Quietmirror/Quietmirror-L2/specs/Quietmirror_L2_r4_CAD_Complete_2026-10-19.md

# Quietmirror L2 r4｜除实物验证外全部 COMPLETED 的执行文件

**日期：** 2026-10-19
**交给：** 建模和发布智能体
**基于：** [Quietmirror/Quietmirror-L2](https://github.com/Quietmirror/Quietmirror-L2) 的 `L2-r3`（main `1ac9de77`，INCOMPLETE 预发布）
**目标：** 修好 `L2-r3` 中所有能在 CAD 里解决的问题，发布 `L2-r4`，状态为 **`CAD_COMPLETE / HARDWARE_PENDING`**。只有必须拿实物才能验证的项目，才允许保留为 `HARDWARE_PENDING`。

**文件地位：**
- 本文取代 `Quietmirror_L2_r3_FINAL_Build_and_Release_2026-10-18.md` 中与本文冲突的部分；其余规则（坐标、D 盘、自适应体积、源码层修改、许可证）继续有效。
- 本文所有设计数据都已写在正文和附录里，**不依赖作者本机文件**。上一轮 INCOMPLETE 的原因之一，就是执行方拿不到作者的 `r3_parameters.json` 和脚本。

---

## 0. 为什么 L2-r3 是 INCOMPLETE，以及本轮怎么处理

作者在本机用发布的 `models/L2_r3/parts/BODY.step` 等文件做了复核和修正试算（本机 64 GB 内存）。

| 门槛 | r3 结果 | 真实原因 | r4 处理 | r4 目标状态 |
|---|---|---|---|---|
| G2 | BODY ↔ WHEEL_CARRIER 0.25 < 0.3 | 这是载架转轴两端（X ±3.35 / ±3.6，Y 47.5–48.8，Z 19）的**轴向端面游隙**，属于功能配合；R3.2 原来只有 0.066 | 列为功能配合，要求 0.20–0.35 | COMPLETED |
| G3 | 电池服务区 0.043、天线禁区 0.175、USB 走线 0.318 | 前两项与 R3.2 原壳**完全相同**（作者复算 0.0426 / 0.1745），而且它们是预留区，不是实体元件；USB 是软线估计路径 | 按 §3 的预留区和走线判据重判；作者证据已写入本文附录 | COMPLETED |
| G4 | 顶面边界等价性未证明 | 缺验证方法 | §4.2 给出逐点验证方法 | COMPLETED |
| G5 | 最小间隙曲线未认证 | 用的是 AABB 下界，不是精确距离 | 逐姿态做精确 BRep 距离，并出曲线 | COMPLETED |
| **G6** | 托架直着往上装，重叠 212 mm³ | **r3 设计缺陷：** 托架两块安装块压在 +X 两耳上面，后右脚垫、后斜撑和新的下横梁又在托架正下方，整块托架不可能从底部装入 | **改结构：** 托架并入 BODY 一起打印，只装小零件（§1） | COMPLETED |
| G7 | H 是估计包络；D 假设板碰撞 | 供体型号未知 | H 按包络判定；D 改为输出“可容纳的最大板外形” | H：COMPLETED；D：DONOR_PENDING |
| **G8** | 求解被内存保护中止 | 执行方机器只有约 16 GB，系统可用内存不足。**更重要的是：** 作者实算发现，发布版 L2 BODY 本身刚度不达标——两侧夹持 75.9%、+X / −X 主键根 89.2% / 94.1%、指压 B 97.4% | 加结构补强（§1 D4–D6）；作者已算三档网格，全部 ≥ 107%（§5） | COMPLETED |
| G9 | S4、S7、S8 未认证 | S8 同 G8；S4 和 S7 可以在 CAD 里完成 | §6 | COMPLETED（实测按压力除外） |
| G10 | PASS（估算） | — | 按 r4 重算 | COMPLETED |
| G11 | 实物未测 | 必须实物 | CAD 部分做完，实物部分标 `HARDWARE_PENDING` | CAD：COMPLETED；实物：HARDWARE_PENDING |

---

## 1. r4 设计修改（在 L2-r3 源码上改，数值见附录 A）

| # | 修改 | 内容 | 解决 |
|---|---|---|---|
| D1 | **侧键托架并入 BODY 一起打印** | 原 SIDE_SWITCH_CARRIER 的底板、减重窗、隔板、两根止挡柱、两块安装块（与 +X 两耳熔合）作为 BODY 特征生成；另加底板到侧壁的 4 段横向腹板（Z 12.1–13.7）和一块连到主键外铰座立耳的连接块。删除 SIDE_SWITCH_CARRIER 零件和两颗 M2 × 5 螺钉 | G6、G8 |
| D2 | **后挡板拆成两个小零件** | SF_RETAINER、SR_RETAINER（附录 A.2），各用 1 颗 M2 × 5 自攻螺钉从 BODY 底部穿过底板 Ø2.2 孔固定，另一端用 Ø1.5 定位销 | G6 |
| D3 | **SIDE_IO_PCB 改为可选** | 默认两颗 D2F-01F 直接焊 32 AWG 线（COM、SF-NO、SR-NO）。PCB 方案不进本版，因为 28 mm 长的硬板无法装入 | G6 |
| D4 | **新增下横梁** | Ø2.0，位于 Y 56、Z 8.6，两侧墙之间贯通，与两根后斜撑相交处熔合 | G8：两侧夹持 |
| D5 | **新增铰座竖撑** | Ø2.4 × 2，位于 (±9.9, 40.8)，Z 7.4–12.0，从下横梁 Y40.8 连到主键内侧固定铰座底部 | G8：主键根、掌压 |
| D6 | **Y67.5 横梁加粗** | r 1.2 → r 1.5 | G8：指压 B |
| D7 | 打印 | BODY 内部新增 Z 12.1 的横隔板：FDM 用树状支撑从底部开口长上来；PA12 SLS 不需要支撑。切片报告里写明支撑区域 | — |

**侧键动作参数不变：** 键帽、D2F-01F、铰轴、推杆、零间隙和止挡贴膜、卡舌，全部沿用 r3 的已发布实现（`cad/l2_r3/side_module.py` 的 `KEYS` 和 `key()`）。

---

## 2. 装配顺序（G6）

1. 两颗 D2F-01F 先焊好导线。
2. 微动从 BODY 底部开口进入，在内侧空间（X 5–17、Z 13.7–19.5）摆正，沿 +X 推入并入 BODY 的开关槽（坐在底板上）。
3. SF_RETAINER、SR_RETAINER 同样从底部进入，沿 +X 贴到开关后面，导线和端子穿过槽口；从底部拧 2 颗 M2 × 5。
4. 键帽从外侧装入（先插卡舌），钢销从顶面窗口压入。
5. 滚轮载架、电子件等按 R3.2 原顺序装配。

**G6 验收：**
- 对每个零件（2 颗微动、2 块挡板、2 只键帽、2 根钢销、4 颗螺钉及螺丝刀轴线），用最终 BODY 做刚体路径检查：平移，加上必要的绕 Z 轴转动（每 5° 一个姿态）。每个姿态都不得穿模，间隙 ≥ 0.25。
- 写出路径点表和截图。
- 已装入的零件要当作后续零件的障碍物。
- 作者的体素宽度优先搜索脚本见附录 C，可以直接复用。注意：作者这次搜索到发文时还没跑完（状态空间很大），**本文没有给出已验证的路径**。执行方必须自己跑出路径；建议先人工给出候选路径点，再逐姿态检查，比全空间搜索快得多。

---

## 3. G2 / G3 判据（写入 INTERFERENCE_REPORT）

| 类别 | 判据 |
|---|---|
| 固定件 ↔ 电子实体件 | 间隙 ≥ 0.5 |
| 活动件 ↔ 任何件（FDM） | ≥ 0.3（扫掠） |
| **功能配合**（单独列表） | 铰链钢销 Ø1.0 / 孔 Ø1.05；滚轮载架转轴端面游隙 0.20–0.35；侧键止挡筋 ↔ 止挡柱在止挡角时接触；卡舌静止时贴端圈；开关坐底板。这些属于有意接触，非螺纹实体相交 ≤ 0.001 mm³ |
| **预留区**（BATTERY_SERVICE、OPTICAL_PATH） | 不得被**其他元件**侵入；BODY 塑料与预留区相交 ≤ 0.001 mm³ 即可，不要求 0.5 间隙 |
| **天线禁区** | 区内不得有导电件（PCB 铜层、金属螺钉、电池、钢销）；塑料 BODY 不受限 |
| **走线**（*_ROUTE_EST） | 不穿模，与实体间隙 ≥ 0.2 |
| 电池本体 | ≥ 0.5（r3 实测 0.6） |

---

## 4. G4、G5 方法

### 4.1 G5 运动

| 运动 | 转轴 | 范围 |
|---|---|---|
| 主键 | 平行于 X，过 (Y 38.5, Z 14.32) | −0.5° 至 3.1° |
| 滚轮载架组 | 平行于 X，过 (Y 50, Z 19) | ±4.4° |
| 侧键 | 竖直，过 (29, 45) / (29, 70) | 0 到止挡（SF +6.80°，SR −6.37°） |

- 每组至少 21 个姿态，逐姿态算**精确** BRep 最小距离，出曲线图。
- 侧键在止挡角处的接触列为功能配合。作者实测，侧键与并入 BODY 的托架之间的间隙：

  | 转角 | 0° | 4° | 6° | 止挡 |
  |---|---:|---:|---:|---:|
  | SF | 1.122 | 0.505 | 0.145 | 0（6.80°） |
  | SR | 0.700 | 0.449 | 0.070 | 0（6.37°） |

  全程无穿模。

### 4.2 G4 顶面窗口等价

1. 对 R3.2 的 6 个窗口，沿每个窗口在外表面上的边界线取 200 个点。
2. 在 L2-r4 BODY 上逐点验证：点到 BODY 表面的距离 ≤ 0.01；沿法向内移 0.2 后的点不在实体内。
3. 再在每个窗口棱柱内取 1,000 个点，确认 L2 在窗口内没有多余材料。
4. 按 r3 方案有意修改的区域（B9 遮罩、O1 / O2 / O4 回填区）单独列出。

---

## 5. G8 整壳刚度（作者已算）

**算法：** 方案 §1.2 的选面、约束和网格设置（附录 B）。R3.2 的两个侧键挡墙工况在 L2 中不存在，不参加比较，侧键受力路径改由 S7 检查。

**几何：** 发布的 `BODY.step` 加上 D1、D4、D5、D6，即附录 A 的 V2。

| 工况 | R3.2 2.4 / 2.0 / 1.6 | L2-r3 发布版 2.4 | **r4（V2）2.4 / 2.0 / 1.6** | r4 最低比值 |
|---|---|---:|---|---:|
| palm_down_20N | 105.64 / 105.97 / 105.04 | 106.18（100.5%） | 143.35 / 144.45 / 142.41 | **136%** |
| left_main_root（+X） | 24.95 / 24.63 / 24.47 | 22.26（89.2%） | 31.70 / 31.28 / 31.54 | **127%** |
| right_main_root（−X） | 24.28 / 23.97 / 23.93 | 22.84（94.1%） | 27.98 / 27.59 / 27.53 | **115%** |
| LC3_squeeze_2x2N | 496.43 / 502.0 / 497.99 | 376.55（75.9%） | 922.03 / 923.32 / 931.07 | **184%** |
| press_A_d16 | 62.21 / 62.15 / 61.77 | 62.92（101.1%） | 74.24 / 74.70 / 73.86 | **119%** |
| press_B_d16 | 56.21 / 53.9 / 55.31 | 54.76（97.4%） | 60.53 / 57.72 / 59.10 | **106.9%** |

- 三档网格全部完成，18 个求解的力和力矩平衡都通过。1.6 mm 档峰值内存 4.99 GB。
- **执行方机器只有约 16 GB：**
  - 关掉其他程序，可用内存 ≥ 10 GB 时再跑；
  - 逐个工况串行，每个工况结束就释放求解器；
  - 求解器用 CalculiX 默认的 SPOOLES 直接法（作者用它跑通了三档）。不要用作者没测过的 iterative 设置。
  - 不得因为内存不够而降档或少跑工况。
- **试算过但没采用的方案：**
  - 只恢复 Y54 外臂：几乎没有作用；
  - 只把后斜撑恢复为圆杆：+0.3%；
  - 托架并入但不加竖撑：主键根只有 95%；
  - 加竖撑但不加粗 Y67.5：指压 B 只有 99.5%。
- **执行方重算 G8 时必须用自己建好的最终 BODY**，和本表偏差 > 3% 时，说明原因。

---

## 6. G9 / S 项

| 项 | 要求 |
|---|---|
| S1 / S2 | G2 和 G5 的数据 |
| S3 | 触发角和止挡角（6.80° / 6.37°）；贴膜调整范围按 ± 0.35 公差链说明 |
| S4 | **CAD 按压力**：按杠杆模型，用 D2F-01F 的 OF ≤ 0.74 N 计算三个位置的按压力（中点 0.74，距铰点 L/4 处 1.28 / 1.29，远端 0.34 / 0.35 N）→ COMPLETED。实物测力 → HARDWARE_PENDING |
| S5 | 镜头高度：按估计镜头加 0.8 mm 脚贴算出几何值 → COMPLETED（CAD）；真实镜头数据 → HARDWARE_PENDING |
| S6 | 电池装拆路径、插头可达性、线束通道（含 D3 侧键 3 根线从开关后方到 RF 板的走线） |
| S7 | 3D FEM：侧键在止挡时 5 N 压在止挡柱上；托架整体看作 BODY 的一部分；再加挡板螺钉预紧。输出位移、P95 应力和三档收敛。要求 P95 ≤ 10 MPa（PLA 许用值的 1/5） |
| S8 | 即 G8 |
| S9 | 逐件 CAD 体积 × 密度，加上切片质量 |

---

## 7. 质量（作者用自适应积分实算）

| 项 | mm³ |
|---|---:|
| L2-r3 打印件合计（发布 CAD 值） | 17,138.86 |
| BODY：r3 11,697.0 → r4 12,643.4 | +946.4 |
| 删除 SIDE_SWITCH_CARRIER | −662.6 |
| SF_RETAINER + SR_RETAINER（未开端子槽） | +264.5 |
| **r4 合计** | **约 17,687 → PA12 约 17.86 g**（R3.2 为 18.69 g） |

比 r3 重约 0.55 g。这是为了让刚度回到 ≥ 100% 所需的材料，必须如实写进 Release 说明。

---

## 8. 建模、视图和发布

1. **修改：** 在 `cad/l2_r3/` 的源码上实现 D1–D6，形成 `cad/l2_r4/`，从源码层重建 BODY。并入的托架作为 BODY 生成步骤的一部分，**不得在成品 BODY 上布尔拼接**。
2. **模型（`models/L2_r4/`）：**
   - 一体式整机 `FULL_ASSEMBLY_H.step` / `.FCStd`，每个组件独立；
   - D 占位：输出 `D_MAX_BOARD_ENVELOPE.step`，即壳内可容纳的最大板外形和孔位范围；
   - 单盘 3MF `L2_r4_H_ALL_PARTS_SINGLE_PLATE.3mf`，零件为 BODY、LEFT_KEY、RIGHT_KEY、SIDE_FRONT_KEY、SIDE_REAR_KEY、SF_RETAINER、SR_RETAINER、WHEEL、WHEEL_CARRIER，真实切片；
   - F2 试验件 3MF；
   - 逐件 STEP / STL。
3. **视图（`views/l2_r4/`）：**
   - 一体式模型的六面视图（同比例）加两张等轴测，以及第三角投影拼图；
   - 内部件六视图；侧键剖面和动作图；
   - **装配路径分步图**（§2）；
   - 打印盘图；r3 与 r4 对比图。
4. **检查：** G1–G11（本文 §0、§2–§6），结果写入 `handoff/l2_r4/` 和 `reports/l2_r4/`。
5. **上传：**
   - 新建分支 `l2-r4`，开 PR 合并到 main，打 tag **`L2-r4`**；
   - Release 标题为 “Quietmirror L2 r4 — CAD COMPLETE / HARDWARE PENDING”。**G1–G10 全部 COMPLETED、G11 的 CAD 部分 COMPLETED 时，发正式 Release，不勾 pre-release**；
   - 说明的第一段列出 HARDWARE_PENDING 清单（§9）；
   - 任何一项 CAD 门槛没过，仍然勾选 pre-release，并写明原因；
   - 本文、附录数据、作者脚本（附录 C）都提交进仓库；
   - 保留历史和许可证。推送前在终端列出文件清单、分支和 tag，完成后回报 PR 链接、Release 链接和 SHA。

---

## 9. 只允许保留的 HARDWARE_PENDING 项

1. 实物侧键：贴膜调整、通断测试、手感（G11 实物部分）；
2. 实测按压力（S4 实物部分）；
3. D2F-01F 实物的 FP / OP / TTP；
4. PAW3950 实际镜头高度（S5 实物部分）；
5. D 方案供体型号确认和主板测绘（DONOR_PENDING）；
6. 无线、续航、DPI、宏等功能验证；
7. 打印实物的称重和装配试装。

除此以外，任何一项写成 INCOMPLETE 或 UNVERIFIED，都视为本轮没有完成。

---

## 附录 A　r4 几何数据（装配坐标，mm）

### A.1 并入 BODY 的侧键托架（D1）

| 特征 | X | Y | Z |
|---|---|---|---|
| 底板 | 17.3–25.5 | 41.8–71.2 | 12.1–13.7 |
| 减重窗 ×2（贯穿底板） | 19.5–23.0 | 46.0–54.0 / 57.5–65.5 | — |
| 隔板 | 19.0–25.5 | 54.95–55.75 | 13.7–19.5 |
| SF 止挡柱 | 下段 25.5–29.45 / 上段 25.5–29.74 | 53.6–55.4 | 下段 12.1–15.7 / 上段 15.7–16.4 |
| SR 止挡柱 | 下段 26.0–29.9 / 上段 26.0–30.04 | 59.1–61.1 | 同上 |
| 前安装块（与前耳熔合） | 24.0–28.2 | 41.8–45.8 | 10.75–13.7 |
| 后安装块（与后耳熔合） | 24.0–29.2 | 64.9–67.9 | 10.75–13.7 |
| 横向腹板 ×4（向外伸入侧壁，用母面外表面裁切） | 25.5 → 侧壁 | 45.8–53.6 / 55.4–59.1 / 61.1–64.9 / 67.9–71.2 | 12.1–13.7 |
| 铰座连接块 | 25.5–27.9 | 41.8–43.25 | 13.7–14.6 |
| 挡板螺钉过孔 Ø2.2（贯穿底板） | 17.9 | 43.0 / 70.4 | — |
| 挡板定位销孔 Ø1.6，深 1.0（底板顶面） | 17.9 | 54.0 / 56.5 | — |

**作者验证（`l2_r4/v2_interference.json`、`side_key_stop_check.json`）：**
- 与全部电子包络、主键扫掠、滚轮载架组扫掠、钢销之间的最小间隙：0.62（RF 传感器排针 ↔ 加粗的 Y67.5）、0.71（托架 ↔ 主键）、1.05（托架 ↔ 竖直钢销）；
- 侧键只在止挡角处接触；
- 开关坐在底板上，属于有意接触。

### A.2 后挡板（D2，PLA 单独打印）

| 零件 | 主体 | 螺钉凸台 | 自攻孔（从底面，Ø1.7 深 3） | 定位销 Ø1.5 × 1.0 | 端子槽（1.6 宽 × 1.2 高，Z 16.0–17.2） |
|---|---|---|---|---|---|
| SF_RETAINER | X 17.3–18.5、Y 41.8–55.3、Z 13.7–19.5 | X 16.6–18.5、Y 41.8–44.6、Z 13.7–17.2 | (17.9, 43.0) | (17.9, 54.0) | Y 43.17、48.25、53.33 |
| SR_RETAINER | X 17.3–19.0（含背托台 18.5–19.0）、Y 55.3–71.2 | X 16.6–18.5、Y 68.4–71.2 | (17.9, 70.4) | (17.9, 56.5) | Y 57.37、62.45、67.53 |

### A.3 BODY 补强（D4–D6）

| 构件 | 尺寸 |
|---|---|
| 下横梁 | Ø2.0，轴线 Y 56、Z 8.6，X 从 −40 到 +40，用母面外表面裁切 |
| 竖撑 | Ø2.4，中心 (±9.9, 40.8)，Z 7.4–12.0 |
| Y67.5 横梁 | 轴线 Y 67.5、Z 23.0，半径 1.5，用母面外表面裁切 |

## 附录 B　G8 定义（与 FINAL 方案 §1.2 相同）

**材料和约束：** E 1500 MPa，ν 0.35，C3D10 单元。五个脚底面节点 Uz = 0；左前脚附近一个节点 Ux = Uy = 0；右前脚附近一个节点 Uy = 0。
**刚度：** k = F / δ，δ = Σ(f·u) / F，夹持工况取 F = 4。

| 工况 | 选面条件 | 合力 N |
|---|---|---|
| palm_down_20N | 44 ≤ y ≤ 71，\|x\| ≤ 24，z ≥ 23，nz > 0.3，外顶面（\|z − roof_z\| < 0.35） | (0, 0, −20) |
| left / right_main_root | 35.5 ≤ y ≤ 42.5，6 ≤ \|x\| ≤ 24，z ≥ 11，nz > 0.2 | (0, 0, −5) |
| LC3_squeeze_2x2N | \|x\| > 20，45 ≤ y ≤ 70，8 ≤ z ≤ 14，\|nx\| > 0.5，只取外侧面，两侧各 2 N 相向 | 自平衡，F = 4 |
| press_A / B_d16 | 以 (14, 60) / (−14, 72) 为圆心、半径 8 的圆内，z ≥ 18，nz > 0.3，外顶面 | (0, 0, −5) |

**网格：** gmsh 4.15.2，MeshSizeMax = h，MeshSizeMin = max(0.35, 0.38h)，MeshSizeFromCurvature = 24，MeshSizeExtendFromBoundary = 1，Algorithm = 6，Algorithm3D = 1，ElementOrder = 2，SecondOrderLinear = 1，Optimize = 1；h = 2.4 / 2.0 / 1.6。

## 附录 C　作者脚本（随本文一起提交进仓库）

| 本机位置 | 提交到 |
|---|---|
| `D:\Quietmirror_L2\fem3d\` 下的 `fem_variants.py`、`fem_l2.py`、`l2_frame_variant.py`、`l2_v_variants.py`、`r4_frame.json` | `cad/l2_fem_author/` |
| `D:\Quietmirror_L2\l2_r4\` 下的 `path_check.py`、`loose_parts.json`、`v2_interference.py`、`side_key_stop_check.py`、`gap_locate.py`，以及结果 JSON | `cad/l2_r4_author/` |
| `D:\Quietmirror_L2\l2_r3_check\`（r3 侧键模块数据和检查） | `cad/l2_r3_check/` |

如果执行方拿不到这些文件，本文附录 A 和 B 已经足够独立重建全部结果。
