Quietmirror/Quietmirror-L2/specs/Quietmirror_L2_r4_EXECUTE_ALL_2026-10-19.md

# Quietmirror L2 r4｜一次执行到底（建模 + 检查 + 视图 + 发布）

**交给：** 建模和发布智能体
**日期：** 2026-10-19
**仓库：** [Quietmirror/Quietmirror-L2](https://github.com/Quietmirror/Quietmirror-L2)

| 分支 | 内容 |
|---|---|
| `main`（`1ac9de77`） | 已发布的 `L2-r3`（INCOMPLETE 预发布） |
| `l2-r4`（`54dac615`） | 作者证据包：脚本、结果 JSON、并入托架的几何 |

**目标：** 发布 **`L2-r4`**，状态写成 **`CAD_COMPLETE / HARDWARE_PENDING`**。只有 §9 列出的实物项目可以留到以后。

**本文自成一体：** 所有设计数据、判据、路径和参考结果都写在正文和附录里。执行时不需要作者本机的任何文件。作者的脚本和结果也放在 `l2-r4` 分支里，可以直接拿来对照。

---

## 0. 执行规则（必须遵守）

1. **一次做完：** 按 §2 的步骤顺序执行，**不要停下来等确认**。只有满足下面任一条件时才停下来问用户：
   - 本文和仓库事实冲突，而且无法自行判断哪个对；
   - 需要删除仓库历史，或者覆盖 `L2-r3` 的 tag 或 Release。
2. **失败就修，修完重验：** 任何门槛不过，先定位原因，修改模型（只能在源码层改），然后重跑**该门槛和所有受影响的门槛**。每一轮都写进 `handoff/l2_r4/TUNING_LOG.md`。
3. **不得降低标准：**
   - 不得放宽判据；
   - 不得把 CAD 能验证的项目改标 `HARDWARE_PENDING`；
   - 不得用 AABB 下界冒充精确距离；
   - 不得因为内存不足而少跑网格或工况；
   - 不得编造数值。
4. **资源：**
   - 有限元串行跑，开始前关掉其他程序，确认可用内存 ≥ 10 GB；
   - 求解器用 CalculiX 默认的 SPOOLES 直接法；
   - 如果被系统中止，查明原因后重跑同一档，不得跳过。
5. **体积：** 一律用 `BRepGProp.VolumeProperties_s(shape, props, 1e-8, True, False)`。
6. **基准：**
   - 以 `L2-r3` 源码（`cad/l2_r3/`）为起点，产出 `cad/l2_r4/`；
   - R3.2 原始基准是 Quietmirror/github @ `f1b1090931d717117287ea2b79c2e14ddc234937`；
   - 坐标沿用 R3.2：+X 为拇指侧（侧键侧），Y 值小的一端为前，Z 向上；脚贴粘贴面 Z 5.2。

---

## 1. 为什么要做 r4（结论已经由作者实算）

| L2-r3 的问题 | 原因 | r4 的解决方法 |
|---|---|---|
| G6：托架装不进去（直上重叠 212 mm³） | 托架两块安装块压在 +X 两耳上面，后右脚垫和后斜撑又在托架正下方，整块托架不可能装入 | **托架并入 BODY 一起打印**，需要装入的只剩小零件；装入路线已经验证（§4） |
| G8：整壳刚度不达标（执行方因内存不足没有算出来） | 作者用发布的 BODY 实算（2.4 mm 网格）：两侧夹持 75.9%、+X / −X 主键根 89.2% / 94.1%、指压 B 97.4%。原因是拆掉旧侧键座后 +X 侧壁变软，同时内侧固定铰座被削掉了 0.25 mm | 托架并入 BODY，再加下横梁、铰座竖撑，并把 Y67.5 横梁加粗；三档网格全部 ≥ 106.9%（§5） |
| G2：BODY ↔ 滚轮载架 0.25 | 这是转轴的轴向端面游隙，属于功能配合 | 按功能配合判，要求 0.20–0.35 |
| G3：电池服务区、天线禁区、USB 走线间隙不足 | 前两项和 R3.2 原壳完全相同，而且是预留区，不是实体；USB 是软线 | 按 §6 的预留区和走线判据 |
| G4、G5：证明方法不够 | — | 按 §6 的方法做 |

---

## 2. 执行步骤

| 步 | 做什么 | 产出 | 通过标准 |
|---|---|---|---|
| S0 | 拉取 `main` 和 `l2-r4`；建工作分支 `l2-r4-build`（基于 `main`）；把 `l2-r4` 分支里的 `specs/`、`cad/l2_r4_author/`、`cad/l2_fem_author/`、`cad/l2_r3_check/` 合入工作分支 | 工作分支 | 文件齐全 |
| S1 | 在 `cad/l2_r3/` 源码上实现附录 A 的 D1–D6，形成 `cad/l2_r4/`，从源码层重建 BODY。托架作为 BODY 生成步骤的一部分生成，不得在成品 BODY 上布尔拼接 | `BODY.step` | 单一有效实体；能用 gmsh 生成网格 |
| S2 | 建 SF_RETAINER、SR_RETAINER（附录 A.2）；删除 SIDE_SWITCH_CARRIER、两颗 CARRIER_M2x5 螺钉和 SIDE_IO_PCB；其余零件沿用 L2-r3 | 逐件 STEP / STL | 每件都是单一有效实体 |
| S3 | 组装一体式模型（§7）；H 方案的电子包络沿用 L2-r3；加入 2 根侧键焊线的走线（附录 A.4） | `FULL_ASSEMBLY_H.step` / `.FCStd` | 89 个以上独立组件，全部有效 |
| S4 | 跑 G1–G5（§6） | `reports/l2_r4/*.json`、`INTERFERENCE_REPORT.md` | §6 判据 |
| S5 | 跑 G6（§4）：按给定装配顺序和路线逐姿态检查 | `ASSEMBLY_SEQUENCE.md` + 分步截图 | §4 判据 |
| S6 | 跑 G8 / S7（§5、§6） | `INTERNAL_COMPONENTS_SIMULATION.md` + 数据 | 每个工况三档网格都 ≥ R3.2 的 100%；S7 的 P95 ≤ 10 MPa |
| S7 | G7、G9、G10、G11-CAD（§6） | 对应报告 | §6 |
| S8 | 切片（§7） | 单盘 3MF + `SLICE_REPORT.md` | 真实切片，一个盘放下全部零件 |
| S9 | 视图（§8） | `views/l2_r4/` | 六面视图 + 等轴测 + 拼图齐全 |
| S10 | 门槛总表（G1–G11）。有任何 CAD 门槛不过，回到对应步骤修改，**不得进入 S11** | `handoff/l2_r4/GATES.md` | 所有 CAD 门槛 COMPLETED |
| S11 | 发布（§10） | PR、tag `L2-r4`、Release | §10 |
| S12 | 回报（§11） | 消息 | — |

---

## 3. r4 设计（摘要；数值见附录 A）

| # | 修改 |
|---|---|
| D1 | **侧键托架并入 BODY**：底板、减重窗、隔板、两根止挡柱、两块安装块（与 +X 两耳熔合）、4 段横向腹板（底板到侧壁）、主键外铰座连接块 |
| D2 | **后挡板拆成两件**（SF_RETAINER、SR_RETAINER），各用 1 颗 M2 × 5 自攻螺钉从底部穿过底板固定，另一端用定位销 |
| D3 | **默认不用 SIDE_IO_PCB**：两颗 D2F-01F 直接焊 32 AWG 线（COM、SF-NO、SR-NO） |
| D4 | **下横梁** Ø2.0，Y 56 / Z 8.6，贯穿两侧墙 |
| D5 | **铰座竖撑** Ø2.4 × 2，位于 (±9.9, 40.8)，Z 7.4–12.0 |
| D6 | **Y67.5 横梁** r 1.2 → r 1.5 |
| D7 | **侧键键帽改为直线装入**：取消远端卡舌，铰轴内移 0.3（SF Y 45.3、SR Y 69.7），铰节 Ø2.5，新增铰链止动耳和铰耳扇形槽，推杆压盘 Ø2.6（§4.4） |

D2F-01F、推杆位置、零间隙和止挡贴膜，沿用 L2-r3 已发布的实现（`cad/l2_r3/side_module.py`），按 D7 修改。

---

## 4. G6 装配顺序和装入路线（作者已验证）

**验证方法：**
- V2 BODY（= 发布的 BODY 加 D1、D4、D5、D6）三角化后，用竖直射线奇偶法体素化，体素 0.25 mm；
- 再整体膨胀 0.25 mm，相当于要求间隙 ≥ 0.25；
- 零件用 0.25 mm 间距的内部点云表示；
- 平移每 0.25 mm 检查一个姿态，绕 Z 轴转动每 5° 检查一个姿态；
- 已装好的零件计为后续零件的障碍物。微动端子穿过挡板槽口属于设计配合，不计碰撞。

**结果：** 共 759 个姿态，**全部无碰撞**。

### 4.1 顺序

1. 两颗 D2F-01F 先焊好导线；
2. **SR 微动** → 3. **SF 微动** → 4. **SR 挡板** → 5. **SF 挡板**，四件都从 BODY 底部开口进入；
6. 从底部拧 2 颗 M2 × 5，固定两块挡板；
7. 键帽从外侧沿 −X 直线推入（D7，§4.4）。推杆压盘上的 PET 调整膜在推入前贴好；
8. 钢销从顶面窗口压入；
9. 其余按 R3.2 原顺序装配（滚轮载架、主键微动、主键、电子件）。

> 顺序不能换：SF 微动的路线会经过 SR 挡板的位置，所以 SF 微动必须先于 SR 挡板装入。

### 4.2 路线

表中坐标是零件**相对最终位置的偏移**（mm）。yaw 是绕零件中心竖直轴的转角（°）。路线按“从壳外到装好”的顺序列出。

**SR 微动**（最终本体 X 19.0–25.5、Y 56.05–68.85、Z 13.7–19.5）：

(−16.25, 1.55, −14.75, 90) → (−16.25, 1.55, −10.5, 90) → (−16.25, 1.8, −10.5, 90) → 原地转到 yaw 0 → (−16.25, 1.8, +0.5, 0) → (−16.25, 0, +0.5, 0) → (−0.5, 0, +0.5, 0) → 落座

**SF 微动**（最终本体 X 18.5–25.0、Y 41.85–54.65、Z 13.7–19.5）：

(−15.75, 15.75, −14.75, 90) → (−15.75, 15.75, −10.5, 90) → (−15.75, 16.0, −10.5, 90) → 转到 yaw 0 → (−15.75, 16.0, +0.25, 0) → (−15.75, 13.0) → (−12.5, 13.0) → (−12.5, 12.75) → (−12.25, 12.75) → (−12.25, 9.5) → (−8.75, 9.5) → (−8.75, 9.25) → (−8.5, 9.25) → (−8.5, 3.0) → (−6.75, 3.0) → 转到 yaw 90 → (−6.75, 2.0) → (−5.25, 2.0) → (−5.25, 1.75) → (−5.0, 1.75) → (−5.0, −0.5) → (−3.25, −0.5) → 转回 yaw 0 → (−3.25, −0.5, +0.5) → (−3.25, 0, +0.5) → (−0.5, 0, +0.5) → 落座

中间各点 Z 均为 +0.25。

**SR 挡板：**

(−12.15, 2.2, −14.75, 0) → (−12.15, 2.2, +0.3, 0) → (−12.15, 0, +0.3, 0) → (−4.5, 0, +0.3, 0) → (−0.3, 0, +0.3, 0) → 落座

**SF 挡板：**

(−11.85, 15.8, −14.75, 90) → (−11.85, 15.8, −10.5, 90) → (−11.85, 16.05, −10.5, 90) → 转到 yaw 0 → (−11.85, 16.05, +0.3, 0) → (−11.85, 13.0) → (−10.3, 13.0) → (−10.3, 9.5) → (−6.5, 9.5) → (−6.5, 2.0) → (−4.5, 2.0) → (−4.5, 0) → (−0.3, 0, +0.3) → 落座

**执行方要做的：**
- 用最终 BODY 和最终零件，以同样的方法重跑这些路线：脚本是 `cad/l2_r4_author/guided_paths.py`，路线数据 `guided_routes.json`，零件数据 `loose_parts.json`；
- 再对每条路线的转折点做**精确** BRep 距离复核；
- 如果最终 BODY 有偏差导致碰撞，在碰撞点附近局部调整路线点，并记录调整内容。

### 4.3 键帽、钢销、螺钉

- **键帽：改为沿 −X 直线推入（r4 设计修改 D7，见 §4.4 和附录 A.6）。** 原来那条“先插卡舌”的路线已被作者证明不可行（§4.4），所以取消远端卡舌，把外向限位改到铰链处。
- **钢销：** 从顶面窗口竖直压入。执行方在 L2-r3 已用 Ø2 探针验证可达，r4 要用最终 BODY 复验。
- **挡板螺钉：** 竖直从底部拧入，位置 (17.9, 43.0) 和 (17.9, 70.4)。螺丝刀轴线（Ø4 圆柱，从 Z 0 到 12.1）不得碰到 BODY。

### 4.4 键帽路线的精确复核（作者）

**作者的精确 BRep 复核（`cad/l2_r4_author/key_paths_exact.py`）：** 用 L2-r3 发布的键帽和 V2 BODY，检查“先插卡舌”路线：绕卡舌附近的竖直轴把铰链端向外摆出 15°，沿 Y 滑出 1.5，再沿 +X 移出。

**结论：不可行。**

| | 转 2° | 转 3° | 转 15° | 滑出和移出阶段 |
|---|---:|---:|---:|---:|
| SF 相交体积 mm³ | 0.0007 | 0.037 | 2.04 | 仍有 0.01–0.16 |
| SR 相交体积 mm³ | 0.0019 | 0.049 | 2.02 | 0.08–0.44 |

**原因：**
- 卡舌在 Y 向伸到端圈后面 0.5 mm（SF 卡舌末端 Y 57.1，端圈从 Y 56.6 开始），可开口在 Y 向只有 ±0.3 mm 余量，平移解不开；
- 铰链端紧贴开口边，铰节（Ø2.65，中心 Y 45）的前缘 Y 43.675 已经在开口起点 Y 43.9 之外；
- 绕卡舌转出时，连接筋会扫进隔墙端圈。

**r4 修改 D7（执行方实现并验证）：**
1. **取消**远端外向限位卡舌和连接筋（SF、SR 都取消）。
2. **铰轴向开口内移 0.3 mm：** SF 铰轴 (29.0, **45.3**)，SR 铰轴 (29.0, **69.7**)。BODY 上的上下铰耳和钢销孔随之移动。
3. **铰节改为 Ø2.5**（钢销孔 Ø1.05 不变，孔壁 0.725）。这样铰节前缘为 SF Y 44.05、SR 后缘 Y 70.95，都在开口之内（余量 0.15），键帽可以沿 −X 直线穿过开口。
4. **铰链止动耳（新的外向限位）：**
   - 键帽铰节顶端加一个径向止动耳：Z 19.85–20.75，宽 0.8，从铰轴伸到半径 2.3，静止时朝 +X；
   - BODY 上铰耳开一条朝 +X 敞开的装入槽：宽 1.0（Y = 铰轴 Y ± 0.5），从铰轴到上铰耳外端，止动耳沿 −X 滑进去；
   - 再在槽里铣出一个扇形让位：从静止的 0° 到按压方向 +8°（SF 为绕 +Z 的正角，SR 为负角）；
   - 向外转动时，止动耳碰到槽的另一侧壁停住，止挡角 ≤ 0.5°；
   - 静止时由微动按钮的零间隙轻微预压，把止动耳压在止挡面上，不会晃动。
5. **推杆压盘从 Ø3.0 改为 Ø2.6**（球冠半径和高度按比例缩小）。原来的 Ø3.0 下缘在 Z 15.1，低于开口下沿 Z 15.2，直推时会擦到。改小后，止挡时 0.40 mm 的滑移内压盘仍然压在按钮上（按钮 Ø2.0）。
6. **动作参数重算：** 力臂变为 SF 4.95、SR 5.25。推杆处行程 0.60 不变，所以止挡角约为 SF 6.96°、SR 6.56°。执行方按实际铰轴做刚体旋转重算，再更新 §6 的 G5 和 S3 / S4，以及止挡柱、止挡筋的位置。

**装入路线（D7 之后）：**
- 键帽从壳外沿 −X 直线推入，直到铰节到达铰轴、止动耳进入槽内；
- 钢销从顶面窗口压入；
- 然后装入微动并做零间隙调整，预压使止动耳靠上止挡。

**执行方验证：**
- 对 −X 直推的每个姿态（每 0.25 mm），用**精确 BRep** 算键帽与 BODY 的相交体积，必须 ≤ 0.001 mm³；
- 0 到止挡的按压扫掠也要重做（G5）；
- 体素法在 0.3 mm 配合处会出现假碰撞（作者遇到过），不能作为结论。
- 改完后，检查开口、铰耳、扇形槽在 BODY 外表面都不可见（不破皮）。

---

## 5. G8 整壳刚度（作者已算；执行方必须用最终 BODY 重算）

**算法：** 方案 §1.2 的工况（附录 B）。R3.2 的两个侧键挡墙工况在 L2 中已不存在，侧键受力路径改由 S7 检查。

| 工况 | R3.2 2.4 / 2.0 / 1.6 | L2-r3 发布版 2.4 | **r4（V2）2.4 / 2.0 / 1.6** | 最低比值 |
|---|---|---:|---|---:|
| palm_down_20N | 105.64 / 105.97 / 105.04 | 106.18 | 143.35 / 144.45 / 142.41 | 136% |
| left_main_root（+X） | 24.95 / 24.63 / 24.47 | 22.26 | 31.70 / 31.28 / 31.54 | 127% |
| right_main_root（−X） | 24.28 / 23.97 / 23.93 | 22.84 | 27.98 / 27.59 / 27.53 | 115% |
| LC3_squeeze_2x2N | 496.43 / 502.0 / 497.99 | 376.55 | 922.03 / 923.32 / 931.07 | 184% |
| press_A_d16 | 62.21 / 62.15 / 61.77 | 62.92 | 74.24 / 74.70 / 73.86 | 119% |
| press_B_d16 | 56.21 / 53.9 / 55.31 | 54.76 | 60.53 / 57.72 / 59.10 | 106.9% |

- 18 个求解的力和力矩平衡全部通过；1.6 mm 档峰值内存 4.99 GB。
- 全部试验件和工况的数据在 `cad/l2_fem_author/fem_r4_results.json`。
- **执行方重算：** 和本表偏差 > 3% 时要查明原因。任何工况 < 100%，就加强最近的传力件后重算，并记入 TUNING_LOG。

---

## 6. 门槛判据

| 门槛 | 判据 |
|---|---|
| G1 | 每个打印件都是单一有效实体、闭合网格 |
| G2 静态干涉 | 两两求交 ≤ 0.001 mm³；固定件 ↔ 电子实体 ≥ 0.5；活动件 ≥ 0.3（扫掠）。**功能配合单独列出**：钢销 Ø1.0 / 孔 Ø1.05；滚轮载架转轴端面游隙 0.20–0.35；侧键止挡筋 ↔ 止挡柱在止挡角时接触；铰链止动耳静止时贴槽壁；开关坐在底板上；挡板贴在开关背面 |
| G3 电子 | 电池本体 ≥ 0.5；BATTERY_SERVICE 和 OPTICAL_PATH 预留区不被其他元件侵入（塑料 BODY 与之相交 ≤ 0.001 mm³ 即可）；天线禁区内不得有导电件（塑料 BODY 不受限）；走线（*_ROUTE_EST）不穿模，间隙 ≥ 0.2 |
| G4 顶面窗口 | 对 R3.2 的 6 个窗口，沿边界线各取 200 个点：点到 L2 BODY 表面的距离 ≤ 0.01；沿法向内移 0.2 后不在实体内；每个窗口棱柱内取 1,000 个点，都不在实体内。按方案有意修改的区域单独列出 |
| G5 运动 | 主键：转轴平行于 X、过 (Y 38.5, Z 14.32)，−0.5°…3.1°；滚轮载架组：转轴平行于 X、过 (Y 50, Z 19)，±4.4°；侧键：D7 之后的竖直轴过 (29, 45.3) / (29, 69.7)，从外向止挡（≤ 0.5°）扫到按压止挡（约 SF +6.96°、SR −6.56°，按实际几何重算），再加 0.3° 余量。每组 ≥ 21 个姿态，逐姿态算**精确** BRep 最小距离并出曲线。作者在 D7 之前（铰轴 Y 45 / 70）的结果是：间隙从 1.12 / 0.70 均匀缩小，在止挡角处变为 0，全程无穿模；D7 之后必须重做 |
| G6 | §4 |
| G7 | H：估计包络全部满足 G2 / G3；D：输出 `D_MAX_BOARD_ENVELOPE.step`（壳内可容纳的最大板外形和孔位范围），状态 DONOR_PENDING |
| G8 | §5：每个工况三档网格都 ≥ R3.2 的 100% |
| G9 | S1–S9。S4 CAD：用 D2F-01F（OF ≤ 0.74 N）按杠杆模型算三处按压力（中点 0.74 N；距铰点 L/4 处 1.28 / 1.29 N；远端 0.34 / 0.35 N）。S5 CAD：按估计镜头加 0.8 mm 脚贴算几何高度。S7：3D 有限元，侧键在止挡时 5 N 压在止挡柱上，加挡板螺钉预紧，三档网格，P95 ≤ 10 MPa |
| G10 | 逐件 CAD 体积 × 密度，加上切片质量；参考值约 17.86 g（PA12），见附录 A.7 |
| G11-CAD | G5 侧键部分通过；按 D7 的铰轴重算推杆端滑移，Ø2.6 压盘在整个滑移范围内始终盖住按钮；PET 贴膜调整范围覆盖 ± 0.35 mm 公差链；铰链止动耳的外向止挡 ≤ 0.5° |

---

## 7. 模型文件（`models/L2_r4/`）

| 文件 | 内容 |
|---|---|
| `FULL_ASSEMBLY_H.step` / `.FCStd`（+ 可选 `.glb`） | 一体式整机：全部打印件、D2F-01F × 2、侧键焊线（简化为 Ø0.6 管）、钢销、螺钉、H 电子包络、脚贴 0.8 mm。**每个组件独立** |
| `D_MAX_BOARD_ENVELOPE.step` | D 方案：可容纳的最大板外形 |
| `L2_r4_H_ALL_PARTS_SINGLE_PLATE.3mf` | 单盘：BODY、LEFT_KEY、RIGHT_KEY、SIDE_FRONT_KEY、SIDE_REAR_KEY、SF_RETAINER、SR_RETAINER、WHEEL、WHEEL_CARRIER。Dremel 3D45 床尺寸 255 × 155（配置假设），PLA 0.4 / 0.2，PrusaSlicer 2.9.6，真实切片，不缩放，零件间距 ≥ 5。BODY 内部 Z 12.1 的横隔板需要树状支撑，从底部开口长上来 |
| `SIDE_MODULE_F2_TRIAL.3mf` | F2 试验键帽 |
| `parts/*.step`、`parts/*.stl` | 逐件文件 |
| `SLICE_REPORT.md` | 每个零件的打印方向、支撑区域、质量和时长；排盘截图 |

---

## 8. 视图（`views/l2_r4/`，全部从一体式模型渲染）

1. **六面正交视图：** 前（从 −Y）、后（从 +Y）、左（从 −X）、右（从 +X）、上（从 +Z）、下（从 −Z）。比例相同（9 px/mm），标注外形尺寸、坐标轴和 10 mm 比例尺；
2. **等轴测：** 前 / +X / 上，以及后 / −X / 上，各一张；
3. **拼图：** 按第三角投影排布成 `L2_r4_H_SIX_VIEWS_SHEET.png`，附图例；
4. 去掉 BODY 的内部件六视图；
5. 侧键剖面（Z 16.6 水平；Y 50.25 / 64.45 竖直），以及侧键动作图（静止 / 触发 / 止挡叠画）；
6. **装配路线分步图**：§4.2 每个零件取 4–6 个关键姿态；
7. 打印盘图；r3 与 r4 对比图（顶、右、底）。

---

## 9. 只允许保留的 HARDWARE_PENDING 项

1. 实物侧键：贴膜调整、通断测试、手感；
2. 实测按压力；
3. D2F-01F 实物的 FP / OP / TTP；
4. PAW3950 实际镜头高度；
5. D 方案供体型号确认和主板测绘（DONOR_PENDING）；
6. 无线、续航、DPI、宏等功能验证；
7. 打印实物的称重和试装。

---

## 10. 发布

1. 推送前在终端列出：文件清单、分支名、tag 名。
2. 把工作分支 `l2-r4-build` 推送到仓库，开 PR 合并到 `main`。PR 描述包括：G1–G11 门槛表（数值和结论）、六视图拼图、HARDWARE_PENDING 清单。
3. 合并后打 tag **`L2-r4`**，创建 Release “**Quietmirror L2 r4 — CAD COMPLETE / HARDWARE PENDING**”：
   - **所有 CAD 门槛都 COMPLETED：正式 Release，不勾 pre-release**；
   - 否则不得发布（回到 S10）。
4. Release 附件：
   - 单盘 3MF、`FULL_ASSEMBLY_H.step`、`FULL_ASSEMBLY_H.FCStd`；
   - 六视图拼图；
   - 逐件 STEP / STL 压缩包；
   - `FINAL_ACCOUNTING.json`；
   - `GATES.md`。
5. **不得删除或改写：** `L2-r3` 的 tag 和 Release、`l2-r4` 证据分支、任何历史提交。
6. 保留 CERN-OHL-P-2.0 许可证和原 NOTICE 署名。

---

## 11. 回报给用户

1. G1–G11 门槛表（数值和结论）；
2. 与本文参考值的偏差，以及原因；
3. 六视图拼图（直接贴图）；
4. 质量（CAD 和切片），切片时长；
5. 分支、PR、tag、Release 链接和 commit SHA；
6. HARDWARE_PENDING 清单（只能是 §9 中的项目）。

---

## 附录 A　r4 几何（装配坐标，mm）

### A.1 并入 BODY 的托架（D1）

| 特征 | X | Y | Z |
|---|---|---|---|
| 底板 | 17.3–25.5 | 41.8–71.2 | 12.1–13.7 |
| 减重窗 ×2（贯穿底板） | 19.5–23.0 | 46.0–54.0 / 57.5–65.5 | — |
| 隔板 | 19.0–25.5 | 54.95–55.75 | 13.7–19.5 |
| SF 止挡柱 | 下段 25.5–29.45 / 上段 25.5–29.74 | 53.6–55.4 | 下段 12.1–15.7 / 上段 15.7–16.4 |
| SR 止挡柱 | 下段 26.0–29.9 / 上段 26.0–30.04 | 59.1–61.1 | 同上 |
| 前安装块（与前耳熔合） | 24.0–28.2 | 41.8–45.8 | 10.75–13.7 |
| 后安装块（与后耳熔合） | 24.0–29.2 | 64.9–67.9 | 10.75–13.7 |
| 横向腹板 ×4（伸入侧壁，用母面外表面裁切） | 25.5 → 侧壁 | 45.8–53.6 / 55.4–59.1 / 61.1–64.9 / 67.9–71.2 | 12.1–13.7 |
| 铰座连接块 | 25.5–27.9 | 41.8–43.25 | 13.7–14.6 |
| 挡板螺钉过孔 Ø2.2（贯穿底板） | 17.9 | 43.0 / 70.4 | — |
| 挡板定位销孔 Ø1.6，深 1.0 | 17.9 | 54.0 / 56.5 | — |

作者的干涉复核（`cad/l2_r4_author/v2_interference.json`）：与全部电子包络、主键扫掠、滚轮载架组扫掠和钢销的最小间隙是 0.62 / 0.71 / 1.05；侧键只在止挡角处接触。

### A.2 后挡板（D2，单独打印）

| 零件 | 主体 | 螺钉凸台 | 自攻孔（从底面，Ø1.7 深 3） | 定位销 Ø1.5 × 1.0 | 端子槽（1.6 × 1.2，Z 16.0–17.2） |
|---|---|---|---|---|---|
| SF_RETAINER | X 17.3–18.5、**Y 41.8–55.0**、Z 13.7–19.5 | X 16.6–18.5、Y 41.8–44.6、Z 13.7–17.2 | (17.9, 43.0) | (17.9, 54.0) | Y 43.17、48.25、53.33 |
| SR_RETAINER | X 17.3–19.0（含背托台 18.5–19.0）、Y 55.3–71.2、Z 13.7–19.5 | X 16.6–18.5、Y 68.4–71.2、Z 13.7–17.2 | (17.9, 70.4) | (17.9, 56.5) | Y 57.37、62.45、67.53 |

两半挡板之间留 0.3 mm 间隙（Y 55.0 / 55.3）。不留间隙的话，并排推入时会擦到已装好的 SR 挡板。

### A.3 BODY 补强（D4–D6）

| 构件 | 尺寸 |
|---|---|
| 下横梁 | Ø2.0，轴线 Y 56、Z 8.6，X −40…+40，用母面外表面裁切 |
| 竖撑 | Ø2.4，中心 (±9.9, 40.8)，Z 7.4–12.0 |
| Y67.5 横梁 | 半径 1.5，轴线 Y 67.5、Z 23.0，用母面外表面裁切 |

### A.4 侧键焊线（D3）

- 每颗开关的 COM 和 NO 端子焊 32 AWG 硅胶线；两颗开关的 COM 并联。
- 3 根线从挡板后方（X < 16）沿 Z 16–19 走向 RF / MCU 板的 GPIO 焊盘（RF 板约在 (4, 64, 18.5)）。
- 走线在模型里简化为 Ø0.6 管，按 G3 的走线判据检查。

### A.6 侧键键帽和铰链（D7）

| 项 | SF | SR |
|---|---|---|
| 铰轴（竖直钢销 Ø1.0 × 5.5） | (29.0, 45.3) | (29.0, 69.7) |
| 铰节 | Ø2.5，Z 15.5–19.5，孔 Ø1.05 | 同左 |
| 上 / 下铰耳（BODY） | 与 L2-r3 相同（Z 14.2–15.2 / 19.8–20.8），只是随铰轴移动 | 同左 |
| 止动耳（键帽） | Z 19.85–20.75，宽 0.8，径向伸到 r 2.3，静止时朝 +X | 同左 |
| 装入槽 + 扇形让位（上铰耳） | 宽 1.0，朝 +X 敞开；扇形从 0° 到 +8°（绕 +Z） | 扇形从 0° 到 −8° |
| 外向止挡角 | ≤ 0.5° | 同左 |
| 远端卡舌、连接筋 | **取消** | **取消** |
| 推杆压盘 | Ø2.6 球冠 | 同左 |
| 力臂 / 止挡角（推杆处 0.60） | 4.95 / 约 6.96° | 5.25 / 约 6.56° |

### A.7 质量（作者用自适应积分实算）

| 项 | mm³ |
|---|---:|
| L2-r3 打印件合计 | 17,138.86 |
| BODY：11,697.0 → 12,643.4 | +946.4 |
| 删除 SIDE_SWITCH_CARRIER | −662.6 |
| 两块挡板（未开端子槽） | 约 +261 |
| **r4 合计** | **约 17,684 → PA12 约 17.86 g**（R3.2 为 18.69 g） |

## 附录 B　G8 定义

**材料和约束：** E 1500 MPa，ν 0.35，C3D10 单元。五个脚底面节点 Uz = 0；左前脚附近一个节点 Ux = Uy = 0；右前脚附近一个节点 Uy = 0。
**刚度：** k = F / δ，δ = Σ(f·u) / F，夹持工况取 F = 4。

| 工况 | 选面条件 | 合力 N |
|---|---|---|
| palm_down_20N | 44 ≤ y ≤ 71，\|x\| ≤ 24，z ≥ 23，nz > 0.3，外顶面（\|z − roof_z\| < 0.35） | (0, 0, −20) |
| left / right_main_root | 35.5 ≤ y ≤ 42.5，6 ≤ \|x\| ≤ 24，z ≥ 11，nz > 0.2 | (0, 0, −5) |
| LC3_squeeze_2x2N | \|x\| > 20，45 ≤ y ≤ 70，8 ≤ z ≤ 14，\|nx\| > 0.5，只取外侧面，两侧各 2 N 相向 | 自平衡，F = 4 |
| press_A / B_d16 | 以 (14, 60) / (−14, 72) 为圆心、半径 8 的圆内，z ≥ 18，nz > 0.3，外顶面 | (0, 0, −5) |

**网格：** gmsh 4.15.2，MeshSizeMax = h，MeshSizeMin = max(0.35, 0.38h)，MeshSizeFromCurvature = 24，MeshSizeExtendFromBoundary = 1，Algorithm = 6，Algorithm3D = 1，ElementOrder = 2，SecondOrderLinear = 1，Optimize = 1；h = 2.4 / 2.0 / 1.6。

**参考实现：** `cad/l2_fem_author/fem_variants.py` 和 `fem_l2.py`（`l2-r4` 分支）。
