Quietmirror/Quietmirror-L2/specs/Quietmirror_L2_FINAL_Plan_2026-10-17.md

# Quietmirror R3.2 → L2｜最终方案（确定版，交给建模智能体）

**日期：** 2026-10-17（**r2 修订：2026-10-18**，并入 Quietmirror-L2 仓库 `67dc936d` 独立复核和扫描复核的 11 项修正，修订内容见 §9）
**地位：** 本文件是**唯一需要执行的文件**，内容自成一体。以下文件只作背景和追溯：
- 扫描复核 `Quietmirror_L2_Repo_Scan_Recheck_2026-10-18.md`（r2 修正的依据）
- 独立复核仓库 [Quietmirror/Quietmirror-L2 @ 67dc936d](https://github.com/Quietmirror/Quietmirror-L2/tree/67dc936d)（`handoff/SECOND_CHECK.md`、`PARAMETERS_CORRECTED.md`、`OPENINGS_RESOLUTION.md`）
- 参数文件 `Quietmirror_L2_Modeling_Parameters_FINAL_2026-10-17.md`
- 总任务书 `Quietmirror_L2_Agent_Handoff_2026-10-17.md`
- v2 任务书 `Quietmirror_R3_2_to_L2_Codex_Master_Spec_v2_FINAL_2026-10-17.md`
- 3D 报告 `Quietmirror_L2_3D_FEM_Report_2026-10-17.md`
- 复核报告 `Quietmirror_L2_Plan_Independent_Review_2026-10-17.md`

本文件与它们冲突时，以本文件为准。

**工作位置：全部在 D 盘。** 工程目录 `D:\Quietmirror_L2`；工具链和计算目录 `D:\Quietmirror_L2\_support`。任何操作前先执行 `. D:\Quietmirror_L2\_support\enter-env.ps1`；重型进程用 `_support\run_guarded.ps1` 运行。内存上限按本机物理内存设定：本机约 16 GB，上限取 ≤ 8 GB（原文写的 24 GB 超过了物理内存，作废）。

**体积与质量一律用自适应积分：** `BRepGProp.VolumeProperties_s(shape, props, 1e-8, True, False)`。cadquery 默认的 `Shape.Volume()` 会把 R3.2 BODY 算成 13,362.27 mm³，比正确值 12,801.73 多 560.5 mm³（+4.4%），**禁止使用**。

**唯一几何基准：** Quietmirror/github @ `f1b1090931d717117287ea2b79c2e14ddc234937`（R3.2）。在 R3.2 上修改，不得从零重建，不得覆盖 R3.2 文件。坐标沿用 R3.2 装配坐标：**+X 为右手拇指侧，低 Y 为前，Z 向上**，脚贴粘贴面 Z 5.2。注意：BODY 外缘有一圈朝下的平面在 **Z 5.0**，比脚贴粘贴面低 0.2 mm（处理方法见 §4.3 第 7 条）。

---

## 0. 最终决定一览

| 项目 | 最终决定 | 依据 |
|---|---|---|
| 顶面镂空 | **保持 R3.2 原六孔，不改** | 3D 三档网格已完成（§1.3）：P1 圆角在最细的 1.6 mm 网格下，8 个工况都只有同方法 P0 的 97.8–99.5%；P7 三角网格掌压刚度只有 83–84%，并且重约 0.12–0.17 g；小六边形开孔更少或刚度大降 |
| 壳体厚度 | **全部保持 1.8**（夹持带、侧壁、顶面） | 加筋蒙皮在指尖点载荷下只有 65–85%；窄筋带减薄加翻边反而更费料 |
| 骨架 | 删除 Y54 横梁（已悬空）；**保留** Y67.5 横梁、下横梁 Y40.8、两根前斜撑；两根后斜撑改为 1.6×2.8 竖放矩形 | 3D 与框架代理：Y67.5 是双侧夹持的传力件；矩形下横梁和前斜撑屈曲载荷下降过多 |
| 主键 | 减薄区蒙皮 1.6 + 2 根纵筋 0.9×1.6 + 1 对 X 形斜筋 0.9×1.6 | 弯曲刚度约 100%，扭转刚度 52.7% 由 X 筋补强 |
| 滚轮 | 轮辋 1.4、5 根辐条 1.2、轮毂 Ø5.0 | 15 N 下应力 6.2 MPa |
| 侧键 | Fenrir 式上侧壁细长杠杆键；**推杆在键面 Y 向中心：Y 偏心 0、Z 偏心 −0.9**（推杆 Z 16.6，键面中心 Z 17.5；满足 v2 ≤ 1.0） | 用户决定；r2 补标 Z 向 |
| 侧键微动 | 新的独立开关托架，取代 R3.2 的滑块、捕获销、夹条和 4 组 M2；托架必须是**单一连续实体**（r2：加连接桥） | 杠杆结构不会像滑块那样卡滞；复核发现原尺寸会断成 3 块 |
| R3.2 旧侧键座 | 删除；**回填**旧侧键 M2 工具通道（O1 / O2 / O4）和捕获销孔（PH1 / PH2）；**保留**滚轮钢销通道 O3 | 来源已查明（§2.1） |
| 侧键模块化 | 键帽 + 开关托架 + SIDE_IO_PCB 做成**可整体更换的侧键模块**（参考 Puppy V4 的模块化思路），提供 F1（齐平）和 F2（人体工学）两种键帽 | §3.4.1 |
| 传感器（H 方案） | **PAW3950**（用户确认） | §4.3 |
| 供体（D 方案） | **型号待用户确认（`DONOR_ID_PENDING_USER_CONFIRMATION`）。** 用户原写“ATK A1 Pro”，复核仓库记为“ATK A1 Plus”，公开渠道两者都查不到。ATK 烈空 F1 PRO 的公开数据只作风格和尺寸**参考**，不作为已采用的供体 | §4.3 |
| R3.2 顶面开口 | **来源已查明**（§2.1）：O1 / O2 / O4 是旧侧键 M2 工具通道，回填；O3 是滚轮钢销通道，保留；PH1 / PH2 是旧捕获销孔，回填 | §2.1 |
| 材料 | PA12（ρ 1.01）计重；FDM PLA 打印试装 | — |
| **PA12 塑料件质量** | **约 17.42 g（预算）**（R3.2 为 18.69 g，约减 1.27 g）；r2 计入了托架连接桥和 PCB 安装座（+65 mm³） | §3.3 质量账 |

L1（16.49 g）和 L2（14.89 g）：在 v2 的“刚度 ≥ R3.2 的 100%”门槛下，**已评估的候选都没有证明能达到**。这不等于证明了所有更轻的设计都不可能。若用户以后同意换材料（PA12S 同几何约 16.90 g）或放宽刚度门槛，再另行评估研究项（参数文件 §6）。

---

## 1. 测试思路和结果

### 1.1 思路
1. **算术复核：** R3.2 九件 18,506.6761 mm³ / 18.6917 g、预算、孔面积、梁体积等全部复现。
2. **2D 代理筛选：** 62×41 平板，CST 平面应力，4 种边界条件，比较 57 种镂空图案。
3. **3D 实体复核：** 在 R3.2 原始 BODY.step 上只改顶面，gmsh 4.15.2 + CalculiX 2.22，C3D10，2.4 / 2.0 / 1.6 mm 三档，8 个工况。先验证重建方法本身：P0d 应与 R32 一致。
4. **求解器验证：** 悬臂梁解析基准，误差 0.46–1.32%（验收线 < 5%）。

### 1.2 3D 工况（E 1500 MPa，ν 0.35；五个脚贴底面 Uz = 0，加 3 个面内刚体约束）

**选面定义（r2 补全；按网格表面三角形的中心坐标 x, y, z 和外法向 n 判断）：**

| 工况 | 选面条件 | 合力 N |
|---|---|---|
| palm_down_20N | 44 ≤ y ≤ 71，\|x\| ≤ 24，z ≥ 23，nz > 0.3，且 \|z − roof_z(x, y)\| < 0.35（只取外顶面） | (0, 0, −20) |
| left_main_root_down_5N | root_y − 3 ≤ y ≤ root_y + 4，6 ≤ x ≤ 24，z ≥ 11，nz > 0.2 | (0, 0, −5) |
| right_main_root_down_5N | 同上，−24 ≤ x ≤ −6 | (0, 0, −5) |
| side_i_switch_fence_inward_5N | \|x − (tip_x − 7.5)\| < 0.04，\|y − tip_y\| ≤ 7.25，tip_z − 2.9 ≤ z ≤ tip_z + 2.9，nx > 0.95 | (−5, 0, 0) |
| LC3_squeeze_2x2N | +X 侧：x > 20，45 ≤ y ≤ 70，8 ≤ z ≤ 14，nx > 0.5，且只取外侧面 → (−2, 0, 0)；−X 侧镜像 → (+2, 0, 0) | 自平衡，F = 4 |
| press_A / B_d16 | 以 (14, 60) / (−14, 72) 为圆心、半径 8 的圆内，z ≥ 18，nz > 0.3，外顶面 | (0, 0, −5) |

- **参数来源：** root_y 取 R3.2 `rebuild_r2/parameters.json` 的 `main.root_y`；tip 取 R3.2 `design_metadata.json` 的 `mechanisms.side_motions[i].plunger_tip`；roof_z 和“外侧面”用 R2 曲面公式（超椭圆 p 3.4，比例 1.08）。
- **外表面判据：** 到母面的距离 < 0.35 mm。
- **载荷分布：** 沿用 R3.2 `rebuild_r2/fem_check.py` 的 `selected_load()`。
- **约束：** 五个脚底面节点 Uz = 0；左前脚中心附近一个节点 Ux = Uy = 0；右前脚中心附近一个节点 Uy = 0。
- **刚度：** k = F / δ，δ = Σ(f·u) / F，夹持工况取 F = 4。
- **参考实现：** `D:\Quietmirror_L2\fem3d\fem_variants.py` 的 `cases()` 和 `outer_masks()`。用它重跑 R32 2.4 mm 网格，得到 105.64 / 24.95 / 24.28 / 34.47 / 29.37 / 496.43 / 62.21 / 56.21 N/mm。复核仓库用自己定的选面算出了不同的值，例如主键根部只取了 24 mm² 的小块，因此不可直接比较。

只加载外壳外表面。仓库原掌压工况会选到窗口里露出的悬空 Y54 横梁，导致位移 280 mm。

### 1.3 3D 结果（三档网格已完成；最细 1.6 mm 网格：R32 307,796 节点，P0d 296,405，P1d 295,246）

**1.6 mm 网格（P1 结论以此为准）：**

| 工况 | R32 k N/mm | P0d / R32 | P1d / R32 | **P1d / P0d** |
|---|---:|---:|---:|---:|
| palm_down_20N | 105.04 | 100.0% | 99.2% | **99.2%** |
| left_main_root_down_5N | 24.47 | 100.4% | 99.9% | **99.5%** |
| right_main_root_down_5N | 23.93 | 100.7% | 98.7% | **98.0%** |
| side_1 fence 5N | 32.81 | 104.2% | 103.3% | **99.1%** |
| side_2 fence 5N | 27.38 | 105.5% | 104.2% | **98.8%** |
| LC3_squeeze_2x2N | 497.99 | 100.6% | 98.3% | **97.8%** |
| press_A_d16 | 61.77 | 100.2% | 98.4% | **98.1%** |
| press_B_d16 | 55.31 | 99.7% | 98.0% | **98.3%** |

**P7 三角网格（2.0 mm 网格；1.6 mm 档未完成，前两档已明确不达标，不影响结论）：**

| 工况 | P7d / R32（2.4 / 2.0 mm） | P7d / P0d（2.0 mm） |
|---|---:|---:|
| **palm_down_20N** | **84.3% / 83.0%** | **82.9%** |
| left / right_main_root | 103.9% / 101.7%；105.7% / 102.9% | 100.6% / 102.0% |
| side_1 / side_2 fence | 99.8% / 100.4%；99.5% / 100.3% | 97.9% / 97.3% |
| LC3_squeeze | 105.3% / 104.3% | 105.5% |
| press_A_d16 | 118.0% / 112.5% | 112.4% |
| press_B_d16 | 364% / 380%（垫块正好落在 Ø16 压头下，不能直接比较） | — |

**P95 von Mises（MPa，2.0 mm 网格，R32 / P0d / P1d / P7d）：** palm 1.418 / 1.427 / 1.427 / **1.533**；其他工况 P1d 与 R32 相差都在 ±0.01 以内。

**网格体积（≈ BODY 质量；这是网格积分值，不受 cadquery 默认体积误差影响）：** R32 12,755.0、P0d 12,755.3、P1d 12,754.8（1.6 mm 网格）；P7d 12,857.2 对 R32 12,737.5（2.0 mm 网格），P7 **多约 120 mm³（约 0.12 g）**。

### 1.4 结论
- **重建方法有效：** P0d 与 R32 在掌压、主键、夹持、指压工况下相差 ≤ 2%（三档网格）。侧键后挡墙工况在不同网格下相差 2.5–5.5%，属于该局部工况对网格敏感，不影响顶面结论。
- **P1 圆角：不采用。** 1.6 mm 网格下 8 个工况都只有 P0d 的 97.8–99.5%，没有达到 100% 门槛，也没有体现出 2D 预测的 0–18% 提升。
- **P7 三角网格：不采用。** 掌压刚度只有 83–84%，P95 应力更高，而且重约 0.12 g。
- **小六边形：不采用**（2D 结论：要么开孔比六孔少约 30%，要么刚度只剩 19–66%；没有做 3D，按 P7 的经验只会更差）。
- **最终：顶面保持 R3.2 原六孔。** 所有求解的力和力矩平衡都满足；求解器经悬臂梁基准验证。

---

## 2. 建模智能体必须先做二次核对

用**自己写的独立脚本**核对，不得复用本文作者的脚本函数。结果写入 `D:\Quietmirror_L2\handoff\SECOND_CHECK.md`，逐项写“本文值 / 复核值 / 偏差 / 结论”。

**已有的第一轮复核（Quietmirror-L2 仓库 `67dc936d`）：**
- K1、K2、K4、K6、K7 已通过；
- K3 不能比较，原因是 r1 没有公开选面，r2 已在 §1.2 补全；
- K8 的问题是定义不清，K9 不通过，r2 已在 §3.4 修正；
- K5 要求排查得更完整。

执行智能体本轮**重点复核 r2 改过的项**（K3、K5、K6、K8、K9、K10），其余项可引用第一轮结果，但须注明出处。

| # | 核对项 | 本文值 | 容差 |
|---|---|---|---|
| K1 | R3.2 九件体积合计（自适应积分） | 18,506.678 mm³（BODY 12,801.730） | ±0.5 |
| K2 | 同一工具链的悬臂梁解析基准 | 误差 < 1.5% | < 5% |
| K3 | R32 基线 8 个工况的刚度，**按 §1.2 选面** | 2.4 mm 网格：§1.2 的 8 个值；1.6 mm 网格：§1.3 | ±3% |
| K4 | Y54 横梁在 x ≈ ±11.3–13.7 被切断，只靠中心枢纽连接 | 第一轮已确认 | 射线或 BRep 确认 |
| K5 | 去掉顶面蒙皮后的全部内部连通组 | 第一轮找到 12 组：Y67.5 横梁（顶面接触 x = ±22.07）、中心枢纽（X ±6、Y 47–55）、4 个主键固定铰座、后部传感器安装区等 | 每组写明“保留 / 删除 / 加强”；删除 Y54 横梁时不得连带删除滚轮中心支撑 |
| K6 | 开口来源 | §2.1 表（O1 25.96 / O2 16.70 / O4 2.14 mm³；O3 滚轮钢销通道；PH1 (26.99173, 50)、PH2 (27.70980, 65)） | ±0.3 mm |
| K7 | 侧壁外表面 X（§3.4 表） | 例：Y50.8 / Z16.6 → 31.44；第一轮最大偏差 0.0199 | ±0.05 |
| K8 | 侧键杠杆参数 | §3.4（r2） | ±0.02 |
| K9 | 托架连续性和各间隙 | §4.3 第 5 条（r2 目标值） | 用 BRep 重算；托架必须为 1 个实体 |
| K10 | 质量账 | 17.42 g（预算） | 用 CAD 实测替换 |

**判定：** 全部通过 → 进入 §3；任何一项不通过 → 先在 `PARAMETERS_CORRECTED.md` 写明原因和修正值，再建模。

### 2.1 R3.2 顶面和侧壁开口：来源已查明（r2）

第一轮复核（L2 仓库 `handoff/OPENINGS_RESOLUTION.md`）找到了每个开口的生成语句，扫描复核也独立确认了 PH1、PH2 和 O3 的坐标：

| 编号 | 位置（装配坐标） | 六孔之外的附加切除 mm³ | 来源 | 处理 |
|---|---|---:|---|---|
| O1 | X 16.8–21.1、Y 46.7–50.9、Z 24.7–28.4 | 25.96 | 前侧键微动 M2 的**螺丝刀工具通道**：`mechanics.py` 侧键 M2 调用 → `fasteners.py:m2_set`（r 2.15，长 38） → R3.2 `rebuild_body` 切除 | 从源码中取消该切除，恢复母壳，**保持六孔边界不变** |
| O2 | X 17.5–21.8、Y 63.1–65.9、Z 25.6–29.2 | 16.70 | 后侧键微动 M2 工具通道（同上） | 同上 |
| O4 | X 18.8–21.4、Y 68.0–69.0、Z 23.8–27.3 | 2.14 | 后侧键第二颗 M2 工具通道 | 同上 |
| O3 | 外侧轮廓 X −31.03…−30.00、Y 48.83…51.18、Z 17.83…20.18 | — | **滚轮载架钢销的贯穿 / 装入通道**：轴线 Y 50 / Z 19，Ø2.35（`wheel_mechanism.py` 中的 `cylinder(1.175, 82, (−41, py, wz), (1,0,0))`，`mechanics.py` 的 `pin_paths` 防止新骨架堵住它）；钢销 Ø2.0 × 13.8，中心 (0, 50, 19) | **保留**，不得回填；L2 新增结构不得堵住钢销的装入路径 |
| PH1 | Ø1.72 竖孔，中心 **(26.99173, 50.0)** | — | 旧前侧键捕获销（`mechanics.py` 的 `cylinder(.86, 30, …)`）；销 Ø1.5 × 5.6，中心 Z 15.0 | 删除旧销孔，恢复母壳；新的杠杆铰链孔另行生成（§3.2 第 7 条） |
| PH2 | Ø1.72 竖孔，中心 **(27.70980, 65.0)** | — | 旧后侧键捕获销 | 同上 |

**注意：**
- O1、O2、O4 与六孔有部分重叠。回填时只补“六孔之外”的部分，不能把整根工具圆柱与母壳的交集都补上，否则会把六孔缩小。
- 应在**源码层面**取消这些切除（R3.2 `rebuild_body` 流程），不要在成品 BODY 上补片。

**执行智能体必须：**
1. 在重建后的 BODY 上复查：实体数为 1、体积变化合理、六孔边界与 R3.2 一致、O3 通道贯通、gmsh 体网格通过（不得出现重合面或零厚度面）。
2. 把开口处理前后的体积变化计入 §3.3 质量账（本文暂估 +45 mm³）。
3. 结果写入 `OPENINGS_RESOLUTION.md`，内容包括：编号、源码出处、处理方式、体积变化、网格是否通过。

---

## 3. 核对通过后：建模参数与建模

### 3.1 建模规则（来自 3D 复核的教训，必须遵守）
1. 从 R2 源面重新生成 BODY（沿用 R3.2 的 `rebuild_body()` 流程）。不要在已裁剪的 BSpline BODY 上做大布尔；每次布尔后都检查体积是否合理。
2. 新增或回填的边、面与 R3.2 原有的边、面至少相距 0.3 mm，或者完全重合；不得近乎重合，否则会出现零厚度面并导致网格失败。
3. 回填旧开口时，用母面蒙皮补片按开口轮廓外扩 0.3 mm 后再融合。
4. 新增内部实体（R5 圈、铰座、托架安装面）在开孔之后融合。
5. 每个零件导出后重新导入，检查为单一有效实体；每个变更都用 gmsh 试生成网格。
6. 所有体积和质量都用自适应积分计算（eps 1e-8，见文首），不得使用 cadquery 默认的 `Volume()`。

### 3.2 BODY 修改清单

| # | 修改 | 参数 |
|---|---|---|
| 1 | 顶面六孔 | **不变**（R3.2 原状） |
| 2 | 骨架 | 删除 Y54 横梁（−227 mm³）；两根后斜撑（脚 (±24.84, 62.64) → (0, 46, 6.5)）改为竖放矩形 1.6×2.8（−49.5 mm³）；其余横梁和斜撑不变 |
| 3 | 删除 R3.2 侧键导向座 | `mechanics.py` 第 221–287 行生成的 frame、bridge、flange、shoulders、rails、fence 及其 M2 孔和捕获销槽，以及 R3.2 `build.py` 中对应的 relief / supports 处理；约 −970 mm³（与壳体重叠的部分不删）。**删除后必须复查以下 BODY 材料是否已经消失**（扫描复核中，它们与新托架或 PCB 重叠）：① X 15.61–17.01、Y 45.8–58.2、Z 9.65–14.0 的竖墙（旧微动后挡墙）；② 后腿位置 (28.604, 66.8) 处 Z 11.3–12.975 的那层材料；③ X 26.5–30.04、Y 53.8–60.0、Z 13.7–16.4 的材料（与新止挡柱重叠）；④ X 17.5–17.73、Y 60.8–71.2、Z 12.1–14.0 的材料（与新后挡墙重叠）。哪一项不属于旧座、删不掉，就移动托架或 PCB，**不得在 BODY 上硬切** |
| 4 | 回填旧开口 | R3.2 旧侧键开口位于夹持带 Z 12.4–15.2 的部分（Y 44.3–54.3 / 57.3–67.3）回填为 1.8 mm 蒙皮；O1 / O2 / O4 和 PH1 / PH2 按 **§2.1** 回填；**O3 保留**（暂估 +45 mm³） |
| 5 | 新侧键开口 | SF：Y 43.9–56.6、Z 15.2–19.8；SR：Y 57.8–71.1、Z 15.2–19.8（间隙 0.30，FDM 版 0.35）；向内切 3.5 mm |
| 6 | R5 加强圈 | 上圈 1.2（Z 向高）× 1.6（向内凸）；两开口之间的隔墙兼作共用端圈（1.2 × 1.6）；SR 后端圈 1.0 × 1.6；SF 前端不设端圈；开口下沿不设内凸圈。**在开关正上方，上圈内表面不得越过 X 25.7（SF）/ 26.2（SR）** |
| 7 | 侧键铰座（H-B，PLA 默认） | Ø1.0 × 5.5 钢销竖向穿过键帽铰节（孔 Ø1.05，滑配），两端压入 R5 上圈和开口下沿凸耳的 Ø0.95 孔，孔周壁厚 ≥ 0.8；钢销从底部开口沿 +Z 装入 |
| 8 | +X 侧 keep 遮罩 | 修改的是**构造坐标 side < 0** 的 `box(14, 28, 10) @(−29s, 53.5s, 14.75s)`，改为在装配坐标中覆盖 X 24–38、Y 40–73、Z 10.9–21.0；另一个遮罩不动 |
| 9 | 夹持带 Z 5.2–14.5 | 保持 1.8，连续，不开孔 |

### 3.3 质量账（PA12，基准 18,506.678 mm³，自适应积分）

| 项 | mm³ |
|---|---:|
| 顶面 | 0 |
| 删除 Y54 横梁；后斜撑改截面 | −227 / −49.5 |
| 删除旧侧键导向座 | −970 |
| 删除两枚夹条 | −385.8 |
| 新开关托架 | +640 |
| R5 加强圈 | +77 |
| 旧开口回填和新开口切除（夹持带部分） | −48 |
| 回填 +X 顶面两个旧座开口和两个销孔（待 K6 确认） | +45 |
| 主键 ×2 | −136 |
| 滚轮 | −261 |
| 新键帽（比 R3.2 侧键小） | −109 |
| 推杆凸台 Ø2.5 × 2 | +45 |
| 补强和圆角 | +60 |
| **r2：** 托架连接桥（前、后腿各一，止挡柱底板外延 ×2）+ PCB 安装座 | +65（估算，待 CAD 实测） |
| **合计** | **−1,255 → 约 17.42 g**（PA12S 约 16.90 g）；r1 的 −1,320 / 17.36 g 作废 |

这是预算值。最终以 CAD 自适应积分逐件实测为准，偏差如实报告。

### 3.4 侧键（Fenrir 式布局，+X 侧）

**侧壁外表面 X（R2 曲面公式）：**

| Y | @Z15.5 | @Z16.6 | @Z17.5 | @Z19.5 |
|---:|---:|---:|---:|---:|
| 41.8 | 30.53 | 30.23 | 29.92 | 28.98 |
| 46.0 | 30.98 | 30.73 | 30.46 | 29.66 |
| 50.8 | 31.67 | 31.44 | 31.21 | 30.51 |
| 56.3 | 32.34 | 32.14 | 31.93 | 31.30 |
| 58.1 | 32.44 | 32.24 | 32.04 | 31.43 |
| 62.0 | 32.55 | 32.34 | 32.13 | 31.50 |
| 66.0 | 32.05 | 31.82 | 31.58 | 30.87 |
| 70.8 | 30.94 | 30.62 | 30.30 | 29.28 |

**键帽：**

| 参数 | 前侧键 SF | 后侧键 SR |
|---|---:|---:|
| 键面 Y / 长 | 44.2–56.3 / 12.1 | 58.1–70.8 / 12.7 |
| 键面 Z | 15.5–19.5 | 15.5–19.5 |
| 外表面 | 母壳法向外偏 +0.20；缝端定位脊 +0.15；总突出 ≤ 0.35 | 同左 |
| 壳厚 / 轮廓 | 1.2；圆角 R1.5；外缘 R0.3 | 同左 |
| 铰点 | Y 45.0 | Y 70.0 |
| 推杆 Ø2.5（键面 Y 中心） | (Y 50.25, Z 16.6)，长约 4.68（r2：开关向 −X 移 0.20 后 +0.20；按实际键帽内表面到按钮尖、留 0.05 间隙重算） | (Y 64.45, Z 16.6)，长约 4.98（同左） |
| 偏心 | **Y 0 / Z −0.9**（推杆 Z 16.6，键面中心 Z 17.5）；须检查 Z 偏心对铰链产生的弯矩和扭矩 | 同左 |
| 力臂 / 转角 / 缝端行程 | 5.25 / 6.562° / 1.291 | 5.55 / 6.206° / 1.286 |
| 凸台处行程 | 0.60（含名义间隙 0.05，即名义压下 0.55）；修配垫片档 0.05 / 0.10 / 0.15 | 同左 |
| 按压力比（推杆处为 1.00×）：**距铰点 L/4** / 键面中点 / 远端缝 | 1.736× / 1.00× / 0.465× | 1.748× / 1.00× / 0.466× |
| （对照：若从靠铰链一端的键帽边缘量 L/4） | 2.360× | 2.337× |

力比的定义：按压点到铰点的距离为 d，力比 = 力臂 / d，即同样的开关反力下，该点所需按压力是推杆处的多少倍。本文固定采用“**距铰点 L/4**”，L 为键面长度。

**铰轴位置必须参数化：** 铰轴 X / Z（钢销中心）、推杆 X 在 CAD 里必须作为参数。名义止挡角和微动触发角都按刚体旋转求压下量，分别报告（§6 S3），不能只用纯 Y 向力臂近似。
| 止挡 | 止挡筋高 0.6，Y 54.2–55.4；止挡面 X 29.74 | 止挡筋 Y 58.5–59.7；止挡面 X 30.04 |

**微动（D2F 级包络 12.8×5.8×6.5，按钮朝 +X，开关前端面为固定平面）：**

| 参数 | SF | SR |
|---|---:|---:|
| 按钮尖 | **(25.62, 50.25, 16.6)** | **(26.12, 64.45, 16.6)** |
| 本体 X / Y / Z | **18.5–25.0** / 41.85–54.65 / 13.7–19.5 | **19.0–25.5** / 56.05–68.85 / 13.7–19.5 |
| 端子 X | **14.8–18.5**（穿过 SIDE_IO_PCB 焊接，属于有意接触） | **15.3–19.0**（同左） |

r2：两颗开关都向 −X 移 0.20，使开关到止挡柱、开关到主键铰座立耳的间隙都达到 0.5；后挡墙随之移动，见下。

**开关托架（独立打印件，必须是 1 个连续实体）：**

r1 的尺寸按字面建模会断成 3 块：SR 止挡柱与底板相隔 0.5 mm，后腿相隔 1.104 mm，前腿只靠一条 0.169 mm 宽的边缘接触。r2 改为：

- **底板：** X **17.3**–25.5、Y 41.0–71.2、Z 12.1–13.7；每个开关下方开 4×8 减重窗（窗边距连接桥 ≥ 1.0）；Y < 41.6 且 X > 25.2 的部分开缺口，避让主键铰座圆柱。
- **后挡墙：** X **17.3–18.5**、Z 12.1–19.5（随开关移 −0.20）；每个开关开 3 个 1.6×1.2 端子槽。
- **隔板：** 0.8 mm，位于 Y 54.95–55.75。
- **止挡柱：** SF 柱 X 25.5–29.74、Y 53.8–55.6；SR 柱 X 26.0–30.04、Y 58.0–60.0；均为 Z 13.7–16.4。
  - **r2 新增底板外延：** 两根柱的下方各把底板局部外延到 X 26.8（Y 与柱同宽，Z 12.1–13.7）；柱底嵌入外延块 0.3（柱的 Z 从 13.4 起），保证正体积搭接。
  - 外延块离开关本体 ≥ 0.5。
- **腿：** 坐在 R3.2 +X 侧 PCB 耳上，与 H 转接件叠装共用（M2 加长 1.6）。r2：**两个耳的顶面高度不同**，腿的 Z 起点分别计算：

  | | 中心 | 耳顶面 Z（BRep 实测） | 腿 Z 范围 | 削平 |
  |---|---|---:|---|---|
  | 前腿 | Ø4.0 @(27.331, 43.0) | 10.80 | (10.80 + t_H) 到 12.1 | X ≤ 29.0 |
  | 后腿 | Ø4.0 @(28.604, 66.8) | 10.525 | (10.525 + t_H) 到 12.1 | X ≤ 30.1 |

  t_H 是该位置叠装的 H 转接件厚度，不叠装时为 0。r1 的“Z 10.75”作废：它使前腿嵌入耳 0.05、后腿悬空 0.225。
- **连接桥（r2 新增，每个腿一条）：**
  - 截面：宽（Y 向）≥ 4.0，厚 ≥ 1.6，与底板同层（Z 12.1–13.7）；
  - 范围：从底板内部 X ≤ 24.5 起（与底板搭接 ≥ 1.0），延伸到腿的外缘，并向下包住腿顶，搭接为正体积；
  - 前桥避让 Y < 41.6 的主键铰座，间隙 ≥ 0.5；
  - 桥和腿到侧壁内表面 ≥ 0.5；
  - 装入时从底部进入，须验证不撞后脚斜撑（后腿 ↔ 斜撑现有 0.59）。
  - 后腿位置 Z 11.3–12.975 处的 BODY 材料要在删除旧座后复查（§3.2 第 3 条）。如果它不属于旧座，就把后腿沿 Y 移到 ≥ 0.5 间隙处，并相应修改 PCB 耳安装孔。
- **体积：** 约 640 mm³，加上 r2 的连接桥、外延和安装座约 +65 mm³（计入 §3.3）。

**SIDE_IO_PCB：** X 15.2–16.2、Y 44–70、**Z 13.3–18.8**（r2：整体上移 0.3，板高不变）。
- 与传感器安装耳的间隙：耳顶面 Z 12.8，所以间隙 0.5。r1 的 Z 13.0 只有 0.200，作废。
- **安装座（r2 新增）：** 从后挡墙的 −X 面（X 17.3）伸到 PCB 背面（X 16.2），截面 ≥ 2.0（Y）× 1.6（Z），共 2–3 处。优先放在隔板延长线（Y 54.95–55.75）和 PCB 两端，离端子孔 ≥ 0.5。PCB 用热熔柱或 M1.4 自攻固定，不得悬空。
- PCB 与 R3.2 X 15.61–17.01 那面竖墙（旧微动后挡墙）原来重叠 7.3 mm³，删除旧座后必须复查。
- 上移后要复查与端子、电池和 H 转接件的间隙。

**托架和 PCB 最终仍是估计包络。** 拿到实际 PCB 和微动后，以实测尺寸替换。

**风格依据（2026-10-17 调研）：**
- **G-Wolves Fenrir Pro 8K：** 81.7×60.2×28.3 mm，18.9 g，对称外形，PAW3950，欧姆龙微动。公开资料没有侧键尺寸。评测指出，壳体矮使侧键位置偏低，**手指粗的用户容易误触**（MouseLog 用户评论）。因此 L2 只借用它“细长、低突出、双键窄缝”的外观语言，并**有意把键带抬到侧壁上部**（Z 15.5–19.5，下方保留 9.3 mm 连续夹持带），以减少误触。
- **Puppy V4（plastocene，B 站“模块化指握套件”）：** 公开信息只说明它是**模块化指握套件**，侧键结构不公开；同作者的 Puppy v3Air 是 18 g 开源套件，标签显示用雷柏鼠标作供体板。L2 借用的是“**可更换模块**”的处理思路（§3.4.1），没有复制它的几何。
- 尺寸都由 R3.2 壳体和内部空间推算，没有实测上述任何一款。

### 3.4.1 侧键模块化（参考 Puppy V4 的模块化思路）

把**键帽 + 开关托架 + SIDE_IO_PCB + 两颗微动**做成一个可以整体拆装的“侧键模块”：
- **接口（固定，不随模块变化）：** BODY 上的侧键开口、R5 圈、铰座孔（H-B 钢销）和 +X 侧两个 PCB 耳（托架腿安装面）。
- **模块 F1 齐平（默认）：** §3.4 的全部参数。
- **模块 F2 人体工学：** 外偏 +0.30、定位脊 +0.15（总突出 0.45，**超出 v2 的 0.35 上限，只作试握对比件，标注为试验件**）；键面下沿倒 R0.8，方便拇指上推。其余参数与 F1 相同。
- **要求：**
  - 更换模块只需拆托架的 2 颗 M2 和 2 根钢销，不动 BODY 和其他元件（SIDE_IO_PCB 随托架一起拆下）；
  - 两种模块都要做 §4.3 的穿模和运动检查；
  - 打印文件中 F1 为默认件，F2 另出一个附加 3MF。

### 3.5 主键和滚轮
- **主键（左右各一）：** 指尖区 Y ≤ 12、触发点周围 Ø8、铰链区 Y ≥ 36 保持 2.0。其余顶板改为 1.6 蒙皮 + 2 根纵筋 0.9×1.6（距中线 ±5.0）+ 1 对 X 形斜筋 0.9×1.6，筋根 R0.4。前端羽状薄边补到 ≥ 0.8。
- **滚轮：** 外径 12.5、宽 6.5、六角 1.67 AF 不变；轮辋径向 1.4，5 根辐条宽 1.2，轮毂 Ø5.0。

---

## 4. 两个模型文件（及建模时的检查）

### 4.1 文件 A：分件单板打印文件
- **打印机：** Dremel 3D45（255×155 mm，切片目标床尺寸，属于配置假设，未在实机上核对），PLA，0.4 mm 喷嘴，PrusaSlicer 2.9.6，**真实切片**，不得缩放。
- **H 方案：** `HALF_ASSEMBLED_PAW3950_ALL_PARTS_SINGLE_PLATE.3mf`，零件为 BODY、LEFT_KEY、RIGHT_KEY、SIDE_FRONT_KEY、SIDE_REAR_KEY、SIDE_SWITCH_CARRIER、WHEEL、WHEEL_CARRIER 和 H 转接件。
- **D 方案：** `ATK_DONOR_PENDING_ALL_PARTS_SINGLE_PLATE.3mf`（占位；供体型号待用户确认后再改名）。
- **侧键 F2 试验模块：** `SIDE_MODULE_F2_TRIAL.3mf`（附加件）。
- **其他要求：** 零件间距 ≥ 5 mm；写明每个零件的打印方向和支撑区域；附切片报告（零件 / 支撑 / 裙边质量和时长）；附逐件 STL / STEP。

### 4.2 文件 B：整体装配文件
- `FULL_ASSEMBLY_H.step` + `.FCStd`、`FULL_ASSEMBLY_D.step` + `.FCStd`，可选 `.glb`。
- 每个零件、微动、钢销、螺钉、PCB、传感器、镜头、电池都是独立组件，不得融合。

### 4.3 建模时的检查（结果写入 `INTERFERENCE_REPORT.md`，微调过程写入 `TUNING_LOG.md`）
1. **静态穿模：** 全部组件两两布尔求交；除列表说明的有意接触外，交叠体积 ≤ 0.001 mm³。最小间隙：活动件 ≥ 0.20（FDM 版 ≥ 0.30）；固定件与电子包络 ≥ 0.5。
   - **功能配合单独列出**，不套用上面的间隙：例如铰链钢销 Ø1.0 配孔 Ø1.05（径向 0.025）、压入孔 Ø0.95。要写明打印或铰孔工艺并验证。
   - 有意接触包括：微动端子穿过 SIDE_IO_PCB、托架腿和 PCB 耳的叠装面、钢销压入孔。
   - 先删除 R3.2 旧侧键座和旧侧键全部硬件（旧微动、夹条、M2、捕获销），再做检查。扫描复核里，这些旧件与新托架和新微动的重叠高达 190 mm³ 一项。
2. **障碍物：** 主键内外固定铰座（外侧圆柱 r 2.85 绕 (Y 38.5, Z 14.32)，X 25.5–27.9；立耳 Y 38.75–43.25）、主键铰销及其插入路径、Y67.5 横梁、中心枢纽、脚贴斜撑（半径 1.7，后斜撑起点 Z 7.4）、PCB 耳、中键座、滚轮载架（全行程）、USB 量规、传感器预留盒、光路。
3. **运动扫掠：** 主键 0–2.8°、滚轮载架 0–4.1°、侧键从 0 到名义止挡（SF 6.56°、SR 6.21°，对应凸台处 0.60 mm），各 ≥ 21 个位置。
   - 按实际铰轴 X / Z 和推杆 X 做刚体旋转；
   - 另外报告微动的触发角，用实际微动的 FP / OP / TTP；
   - 扫掠范围加 0.3° 余量，覆盖垫片和公差；
   - r1 写的“7.1° / 6.7°”与 0.60 mm 行程不一致，作废。
4. **不兼容：** 装配顺序可行（微动压入托架 → 托架从底部装入并用 M2 固定 → 键帽从外侧装入、钢销从底部装入 → 其余按 R3.2 原顺序）；不允许“先偏移再复位”；螺钉长度和叠装厚度正确。
5. **临界项**（必须用 BRep 复核）：

| 对象对 | r1 实测（L2 仓库 / 扫描复核） | r2 目标 |
|---|---:|---:|
| 托架实体数 | 3 | **1** |
| SR 止挡柱 ↔ 底板 | 分离 0.500 | 正体积搭接 |
| 后腿 ↔ 底板 | 分离 1.104 | 正体积搭接，承力厚度 ≥ 1.6 |
| 前腿 ↔ 底板 | 0.169 宽的边缘接触 | 正体积搭接，承力厚度 ≥ 1.6 |
| 前腿 ↔ 前 PCB 耳 | 嵌入 0.05 | 贴合（或经由 H 转接件） |
| 后腿 ↔ 后 PCB 耳 | 悬空 0.225 | 贴合（或经由 H 转接件） |
| SF 开关 ↔ 主键外侧铰座立耳 | 0.300 | ≥ 0.5 |
| 止挡柱 ↔ 开关（SF、SR） | 0.300 | ≥ 0.5 |
| 托架后腿 ↔ 后脚斜撑 | 0.591 | ≥ 0.5 |
| SIDE_IO_PCB ↔ 传感器安装耳 | 0.200 | ≥ 0.5 |
| SIDE_IO_PCB ↔ 后挡墙 | 1.300，没有支撑 | 用安装座连接 |
| 新托架 / PCB ↔ R3.2 BODY | 重叠 46.3 mm³（旧座区域） | 删除旧座后为 0 |

6. **两种元件组合都必须放得下：**

| 方案 | 元件（初始包络，来自 `electronics.json`；实测后替换） | 要求 |
|---|---|---|
| **H：半组装 PAW3950** | 传感器板 18×18×1.2 @(4, 66, 14.8)；PAW3950 封装 8×8×2.4 @(0, 66, 13)；镜头 12×14×4 @(0, 66, 9.8)；RF/MCU 板 18×18×1.2 @(4, 64, 18.5)；电池 18×22×6 @(−17, 57, 16.4)，服务包络 19×23×7；天线 8×4×0.8 @(0, 61.5, 25)，禁区 12×8×5；光路 7×10×12 @(0, 66, 1.8)；SIDE_IO_PCB（§3.4）；USB 转接板 20×10×1，孔 (±7.8, 13)；编码器板 ≤ 12.2×15.1×1.2 | 无穿模；间隙 ≥ 0.5；电池服务包络不被侵入；镜头到垫面距离按数据手册核对（现有 3.1 mm 只是估计） |
| **D：ATK 供体（型号待用户确认）** | **型号未确认，以下是参考机型 ATK 烈空 F1 PRO 的公开资料，只用来估计风格和量级，不作为装配尺寸**：PAW3950 + Nordic nRF52840；主键为欧姆龙**光微动**（焊接，不是 D2F 机械微动）；侧键和中键为环诺白点微动；滚轮编码器 F-Switch；250 mAh 电池（F1 PRO MAX 为 500 mAh）；主板与电池前后布置；底部有 DPI 键和指示灯；回报率最高 8K；LOD 可设 0.7 / 1 / 2 mm；原机 118.2×62.4×38.8 mm，约 45 g（PRO MAX 52.6 g 实测）。**未知：主板外形、孔位、微动坐标、传感器中心、元件高度**，只能用参数化占位板（初值可用 R3 历史的 36×50×1.2 诊断板） | ① 标注 `DONOR_ID_PENDING_USER_CONFIRMATION / PCB_GEOMETRY_UNVERIFIED / FIT_NOT_CERTIFIED`；② 给出占位板在壳内可放下的**最大外形和孔位范围**；③ 供体主板上的微动位置是固定的：若与 L2 主键触发点（±18.3, 24.30）或侧键推杆位置对不上，必须报告并列出改造代价（例如转接推杆、改键帽、外壳分叉），**不得切割供体 PCB、不得拆除电池保护**；④ 原机比 L2 长约 30 mm，主板与电池前后布置很可能放不进 88 mm 壳体，要单独评估 |

7. **底面基准与脚贴（r2 新增）：**
   - BODY 外缘有一圈朝下的平面，在 Z 5.0（428.5 mm²，沿整个外轮廓），比 5 个脚贴粘贴面（Z 5.2）低 0.2 mm。贴上脚贴后，外缘离桌面的距离 = 脚贴厚度 − 0.2。
   - 默认方案：**脚贴厚 0.8 mm，外缘离地 0.6 mm**（要求 ≥ 0.5）。
   - 备选：把外缘抬到 Z ≥ 5.2，此时须重做夹持带和 S8 刚度。
   - 执行智能体写明采用哪种方案；S5 的光学高度按实际脚贴厚度计算。

**H 方案传感器：PAW3950**（用户确认）。PixArt 数据手册不公开，公开资料只有 LOD 档位 0.7 / 1 / 2 mm。**镜头基准面到垫面的距离（现估 3.1 mm）必须用实际镜头图纸或实测确定。** 传感器托设计为可通过垫片调节 ±0.5 mm 高度，执行智能体在 S5 中给出最终值。

**D 方案供体说明（`DONOR_ID_PENDING_USER_CONFIRMATION`）：**
- 用户原写“ATK A1 Pro”，L2 复核仓库记为“ATK A1 Plus”，公开渠道两者都查不到。
- ATK 的 PAW3950 机型有烈空 F1 PRO / PRO MAX、烈空 X1 系列、蜻蜓 A9 PRO MAX；本文只把其中最轻的烈空 F1 PRO 作为**参考**。
- **供体未确认，执行智能体不得自行把型号定为 F1 PRO 或其他机型。** D 方案的全部结果都只能标注为占位检查（`PCB_GEOMETRY_UNVERIFIED / FIT_NOT_CERTIFIED`）。
- 交付时须**请用户确认实际供体型号**，拿到实物后再测绘主板。

---

## 5. 根据整体文件创建多视图（H、D 各一套，全部从 §4.2 的装配文件渲染）

- **六面正交视图：** 前、后、上、下、左、右。
- **四个斜轴测视图：** 左前、右前、左后、右后。
- **去顶壳内部图：** 标出每个元件的名称和中心坐标，按类别着色，附图例。
- **剖面：**
  - 侧键：Z 16.6 水平剖面；Y 50.25 / 64.45 竖直剖面；
  - 主键铰轴与触点；
  - 滚轮载架；
  - 传感器到垫面的光路；
  - 电池取出路径；
  - Y67.5 横梁与中心枢纽的连接。
- **爆炸图：** 按装配顺序编号，附 BOM。
- **对比图：** R3.2 与 L2 的顶 / 左 / 右 / 底视图；R3.2 滑块侧键与 L2 杠杆侧键。
- **间隙图：** §4.3 全部对象对的最小间隙。
- **打印平台布局图：** §4.1 的每个 3MF。

输出目录：`D:\Quietmirror_L2\views\l2_r1\`。

---

## 6. 要求智能体给出内部元件模拟结果（写入 `INTERNAL_COMPONENTS_SIMULATION.md`，附数据）

| # | 模拟项 | 需要输出 |
|---|---|---|
| S1 | 静态装配干涉（H、D） | 交叠体积表、最小间隙表 |
| S2 | 运动干涉（主键、滚轮载架、侧键全行程） | 每个位置的最小间隙曲线；最危险位置截图 |
| S3 | 微动触发 | 按实际铰轴做刚体旋转，分别报告**触发角**和**名义止挡角**（设计值 6.56° / 6.21°，凸台处 0.60，名义压下 0.55）。用实际微动的 FP / OP / TTP 和公差校核；D2F 规格（PT ≤ 0.5、OT ≥ 0.25）只作对照，不能当作每颗实物的保证值。给出垫片档建议 |
| S4 | 侧键按压分布 | 距铰点 L/4 / 键面中点 / 远端缝的力比和行程（设计值 SF 1.736× / 1.00× / 0.465×，SR 1.748× / 1.00× / 0.466×；缝端 1.29 mm）；Z 偏心 −0.9 产生的铰链弯矩和扭矩 |
| S5 | 传感器光学高度 | 镜头基准面到垫面距离（按实际脚贴厚度，默认 0.8 mm，见 §4.3 第 7 条），与数据手册对比，给出调整量；没有实际镜头图纸或实测数据时标注 `UNVERIFIED` |
| S6 | 电池与线束 | 装拆可行性、插头可达性、最小线束通道 |
| S7 | 安装件受力（3D FEM） | 托架在侧键 5 N 下、PCB 耳在叠装预紧下的位移和 P95 应力，附网格收敛 |
| S8 | 整壳刚度（3D FEM） | 最终 L2 BODY 与 R3.2 在 §1.2 全部工况下的刚度比，**严格按 §1.2 的选面定义**；**≥ 100% 才算通过**（流程沿用 `fem3d\fem_variants.py`，只加载外表面）；2.4 / 2.0 / 1.6 mm 三档网格收敛 |
| S9 | 质量 | 每个零件的 CAD 体积（自适应积分）× 密度、PLA 切片质量，与 §3.3 对比 |

3D FEM 不可用时标注 `3D_FEM_BLOCKED`，不得编造数值。D 方案的结果只能标注为“占位检查”。

---

## 7. 交付清单与最终核算

| 类别 | 文件 |
|---|---|
| 核对 | `handoff\SECOND_CHECK.md`、`PARAMETERS_CORRECTED.md`（如有） |
| 文件 A | 两个单板 3MF + 切片报告 + 逐件 STL / STEP |
| 文件 B | `FULL_ASSEMBLY_H/D.step`、`.FCStd`（可选 `.glb`） |
| 检查 | `INTERFERENCE_REPORT.md`、`TUNING_LOG.md` |
| 视图 | `views\l2_r1\` 下 §5 的全部视图 |
| 模拟 | `INTERNAL_COMPONENTS_SIMULATION.md` + 数据 |
| 核算 | `FINAL_ACCOUNTING.md / .json`（按 v2 §11 的 7 个闭合方程） |

任何一项缺失、核算不闭合或 S8 不通过，交付状态都标记为 **INCOMPLETE**。

## 8. 仍待确认的事项

| 事项 | 状态 |
|---|---|
| 3D 对比 | **已完成**（§1.3–1.4）：P1、P7 都不达标，顶面保持 R3.2 原六孔 |
| 传感器 | **已确认 PAW3950**；镜头高度待实测（§4.3） |
| D 方案供体 | **待用户确认**（`DONOR_ID_PENDING_USER_CONFIRMATION`）：用户原写“ATK A1 Pro”，复核仓库记为“ATK A1 Plus”，公开渠道都查不到；烈空 F1 PRO 只作参考。确认后再实物测绘 |
| 侧键风格 | 已定：Fenrir 式外观 + 键带上移防误触 + Puppy V4 式可换模块（§3.4、§3.4.1）；尺寸由 R3.2 推算，没有实测任何一款 |
| R3.2 开口 O1–O4、销孔 | **来源已查明**（§2.1）；执行智能体在重建后复查并写入 `OPENINGS_RESOLUTION.md` |
| 托架腿下方和 PCB 附近的 BODY 材料 | 删除旧座后复查（§3.2 第 3 条）；不属于旧座的，移动托架或 PCB |
| 脚贴厚度 | 默认 0.8 mm（§4.3 第 7 条），以实际脚贴为准 |
| 微动、PCB、镜头实物尺寸 | 目前都是估计包络，以实测替换 |

**调研来源：** [G-Wolves Fenrir Pro 8K – MouseLog](https://mouselog.jp/en/products/G-Wolves%20Fenrir%20Pro%208K)；[Puppy v4 模块化指握套件（B 站 BV1Nhj96zE24）](https://www.bilibili.com/video/BV1Nhj96zE24)；[Puppy v3Air 18 g 开源套件（B 站 BV1BJd1BaExM）](https://www.bilibili.com/video/BV1BJd1BaExM/)；[ATK 烈空 F1 PRO MAX 拆解（腾讯新闻）](https://news.qq.com/rain/a/20240517A0AP4S00)；[ATK 烈空 X1 系列发布（IT之家）](https://www.ithome.com/0/765/102.htm)；[ATK 蜻蜓 A9 系列发布（新浪科技）](https://finance.sina.com.cn/tech/digi/2025-03-23/doc-ineqrtui7404116.shtml)；[ATK X1 Pro Max 规格（inputarena）](https://inputarena.com/product/atk-x1-pro-max-specification/)；[PAW3950 LOD 说明（Rapoo）](https://shop.rapoo.com/blogs/product-comparisons/paw3395-vs-paw3950)；[Omron D2F 数据手册](https://omronfs.omron.com/en_US/ecb/products/pdf/en-d2f.pdf)。

---

## 9. r2 修订记录（2026-10-18）

依据：Quietmirror-L2 仓库 `67dc936d` 的独立复核，以及本地扫描复核 `Quietmirror_L2_Repo_Scan_Recheck_2026-10-18.md`（脚本和数据在 `D:\Quietmirror_L2\l2_repo_scan\`）。

| # | 修正 | 位置 |
|---|---|---|
| 1 | PH1 / PH2 坐标改为 (26.99173, 50) / (27.70980, 65) | §2 K6、§2.1 |
| 2 | O3 确认为滚轮载架钢销通道，保留；O1 / O2 / O4 确认为旧侧键 M2 工具通道，回填 | §0、§2.1、§3.2 |
| 3 | 托架改为单一实体：SR、SF 止挡柱下方底板外延并嵌入 0.3；前、后腿各加连接桥（≥ 4.0 × 1.6，搭接 ≥ 1.0） | §3.4、§4.3 |
| 4 | 腿的 Z 起点分别从耳顶面算起：前 10.80、后 10.525，再加 t_H；r1 的 10.75 作废 | §3.4 |
| 5 | SIDE_IO_PCB 改为 Z 13.3–18.8（离传感器耳 0.5）；新增安装座；复查 X 15.6–17.0 竖墙 | §3.4、§4.3 |
| 6 | 两开关向 −X 移 0.20（按钮尖 X 25.62 / 26.12），后挡墙和底板 −X 边同步移动；推杆长度约 4.68 / 4.98，须重算 | §3.4 |
| 7 | 偏心标注改为“Y 0 / Z −0.9”；力比固定为“距铰点 L/4”（1.736× / 1.748×），并附对照定义 | §0、§3.4、§6 S4 |
| 8 | 侧键扫掠角 7.1° / 6.7° 改为名义止挡 6.56° / 6.21°；触发角另外报告 | §4.3、§6 S3 |
| 9 | 有限元选面定义全部写明；体积一律用自适应积分（默认 `Volume()` 把 BODY 多算 560.5 mm³） | 文首、§1.2、§3.1、§6 |
| 10 | 底面基准：外缘 Z 5.0 比脚贴面低 0.2；默认脚贴 0.8 mm，外缘离地 0.6 | 文首、§4.3 第 7 条、§6 S5 |
| 11 | D 方案供体改为“待用户确认”，F1 PRO 只作参考；3MF 文件名改为 `ATK_DONOR_PENDING_…` | §0、§4.1、§4.3、§8 |
| 附 | 质量预算改为约 17.42 g（+65 mm³ 连接件）；内存上限改为 ≤ 8 GB；Dremel 床尺寸标注为配置假设；“L1 / L2 达不到”改为“已评估的候选没有证明能达到” | §0、§3.3、文首、§4.1 |

**未变：** 顶面六孔、壳厚 1.8、骨架、主键、滚轮、侧键外形和铰点、PAW3950、§1 的全部 3D 结论。
