Quietmirror/Quietmirror-L2/handoff/l2_r3/PARAMETERS_CORRECTED.md

# L2-r3 参数与实现修正

1. 以新 r3 文档作为当前执行方案；旧 r2 文本归档。未提供的作者 JSON 不伪造，独立转录结果见 reports/l2_r3/parameters_implemented.json。
2. 止挡筋 Z15.9–16.4 为 0.5 mm，保留坐标端面，修正文中“高0.6”的冲突。
3. 推杆名义运动约0.6003/0.6001 mm，保留0.35静止间隙时，微动压入仅约0.25 mm。平压盘加0.33垫片时在倾转末段碰微动外壳，实测几何记录已归档；改为Ø3、高0.6、R2.175圆顶接触面及随形垫片，端点不变。新接触面仍须真实微动测试。
4. 文档估计的键帽内表面 X 与实际母面不同。推杆根部和卡舌连接筋延至实际键帽，端点及卡舌坐标不变；随后以圆角键面轮廓裁剪连接筋，去除隐藏穿模。初次碰撞位置保存在 pre_correction_overlap.json。
5. 端子槽明确为 Y宽1.6、Z高1.2、中心Z16.6；端子参考截面0.9×0.4。PCB窄中座只承托，两个端座补M1.2固定孔，仍需真实电路板/焊接空间验证。
6. 钢销竖直范围14.75–20.25；固定凸耳14.2–15.2、19.8–20.8；隐藏铰节配合与薄壁需试打印校准。孔径0.95/1.05不能当作FDM实际成孔精度保证。
7. 外键面使用母面沿X偏移0.20形成，属于法向偏移的近似；不能冒称严格等距面。F2外偏0.30为单独试验件，没有另加文档所称的0.15外凸脊，因此实际名义偏移0.30，不冒称总突出0.45。
8. 主键局部薄壳和纵/斜筋保留原触发、铰链、前端区域；硬止挡附近额外保留原厚度，纵筋从Y14.5开始，避免侵入止挡运动空间。固定滚轮铰座的前缘局部退让至Y47.5，轴孔不变、剩余前壁至少1.325。筋根R0.4尚未完整落实，列为未通过细节。
9. 原五脚粘贴面保持Z5.2，示意脚贴0.8，垫面Z4.4，原外缘Z5.0，外缘离垫0.6。没有按手长再次等比放大。
10. 供体仍为用户所称ATK A1 Plus且待确认，不能替换为A1 Pro。H的PAW3950只是传感器型号，不代表统一PCB或已验证无线功能。
11. 重型程序使用现有 -MemoryGiB 4 参数；不使用不存在的 -LimitGB 8，不更改系统内存策略。
12. Ø2顶部视线试验最初分别被0.467/0.448mm³材料挡住。在(29,45)/(29,70)从Z20.8向上作Ø2.1局部通道，保留下方固定凸耳和压配孔；这改变两处局部窗口/上圈边缘，属于为满足B7作出的明确偏离，不能声称六孔边界严格完全不变。
13. 原主键内侧固定轴座局部轴向厚度从2.4降为2.2（内面|X|8.7→8.9），轴孔/轴线不变，给滚轮载架让位。仍存在的功能配合和目标间隙差异见最终干涉报告。
14. 主键纵/斜筋在按下末端与微动硬壳相交，已按21姿态反变换的硬壳外扩0.3包络局部削减加强筋，保留触发柱。编码器假设转接板在4.1°末端有0.0033mm³碰撞，新增局部避让缺口；不要求切割任何真实供体PCB。
