Quietmirror/Quietmirror-L2/handoff/l2_r3/README.md

# Quietmirror L2-r3 交付目录

当前状态INCOMPLETE。先读SECOND_CHECK、INTERFERENCE_REPORT和SIDE_KEY_FUNCTION，再选择打印试验件。FINAL_ACCOUNTING提供CAD质量和真实切片结果。历史r2复核仍保留于handoff/l2_r2。
