Quietmirror/Quietmirror-L2/handoff/l2_r2/README.md

# r2 独立复核交付

[详细复核](SECOND_CHECK.md) · [参数修正](PARAMETERS_CORRECTED.md) · [开口处置](OPENINGS_RESOLUTION.md) · [来源与范围](PROVENANCE.md)

[诊断 STEP](../../exports/l2_r2_diagnostic/) · [实测 JSON](../../reports/l2_r2/) · [实际几何视图](../../views/l2_r2/) · [独立复核源码](../../cad/l2_r2/)

状态：**REVIEW_COMPLETE_WITH_REQUIRED_CORRECTIONS；最终模型 INCOMPLETE。**

r2 方案已设为当前方案。旧版本保留；本轮没有修改生产 BODY、原底部、功能接口或 R3.3。压缩包用于携带复核数据和依赖，原始 FEM 求解输入/输出仍保存在本地 `_support/work/fem_r2/`，公开程序可重新生成。
