Quietmirror/Quietmirror-L2/handoff/l2_r3/SLICE_REPORT.md

# 单盘切片

真实切片器：PrusaSlicer 2.9.6。255×155mm床面是3D45配置假设，PLA、0.4mm喷嘴、0.20mm层高，模型不缩放。提供3MF，不发布可直接发送给未知打印机的G-code。

总耗材 **35.91 g**；预计 **4h 50m 28s**。

方向：BODY保持装配Z朝上，原外缘最低面落床；主键与侧键保持Z朝上；托架平底朝下；滚轮绕Y转90°使轴竖直；滚轮载架平放。支撑开启，包括主键悬垂触发柱/铰链、BODY横梁和顶壳、侧键推杆/卡舌、滚轮轴端及载架悬垂。细小配合面去支撑后必须检查和修整。

零件间距至少12mm，给支撑底部和2mm外缘brim留出空间；第一次8mm排布出现切片路径冲突，已重新排布。各零件尺寸、放置位置、嵌入配置及按挤出角色估重见 [slice_summary.json](../../reports/l2_r3/slice_summary.json)。同一盘高度不同可能影响小件冷却，实际打印机需重切片。
