Quietmirror/Quietmirror-L2/handoff/OPENINGS_RESOLUTION.md

# L2 r2 开口处置复核

r2对O1/O2/O4、O3、PH1/PH2的来源与上轮独立证据一致。本轮没有执行生产BODY回填，不能把下表“决定”当成已经完成的几何修改。

| 项 | 证据 / 决定 |
|---|---|
| O1 | 旧侧键M2工具通道；六孔外25.960494 mm³；源码取消该刀具 |
| O2 | 同类旧工具通道；六孔外16.695654 mm³；源码取消 |
| O4 | 第三处旧工具通道；六孔外2.143018 mm³；源码取消 |
| O3 | 轴线Y50/Z19、Ø2.35的滚轮钢销装入通道；保留贯通 |
| PH1 | 旧捕获销Ø1.72孔，中心(26.99173,50)；取消旧刀具 |
| PH2 | 旧捕获销Ø1.72孔，中心(27.70980,65)；取消旧刀具 |

O1/O2/O4三处仅六孔以外附加切除合计44.799166 mm³；不是“两个开口”，也不包含所有新侧键开口、夹持带回填和销孔的净变化。六孔边界不得缩小。

§2.1源码取消与§3.1外扩补片措辞不一致，本轮采用前者作为后续重建路径。最终验收：BODY单实体、无无效几何、六孔与基准相同、O3路径可达、体网格成功、全部回填与切除的净体积入账。当前这些最终项均PENDING。

证据：[K6 r2](../reports/l2_r2/K6_r2_crosscheck.json)、[r1源文件定位](../reports/l2_r1/K6_source_openings.json)。
