Quietmirror/Quietmirror-L2/handoff/PARAMETERS_CORRECTED.md

# L2 r2 参数修正记录

状态：**前置复核完成，必须处理以下问题才能进入正式模型验收。** 当前附件原文存档不改写；本表是r2的独立复核补充。

| 编号 | 已确认问题 | 修正 / 后续验收条件 |
|---|---|---|
| C1 | r2后腿Z10.525侵入原PCB耳；前腿10.80只触圆弧筋 | 原平面承台Z10.75、筋冠Z10.80。按完整支承底面设计带让位的转接座；禁止把局部射线高度叫做整面高度。后耳中心Y66.0与腿中心66.8分别参数化。不得删原PCB耳消除冲突 |
| C2 | H转接件未闭合；1.6厚叠装顶面高过底板 | 定义z_adapter_top，再由h_leg=12.1−z_adapter_top求腿高。若用10.80基准，t_H<1.30仅保证正高度；承力、螺钉头/垫片/啮合长度另算。若超出，应改变托架标高或叠装路径，随后重验微动与键帽 |
| C3 | 前桥、腿和下包环都未满足主键铰座间隙 | 用完整铰座而不是只有Y<41.6的圆柱前缘作禁入体。腿/桥/环完整包络离保留铰座≥0.5；重布桥的Y轮廓和安装支点，保证连续承力与M2孔周材料。当前诊断没有给出已通过的新轮廓 |
| C4 | 原削平X29.0/30.1不足以避开侧壁；两桥穿壁 | 用实际内壁的0.5净空约束定桥/腿轮廓，不能只用母壳外表面或恒定X截断。外侧孔周剩余材料很窄，继续削平可能开破M2孔；应同时重新安排支点/转接，不可只硬切薄 |
| C5 | 底板外延与微动0.2/0.0，与“均≥0.5”冲突 | 把有意坐底接触面明确列入允许表，非支承侧面仍≥0.5；若坚持外延全部≥0.5，需阶梯让位并保持正体积连接及规定厚度。不能把未列明的接触静默忽略 |
| C6 | SR微动距统一后挡墙0.5 | 为后微动单独定义与反力方向对应的承压台或台阶、端子槽和定位方式；不得假定未知PCB焊脚即可承受按压力。新增部件不得侵入SF、隔板或PCB |
| C7 | K3两档原表容差未全部通过；独立三档也存在网格敏感性 | 保留所有数值。补齐作者网格、选面函数和输入，或以统一且收敛的独立流程重建R32/P0及最终L2基线；不能通过调整E或挑选载荷区逼近原表 |
| C8 | K8算术已清楚，但实际转动和开关触发行程未定 | 保留Y0/Z−0.9；以实际铰轴X/Z和推杆X求刚体运动、止挡、触发及超程，FP/OP/TTP未测时标UNVERIFIED。钢销配合单列，不套用普通0.5净空 |
| C9 | §2.1要求源码撤销旧刀具，§3.1又写外扩补片 | 选择源码层取消O1/O2/O4和PH1/PH2刀具；六孔边界、O3滚轮销通路保持。生产重建后验单实体、六孔边界、通道、网格及体积，不在成品BODY盲补 |
| C10 | r2文字把供体原名写成A1 Pro，输出目录仍l2_r1 | 供体历史按用户原消息ATK A1 Plus保留，实际型号未确认。新复核资产统一l2_r2目录，保留l2_r1。17.424902 g只作预算，最终由逐件CAD/切片替换 |

已确认可以沿用：六孔及1.8蒙皮；K5逐组保留关系；O3通路保留；K8新的力比定义；微动移−X后的0.5关键间隙；PCB上移后的0.5传感器耳间隙；0.8脚贴对应0.6外缘离地。单一连通托架已能构成，但上述装配问题未因此自动解决。

参数数据：[parameters_reviewed.json](../cad/l2_r2/parameters_reviewed.json)。诊断桥、环、PCB座位置是公开假设，不是已批准的生产尺寸。生产BODY和原接口本轮均未更改。
