Quietmirror/Quietmirror-L2/handoff/l2_r3/SECOND_CHECK.md

# L2-r3 独立复核

状态：**INCOMPLETE / 预发布**。用户已明确要求继续复核、建模和 GitHub 发布，不通过则预发布。本轮没有把附件中“作者已验证”当成本机验收结论。

基准：Quietmirror/github@f1b1090931d717117287ea2b79c2e14ddc234937 的 R3.2。当前 r3 方案见 [原文](../../specs/Quietmirror_L2_r3_FINAL_Build_and_Release_2026-10-18.md)。R3.2、R3.3、r1/r2 历史保留。

| 门槛 | 状态 | 证据/限制 |
|---|---|---|
| G1 | PASS | 8 个打印件；CAD 单实体、自相交和封闭网格见 solids.json |
| G2 | INCOMPLETE | 打印件 28/28 对；穿模 0 对；不足目标间隙 1 对 |
| G3 | INCOMPLETE | 最终装配包络检查 248 对，其中 3 项未满足通用阈值；作者 62 项原始证据未提供 |
| G4 | INCOMPLETE | O3 贯通：True；原六孔多边形保留，最终曲面边界等价性未完整证明 |
| G5 | INCOMPLETE | 5/5 组打印件运动穿模记录 0；微动壳体/滚轮随动组件 0；运动最小间隙曲线未认证 |
| G6 | INCOMPLETE | Ø2钢销顶部探针已检查；载架直线上装最大重叠 212.250 mm³，此路径不能使用，倾斜装入未证明 |
| G7 | INCOMPLETE | H 为估计包络；D 假设板 1 处相交，不能宣称真实供体适配 |
| G8 | 3D_FEM_BLOCKED | 整壳迭代求解在615.3秒后因系统可用内存低于512MiB被保护器中止（任务峰值0.471GiB，未触及4GiB上限）；三档刚度比较未完成，小梁误差−1.635%不能替代整壳结论。 |
| G9 | INCOMPLETE | S1/S2/S3/S5/S6/S9 提供相应证据；S4 实际按压力、S7 预紧/托架应力和 S8 刚度未完成认证 |
| G10 | PASS_CAD_ESTIMATE | CAD 17138.856 mm³；PA12 密度 1.01 时 17.310 g；切片 35.91 g |
| G11 | UNVERIFIED | 键帽/垫片对壳体包络的行程干涉记录 0；实物微动、PET 调整和通断未测 |

K1：重新导入原九个打印 STEP，自适应体积 18506.678218 mm³，与文档一致。K2：既有独立梁验证误差约 −1.47%/−1.38%；本轮新迭代求解链的梁验证误差为 -1.634729631149101%，详见FEM_beam_2.4.json。K3：r3 使用 curvature=24 和不同最小网格尺寸，已生成新基线网格，原 r2 网格数值不替代它。

K5：保留原 r2 的 12 组来源分类，实际修改在版本化 mechanics.py 中完成。Y54 外臂在源生成时裁至 X±6；原后横梁、滚轮枢纽、主键铰座与底部接口保留。K6：旧侧键开口、捕获销和 M2 工具通道随旧循环一起取消。

K9：本轮载架由文档坐标独立生成。未收到作者 r3_parameters.json、参考 STEP、fem_variants.py 或 repo_scan 目录，无法声称与作者参考模型逐项差异≤0.02 mm。实际修正和失败项见配套报告。

测量中 AABB 下界只用于证明某些零件距离已超过验收阈值，不冒充精确最小距离；BODY 只截取目标附近的局部区域做精确求交和阈值距离检查。运动是每组至少 21 个姿态，侧键另有超止挡 0.3° 诊断，不能证明全部连续路径或真实装配。
