Quietmirror/Quietmirror-L2/handoff/archive/l2_r1/README.md

# r1 原始报告存档

此目录保留 r1 交付时的原始 Markdown 字节，包括当时按项目根目录和 `handoff` 位置书写的相对链接。

需要在线阅读带原路径的完整 r1 版本，请使用 [GitHub 的 r1 固定提交](https://github.com/Quietmirror/Quietmirror-L2/tree/67dc936d1928946b9713bc3418b2bda9325b9aa6)。本地源文件和测量证据仍在 `cad/l2_r1`、`reports/l2_r1`、`views/l2_r1`，未被 r2 覆盖。

现行版本请阅读 [r2 复核](../../l2_r2/SECOND_CHECK.md)。
