Quietmirror/Quietmirror-L2/handoff/archive/l2_r1/OPENINGS_RESOLUTION.md

# R3.2 孔洞来源与 L2 处理决定

独立依据：[K6数据](../reports/l2_r1/K6_source_openings.json)，[独立复核代码](../cad/l2_r1/independent_check.py)。检查对象为指定R3.2提交，不是R3.3。

| 编号 | 源特征 | 六孔之外附加切除 mm³ | 决定 |
|---|---|---:|---|
| O1 | SIDE_FRONT_KEY_M2_SWITCH_1 | 25.96049 | 停止生成旧侧键M2工具通道，在保留六孔边界的前提下恢复母壳 |
| O2 | SIDE_REAR_KEY_M2_SWITCH_1 | 16.69565 | 停止生成旧侧键M2工具通道，在保留六孔边界的前提下恢复母壳 |
| O4 | SIDE_REAR_KEY_M2_SWITCH_2 | 2.14302 | 停止生成旧侧键M2工具通道，在保留六孔边界的前提下恢复母壳 |
| O3 | 滚轮载架钢销贯穿/装入通道，轴Y50/Z19、Ø2.35 | 不以回填体积判断 | **保留**，不得当外观残孔封住 |
| PH1 | 旧前侧键捕获销，XY=(26.99173,50)，Ø1.72 | 待最终母面重建 | 删除旧销后恢复母壳，保留新的杠杆铰链孔 |
| PH2 | 旧后侧键捕获销，XY=(27.70980,65)，Ø1.72 | 待最终母面重建 | 同上 |

O1/O2/O4的源代码链：`mechanics.py`侧键M2调用 → `fasteners.py:m2_set`的半径2.15、长度38的工具通道 → R3.2 `rebuild_body`应用切除。不是未经确认的“微动从顶部放入开口”。

O3由 `wheel_mechanism.py` 的 `cuts.append(cylinder(1.175,82.,(-41,py,wz),(1,0,0)))` 生成，并由 `mechanics.py` 的同轴 `pin_paths` 防止新增骨架重新堵孔。左右侧均存在相应功能通道。实际负X侧外边界约X−31.027…−29.998、Y48.825…51.175、Z17.825…20.175。

六孔本身保持R3.2定义。O1/O2/O4有部分区域与原六孔重叠；独立复核先从母皮切除中扣除六孔，才得到25.96049/16.69565/2.14302 mm³。不能把整根圆柱与母皮的交集全部回填，否则会缩小原六孔。

此表是已确定的建模决策；本阶段未改变原BODY。正式重建后需重新检查缝合、实体数、体积和网格，不宣称当前已经完成回填。
