Quietmirror/Quietmirror-L2/handoff/archive/l2_r1/SECOND_CHECK.md

# L2 最终方案：独立复核

日期：2026-10-18。结论：**REVIEW_COMPLETE_WITH_REQUIRED_CORRECTIONS；未通过原文全部前置条件，整体交付仍为 INCOMPLETE。**

本轮落实用户“按新方案执行，先独立复核”的步骤。采用指定 R3.2 提交 `f1b1090931d717117287ea2b79c2e14ddc234937`；不改写现有 R3.3，也不把本次诊断件作为新鼠标发布。

所有检查脚本位于 [cad/l2_r1](../cad/l2_r1/)，仅调用 CAD、数值计算及求解器库；没有导入文档作者的几何/FEM 函数。基准尺寸和形状来自归档源代码、STEP 和 FCStd，保留原 [许可证](../LICENSE) 与 [署名](../NOTICE.md)。

## K1–K10

| 项目 | 文档值/要求 | 独立复核 | 偏差与结论 |
|---|---|---|---|
| K1 九个打印件体积 | 18506.6761 mm³，±0.5 | 18506.678218 mm³；PA12 18.691745 g | +0.002118 mm³，通过。九件均为有效单一实体 |
| K2 解析梁 | 误差 <5%；作者报告 <1.5% | 2.4 / 1.6 mm 网格误差 -1.471% / -1.375% | 两档通过；两档均核查合力、力矩平衡 |
| K3 八个基线工况 | 与文档数值 ±3% | 八个均完成，2项在数值容差内，6项超出；见下表 | **不能标记原作者复现通过**：原文缺少若干载荷区、约束点及刚度定义。独立输入和结果可复现 |
| K4 Y54 横梁切断 | 约 X±11.5–13.5 | Y54/Z23 截线断口 X=±11.3–13.7；Y53/Z23 约±11.525–13.475 | BRep 确认切断；不能把近似坐标写成固定精确范围 |
| K5 依赖蒙皮的内构件 | Y67.5 横梁及中心枢纽，要求完整排查 | 按原始内腔边界去除蒙皮后，得到 12 个有效几何连通组 | 文档列举不完整；还包括四个主键固定铰座、后部传感器安装区等。原始 BODY 仍是一个有效实体，12组不表示原壳有12个悬浮件 |
| K6 孔洞来源 | O1/O2约26.0/16.7 mm³，O3未知，O4约2.1 | O1/O2/O4在六孔之外的附加切除为25.96049/16.69565/2.14302 mm³；O3为滚轮钢销通道 | 三处体积及位置一致；O3必须保留。见 [孔洞处理表](OPENINGS_RESOLUTION.md) |
| K7 外侧曲面X | 表中32个点，±0.05 | 直接与原始BSpline支撑面求交，最大误差 0.01992 mm | 32/32通过；不能据此证明键帽运动/装入可行 |
| K8 侧键杠杆 | 季长点力比1.74/1.75；偏心0 | 按键帽边缘量1/4长度：2.35955/2.33684；Y居中，但Z偏心−0.9 mm | 力比定义及“偏心”标注必须修正。转角6.56243°/6.20627°及末端行程1.29143/1.28649 mm与文档近似值相符 |
| K9 托架及障碍间隙 | 固定件/电子包络≥0.5 mm | 按列出的构件形成3个分离实体；后腿距底板1.104 mm；PCB到传感器耳0.200 mm；3处0.300 mm | **不通过**。后腿到脚贴支撑0.59120 mm通过；所有数值见 [K9 JSON](../reports/l2_r1/K9_document_layout.json) |
| K10 最终质量 | 约17.36 g；CAD实测替换 | 逐项预算−1319.3 mm³，得到17.35925 g | 预算算术通过；新增连接筋、圆角、安装件及最终整件尚未建成，最终CAD质量**待测** |

## K3 数值与证据范围

单位：N/mm。E=1500 MPa、ν=0.35；五脚Uz约束，另3个面内约束。实际网格84309节点、45780个C3D10实体单元；全部8步完成，合力及力矩平衡均通过。峰值作业内存约1.154 GiB。

| 工况 | 文档k | 独立k | 差异 | 比较 |
|---|---:|---:|---:|---|
| palm_down_20N | 105.64 | 105.19008 | -0.426% | 数值在 ±3% 内 |
| left_main_root_down_5N | 24.95 | 33.36102 | +33.711% | 超出 ±3% |
| right_main_root_down_5N | 24.28 | 35.40886 | +45.836% | 超出 ±3% |
| side_50_fence_5N | 34.47 | 32.21079 | -6.554% | 超出 ±3% |
| side_65_fence_5N | 29.37 | 27.85232 | -5.167% | 超出 ±3% |
| LC3_squeeze_2x2N | 496.43 | 626.61587 | +26.224% | 超出 ±3% |
| press_A_d16 | 62.21 | 63.03223 | +1.322% | 数值在 ±3% 内 |
| press_B_d16 | 56.21 | 53.63521 | -4.581% | 超出 ±3% |

独立刚度定义为 `k=F_norm²/(f·u)`；对向夹持 `F_norm=4 N`。载荷按二次三角形积分分配到中边节点。精确选面范围、约束节点与面积在 [K3输入](../reports/l2_r1/K3_inputs_2.4.json)，结果和力平衡在 [K3结果](../reports/l2_r1/K3_independent_R32_2.4.json)。文档未提供的选择已明确写在独立脚本内，不能视为与原作者完全相同的工况。

初次曲面投影的二次网格出现负雅可比，CalculiX退出201；没有使用失败结果。随后采用直边中节点二次单元并优化一次网格，完成计算。它近似真实曲面，后续最终壳体仍需网格收敛。本轮未重新计算文档缺失的P0/P1细网格数据，亦未宣称14.89 g在所有可能设计中均不可实现。

原始 `.geo/.inp/.dat/.sta`、Gmsh/CCX日志在 `_support/work/independent_fem/`。独立脚本可以重新生成，失败日志保留。解析梁采用线弹性理论对照，不是对该大位移梁的实体试验。

## 几何与硬件边界

- 五脚平台下表面均为 Z≈5.1999999 mm（CAD容差），极差小于1e−12 mm，确认名义Z5.2共面。
- K9诊断省略了尚未定义中心位置的底板减重窗和端子槽；删除这些材料不能使分离的支腿/止挡重新连接。702.749 mm³是该**未开完整窗口**诊断托架的体积，不能与640 mm³预算直接作最终误差判定。
- K5的12组来自“去除原始蒙皮后的材料”这个明确集合；每组包围盒和体积已保存，未将小组随意删除。主键铰座和滚轮铰座的受力必须纳入后续模型。
- 传感器继续为PAW3950目标；镜头基准距离、供体板形和孔位仍未实测。文档不能替用户将“ATK A1 Plus”改成F1 PRO；D方案保持待确认。
- 微动仍是估计包络。0.60总行程减0.05间隙，仅得到名义0.55 mm压下，不能单凭PT上限/OT下限证明每一颗实物的触发和止挡安全。

## 产物及下一步入口

- [参数修正记录](PARAMETERS_CORRECTED.md)：确认错误、可实施修正方向及仍待实测的参数。
- [孔洞处理表](OPENINGS_RESOLUTION.md)：逐项来源和保留/回填决策。
- [几何诊断STEP](document_side_layout_UNCORRECTED.step)：仅用于查看分离位置，不用于打印。
- [参数化复核数据](../cad/l2_r1/parameters_reviewed.json)。

侧键托架诊断

横梁截面

本次完成独立复核阶段。正式鼠标几何、H/D装配版、最终STL/STEP/3MF、运动和装入检查、最终质量及S8刚度验收仍未完成，不能将本报告或诊断STEP标为最终可打印版。
