Quietmirror/Quietmirror-L2/handoff/archive/l2_r1/PROVENANCE.md

# L2 R1 独立复核工作区

- 用户于 2026-10-18 确认采用 `specs/Quietmirror_L2_FINAL_Plan_2026-10-17.md`，先独立复核。
- 几何与历史源代码基准：Quietmirror/github `f1b1090931d717117287ea2b79c2e14ddc234937`，R3.2。
- 本目录基准文件由该提交的 Git archive 导出，不读取原工作树的修改版本。
- 原工程 `D:\Projects\Quietmirror\github` 和其 R3.3 工作内容保留。
- `_support/python`、`_support/venv`、`_support/tools` 为指向已有 D 盘便携工具的目录联接；缓存、配置、日志、计算文件在本工作区。未重装工具，未修改系统设置。
- 实测物理内存约 15.78 GiB，建立工作区时空闲约 2.90 GiB。文档 24 GB 上限不适用；作业默认 4 GiB Windows Job 内存硬上限，单线程、低优先级、串行；系统可用内存低于 512 MiB 时只终止本作业树。
- 17.36 g 为待几何测量替换的预算。供体型号不擅自从用户的 ATK A1 Plus 替换为 F1 PRO；D 方案继续标注未确认。
- 附件中作者的 FEM、装配与尺寸结论是待独立复核输入，不作为已通过证据。
