Quietmirror/Quietmirror-L2/handoff/archive/l2_r1/ROOT_README.md

# Quietmirror L2 R1 — 独立复核阶段

已采用2026-10-17新方案并完成2026-10-18独立复核。状态：**REVIEW_COMPLETE_WITH_REQUIRED_CORRECTIONS / INCOMPLETE**。

先读 [SECOND_CHECK.md](handoff/SECOND_CHECK.md) 和 [PARAMETERS_CORRECTED.md](handoff/PARAMETERS_CORRECTED.md)。正式H/D装配模型、最终打印STL/3MF以及最终验收尚未生成。现有R3.3和原工程未覆盖。

本目录基于指定R3.2提交导出，并保存原有CERN-OHL-P-2.0许可证及NOTICE。工具通过D盘目录联接复用；新缓存、日志、报告在本目录。
