Quietmirror/Quietmirror-L2/cad/l2_r3_check/views/R3_module_right.png

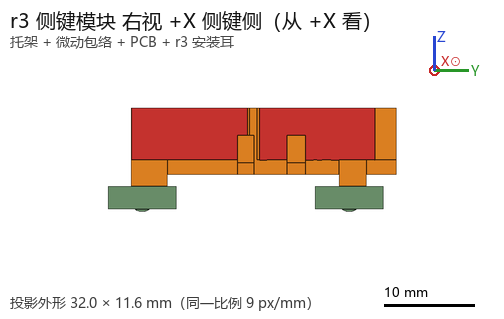
cad/l2_r3_check/views/R3_module_right.png
