Quietmirror/Quietmirror-L2/views/l2_r1/K4_cross_tie_sections.png

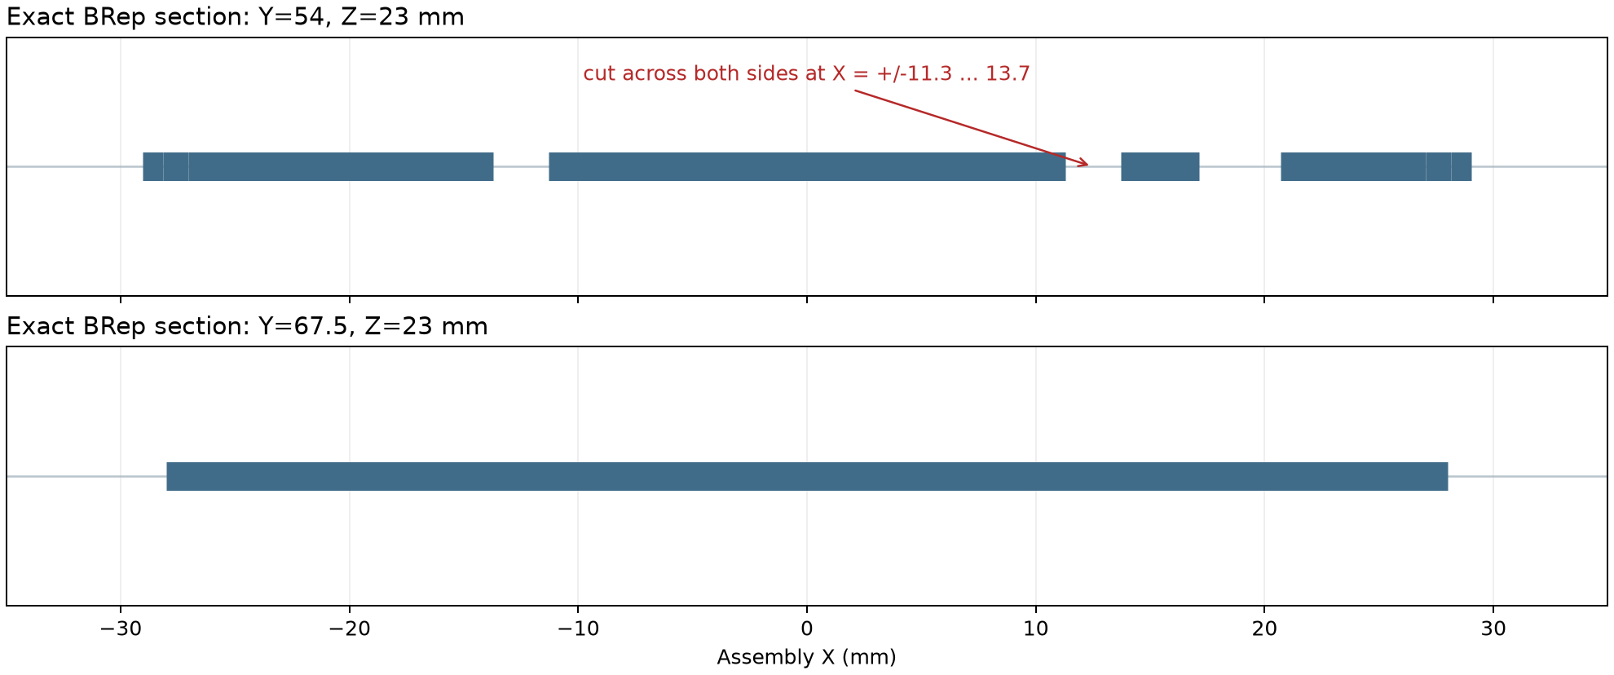
views/l2_r1/K4_cross_tie_sections.png
