Quietmirror/Quietmirror-L2/views/l2_r1/K9_side_carrier_diagnostic.png

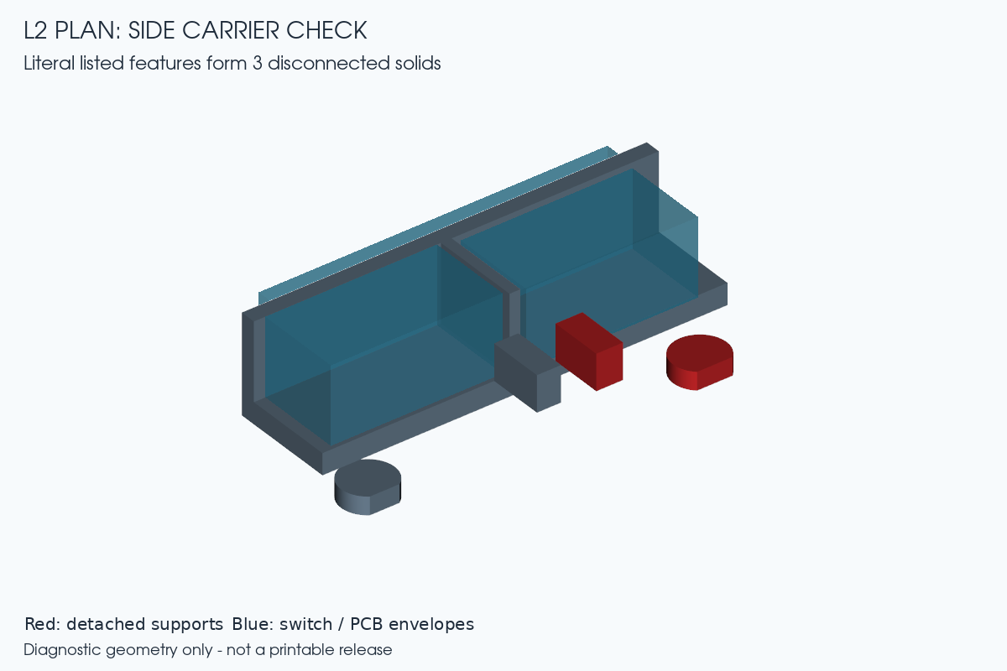
views/l2_r1/K9_side_carrier_diagnostic.png
