Quietmirror/Quietmirror-L2/views/l2_r3/H_BOTTOM.png

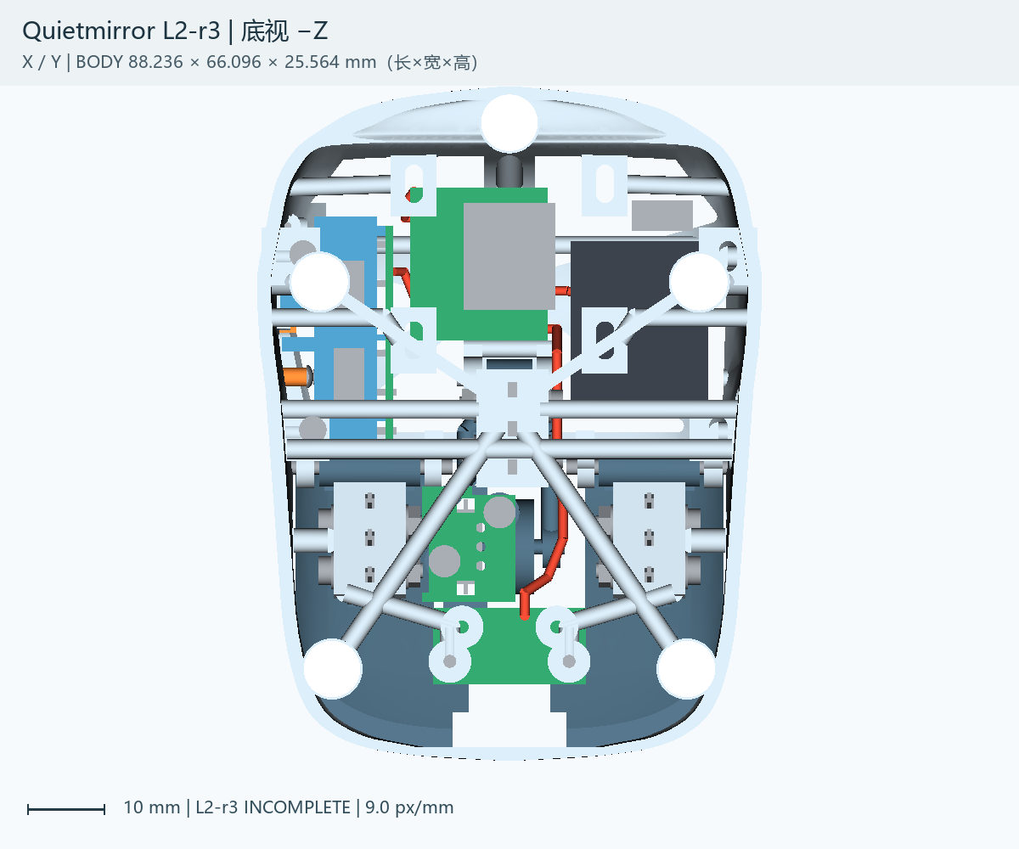
views/l2_r3/H_BOTTOM.png
