Quietmirror/Quietmirror-L2/views/l2_r3/H_ISO_REAR.png

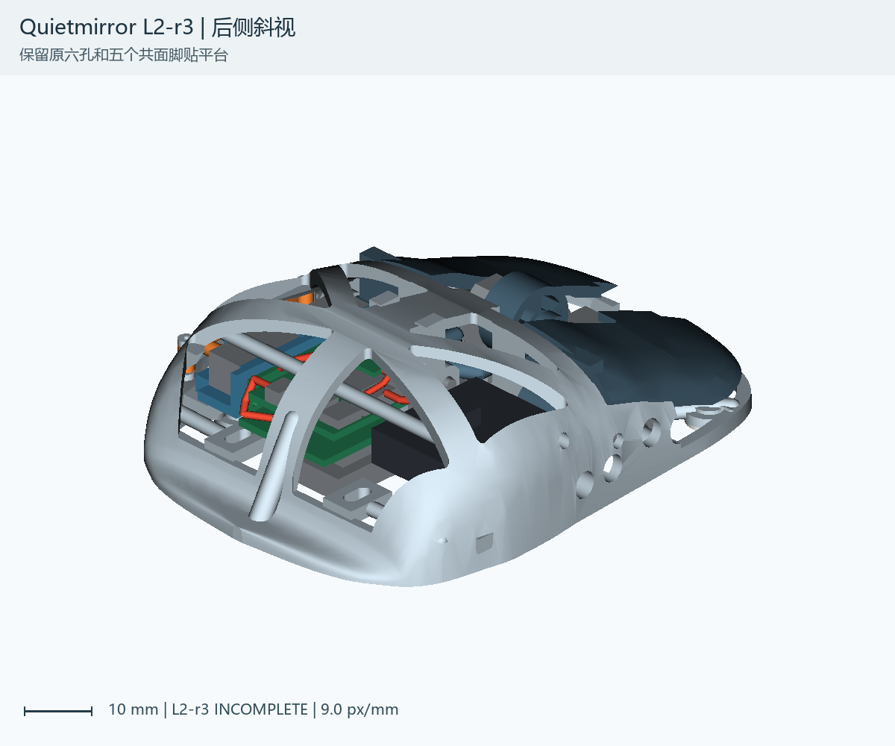
views/l2_r3/H_ISO_REAR.png
