Quietmirror/Quietmirror-L2/views/l2_r3/INSIDE_BACK.png

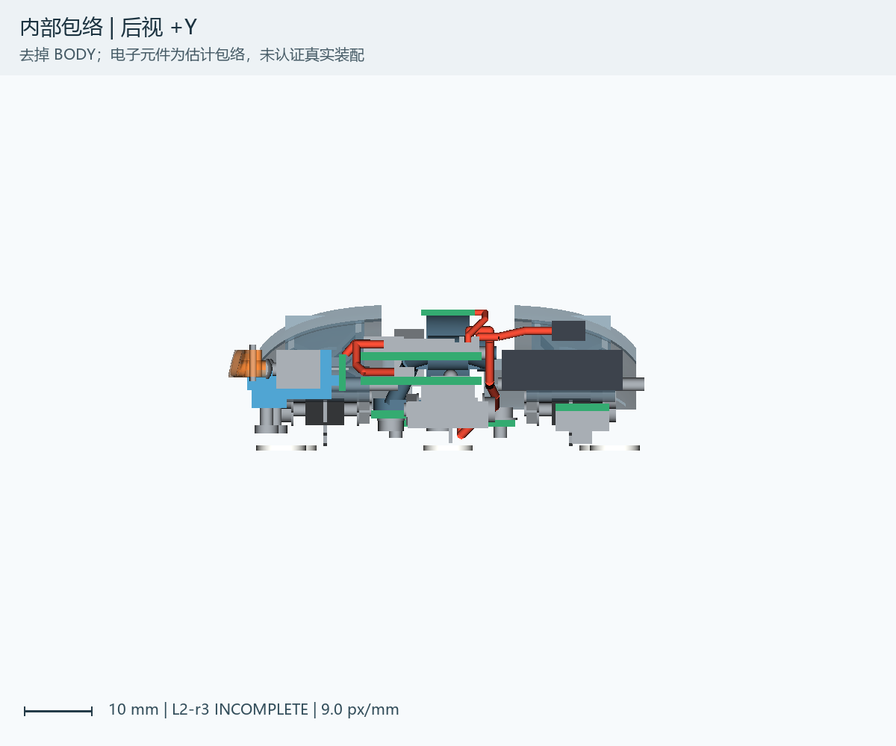
views/l2_r3/INSIDE_BACK.png
