Quietmirror/Quietmirror-L2/views/l2_r3/INSIDE_RIGHT.png

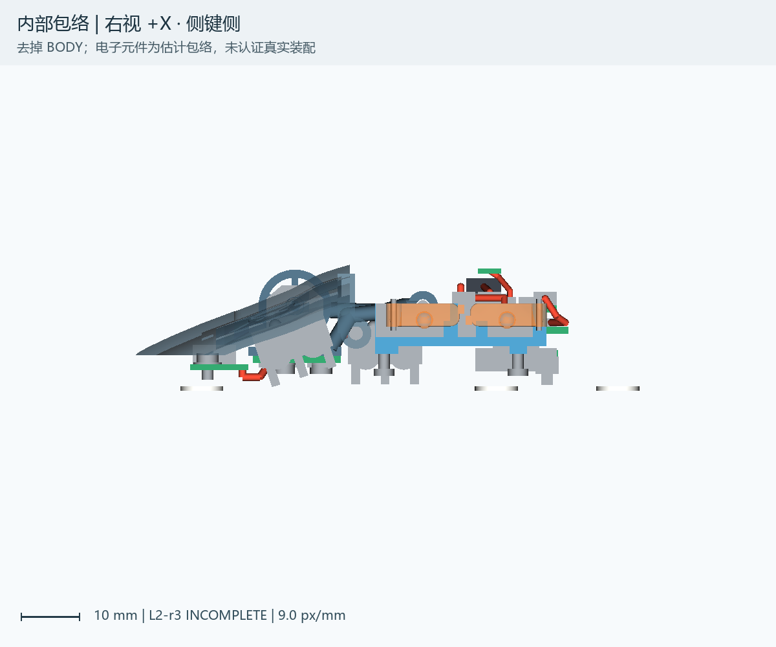
views/l2_r3/INSIDE_RIGHT.png
