Quietmirror/Quietmirror-L2/views/l2_r3/INSIDE_TOP.png

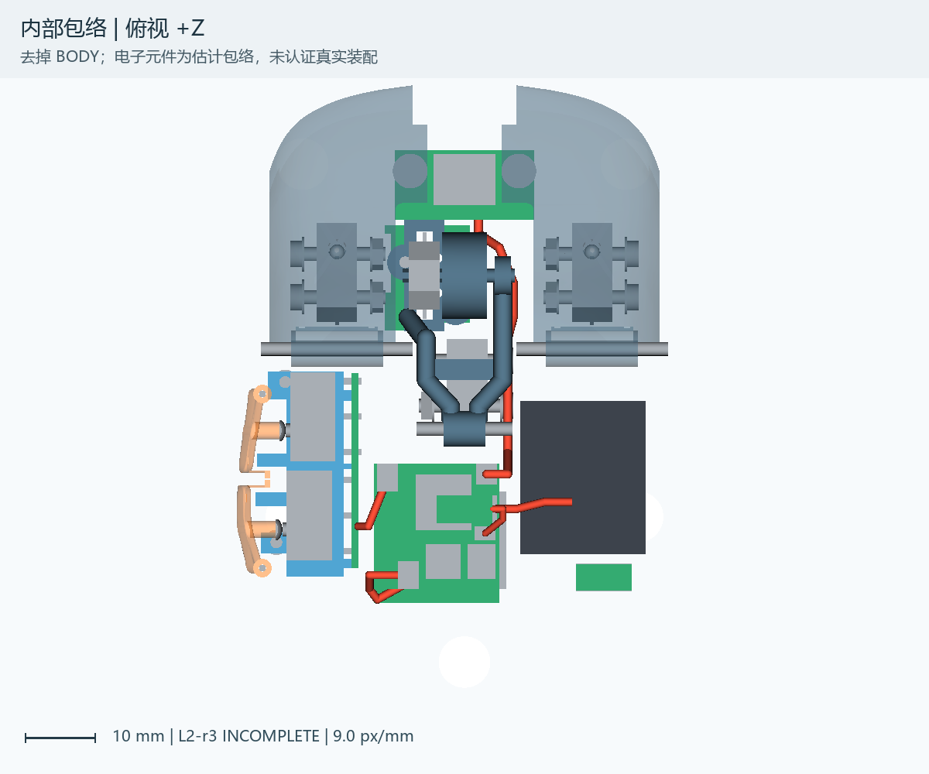
views/l2_r3/INSIDE_TOP.png
