Quietmirror/Quietmirror-L2/views/l2_r3/R32_BASELINE.png

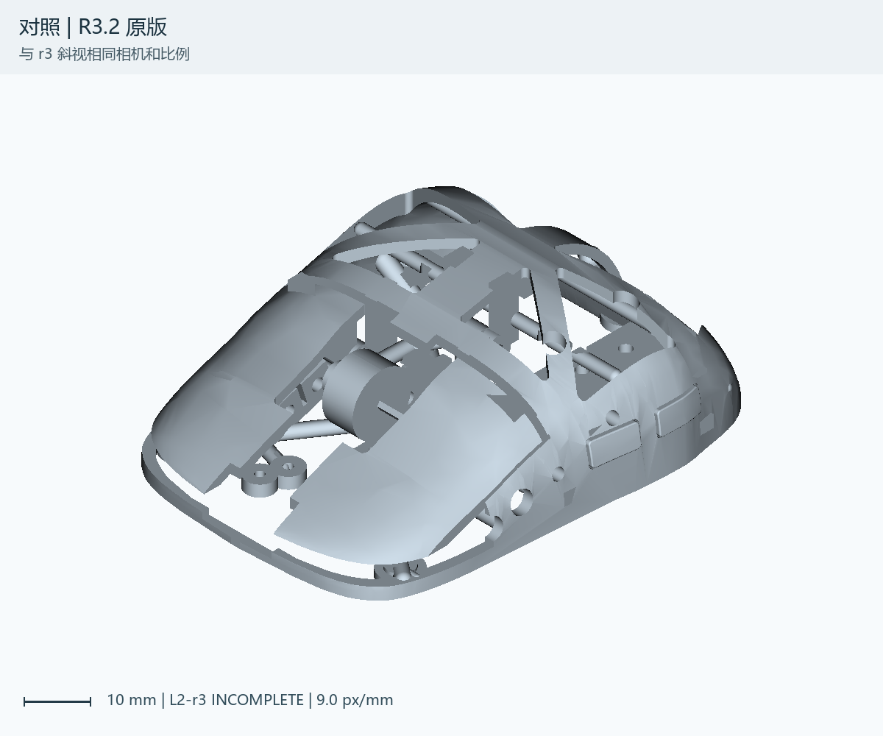
views/l2_r3/R32_BASELINE.png
