Quietmirror/Quietmirror-L2/views/l2_r3/R32_BOTTOM.png

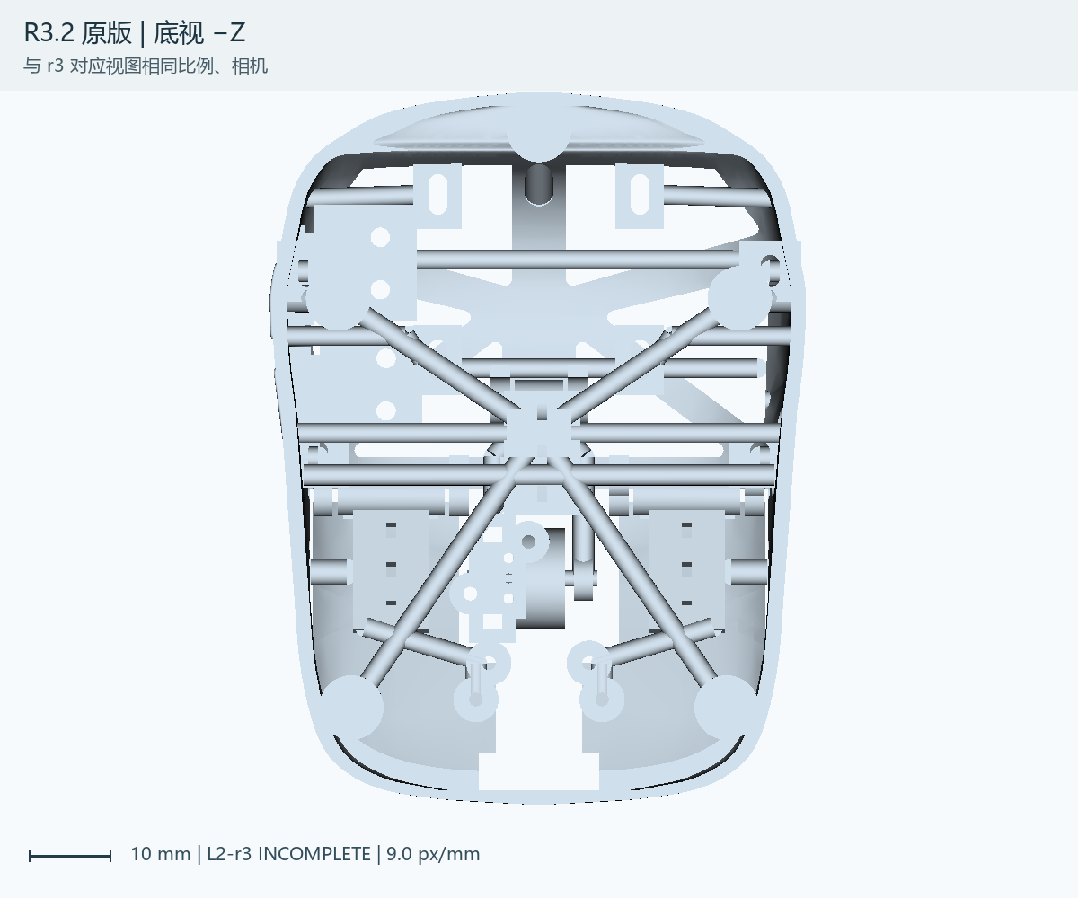
views/l2_r3/R32_BOTTOM.png
