Quietmirror/Quietmirror-L2/views/l2_r3/R32_RIGHT.png

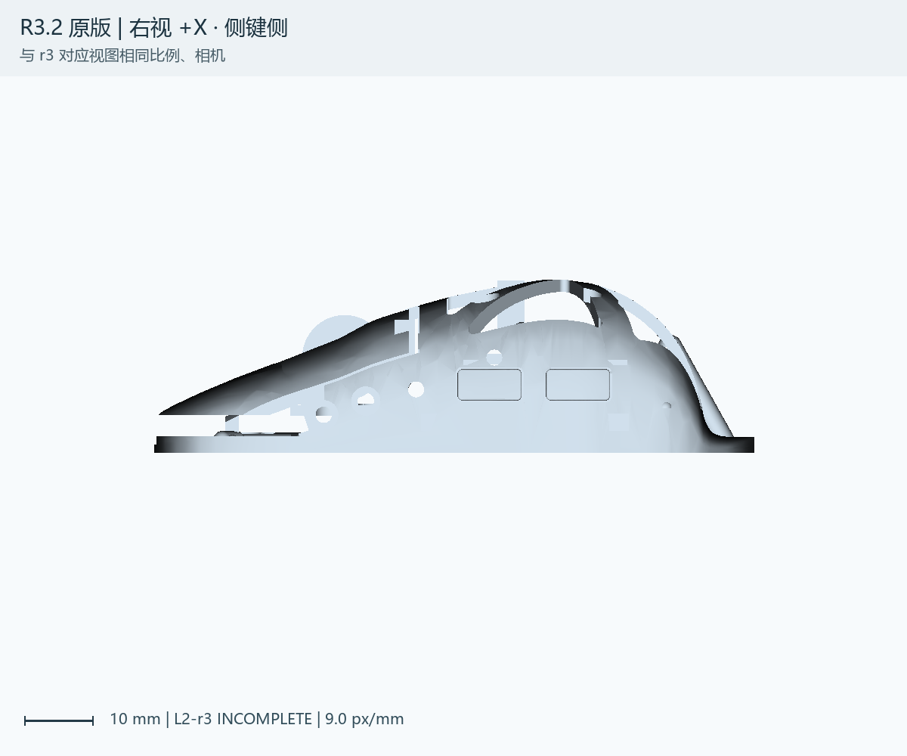
views/l2_r3/R32_RIGHT.png
