Quietmirror/Quietmirror-L2/views/l2_r3/R32_VS_L2_r3.png

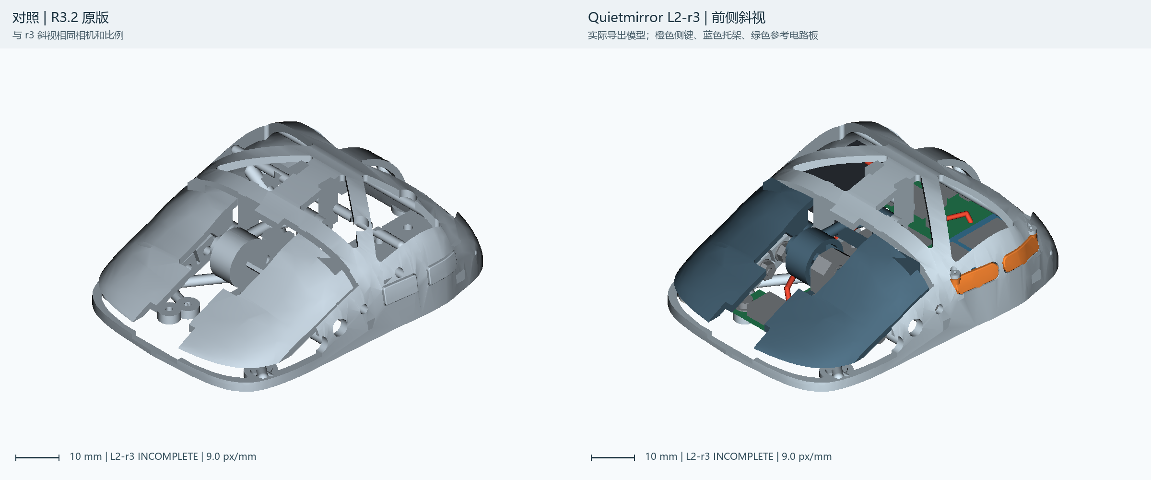
views/l2_r3/R32_VS_L2_r3.png
