Quietmirror/Quietmirror-L2/views/l2_r3/R32_VS_L2_r3_TOP_RIGHT_BOTTOM.png

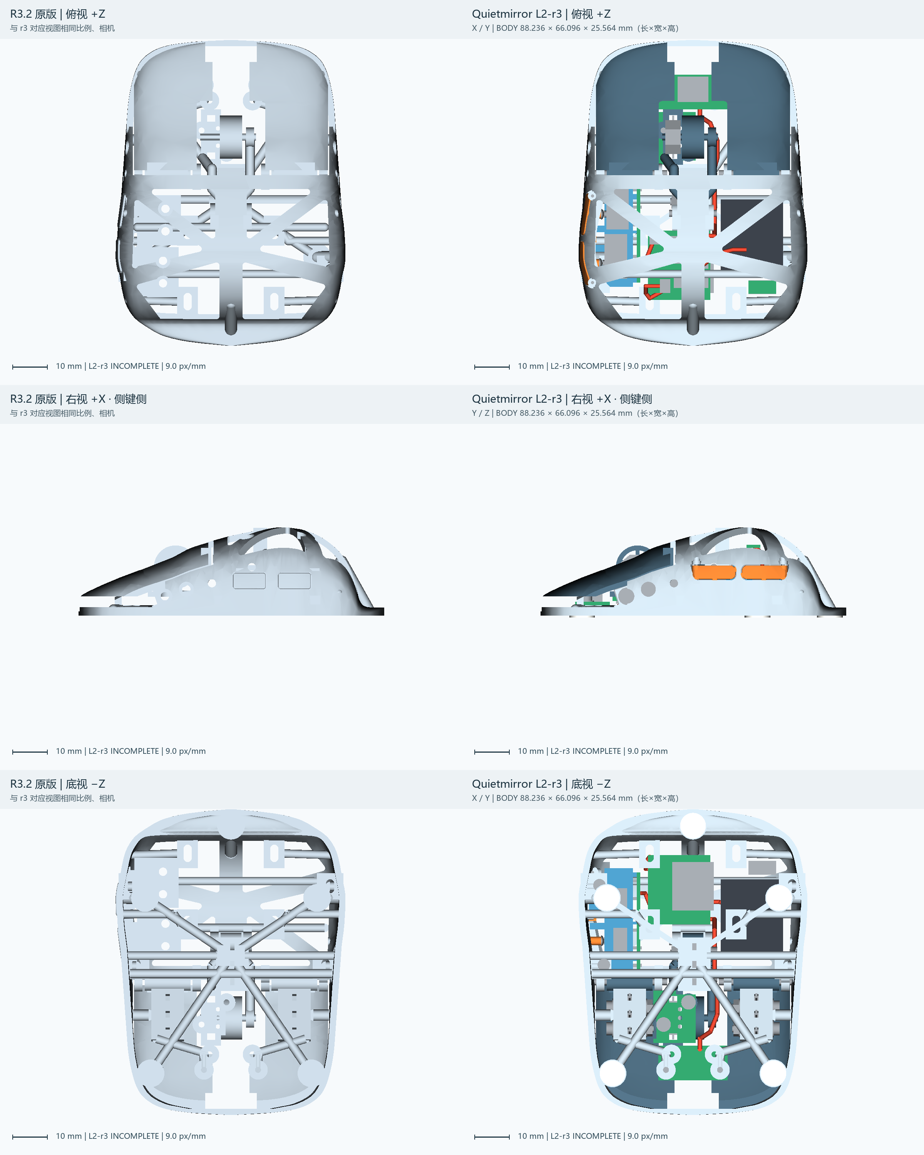
views/l2_r3/R32_VS_L2_r3_TOP_RIGHT_BOTTOM.png
