Quietmirror/Quietmirror-L2/views/l2_r3/SECTION_Y50p25.png

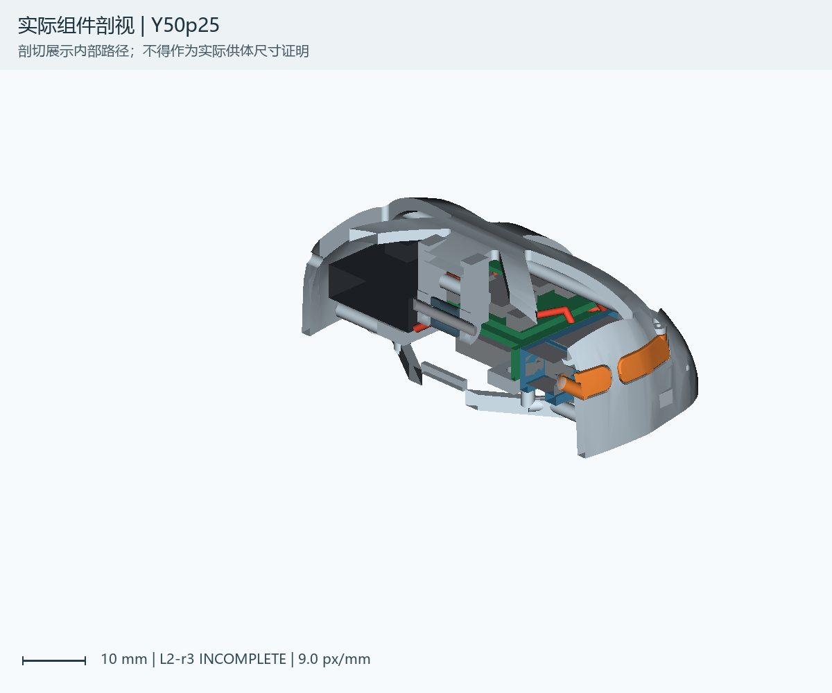
views/l2_r3/SECTION_Y50p25.png
