Quietmirror/Quietmirror-L2/views/l2_r3/SECTION_Z16p6.png

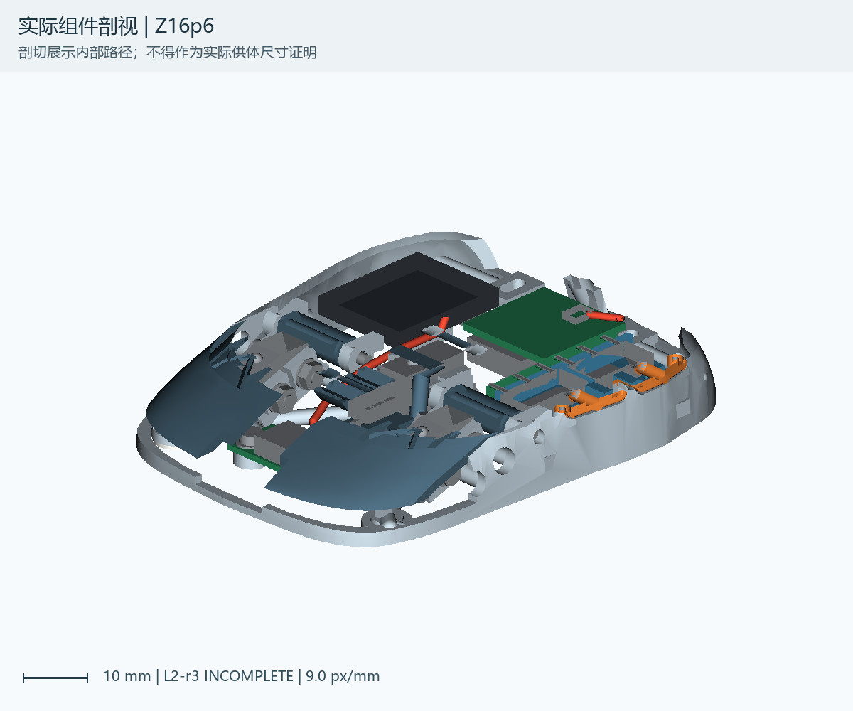
views/l2_r3/SECTION_Z16p6.png
