Quietmirror/Quietmirror-L2/views/l2_r3/SIDE_MOTION_OVERLAY.png

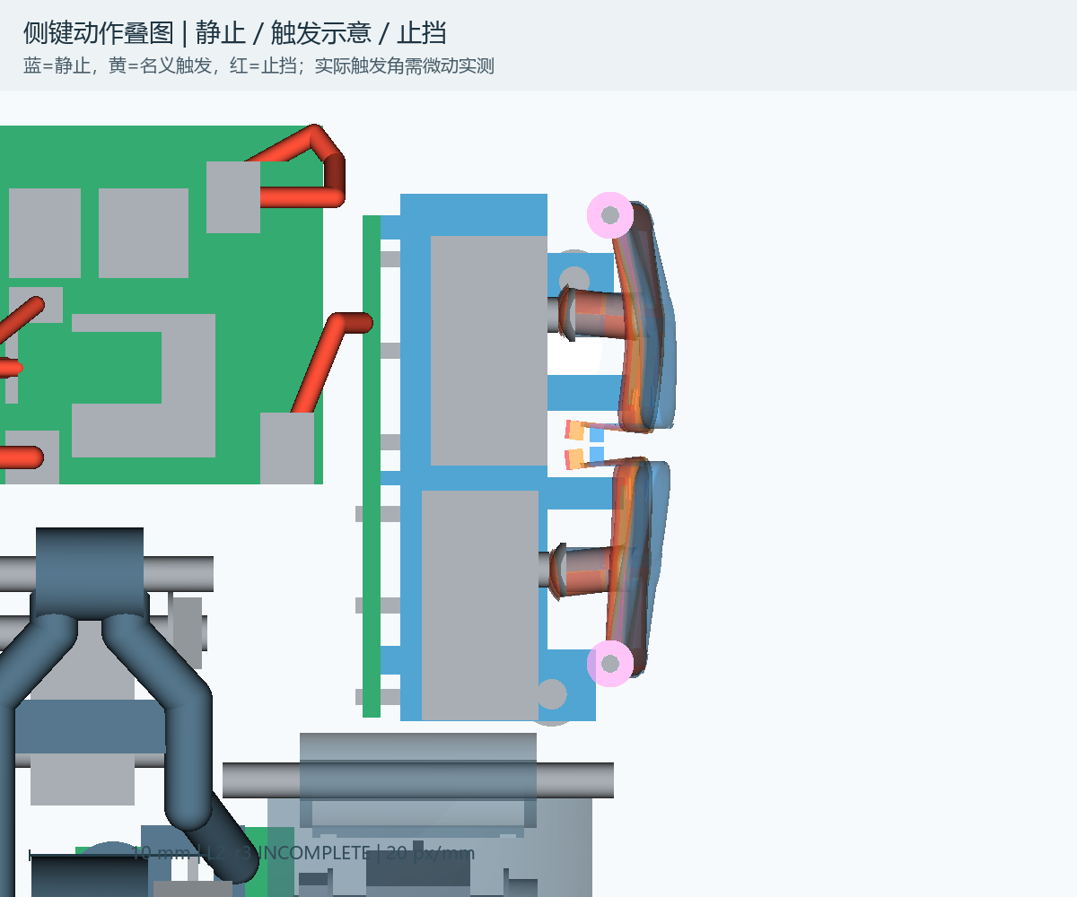
views/l2_r3/SIDE_MOTION_OVERLAY.png
