Quietmirror/Quietmirror-L2/views/l2_r4/H_BACK.png

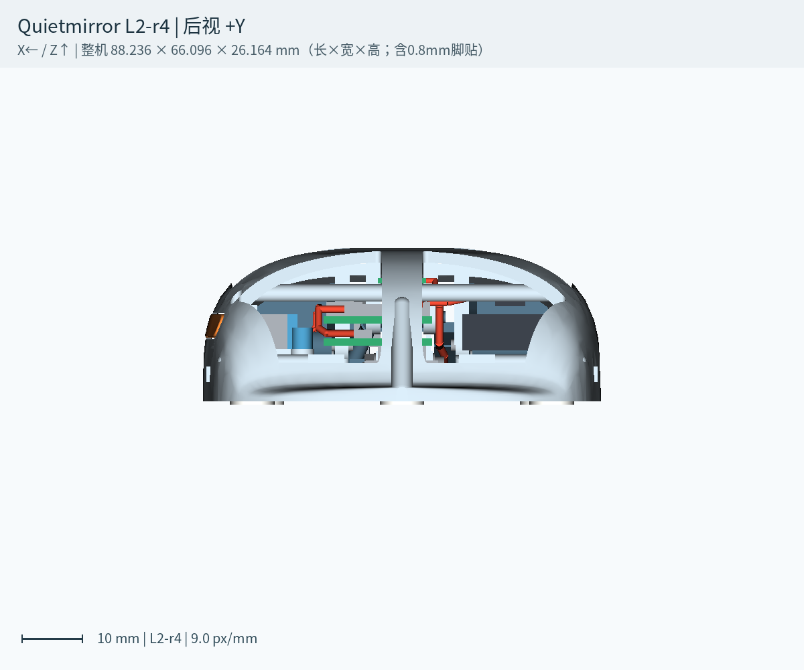
views/l2_r4/H_BACK.png
