Quietmirror/Quietmirror-L2/views/l2_r4/H_BOTTOM.png

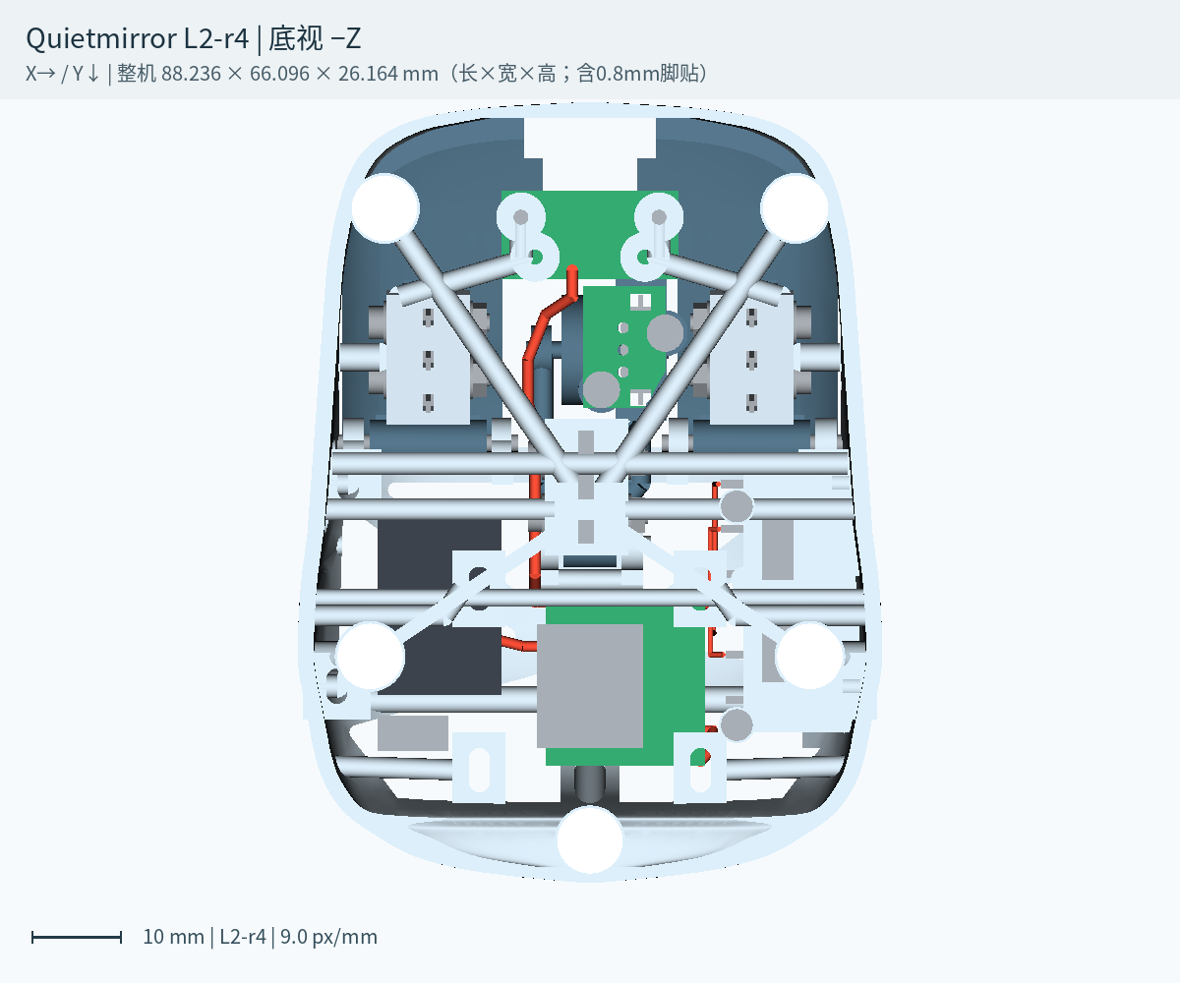
views/l2_r4/H_BOTTOM.png
