Quietmirror/Quietmirror-L2/views/l2_r4/H_ISO_FRONT.png

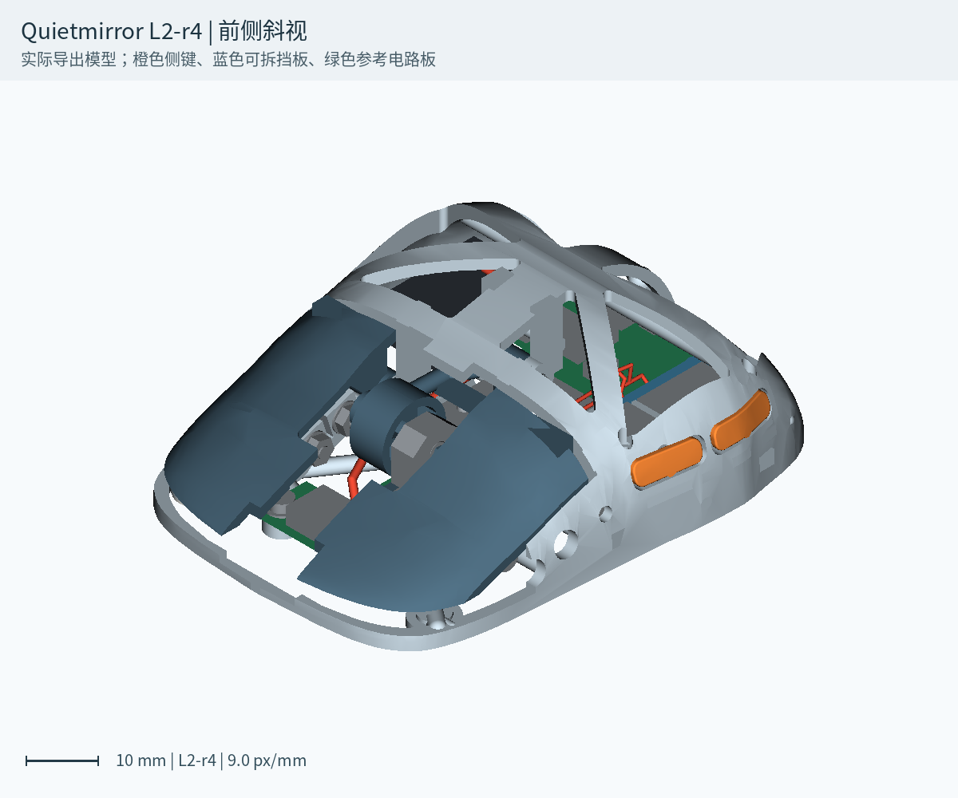
views/l2_r4/H_ISO_FRONT.png
