Quietmirror/Quietmirror-L2/views/l2_r4/INSIDE_TOP.png

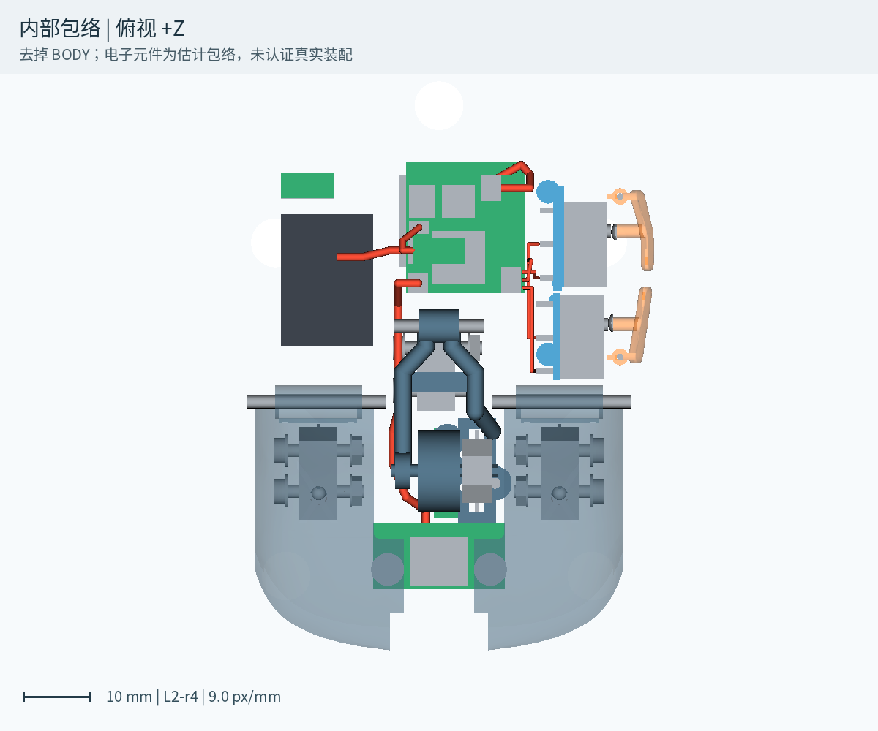
views/l2_r4/INSIDE_TOP.png
