Quietmirror/Quietmirror-L2/views/l2_r4/R3_VS_L2_r4_TOP_RIGHT_BOTTOM.png

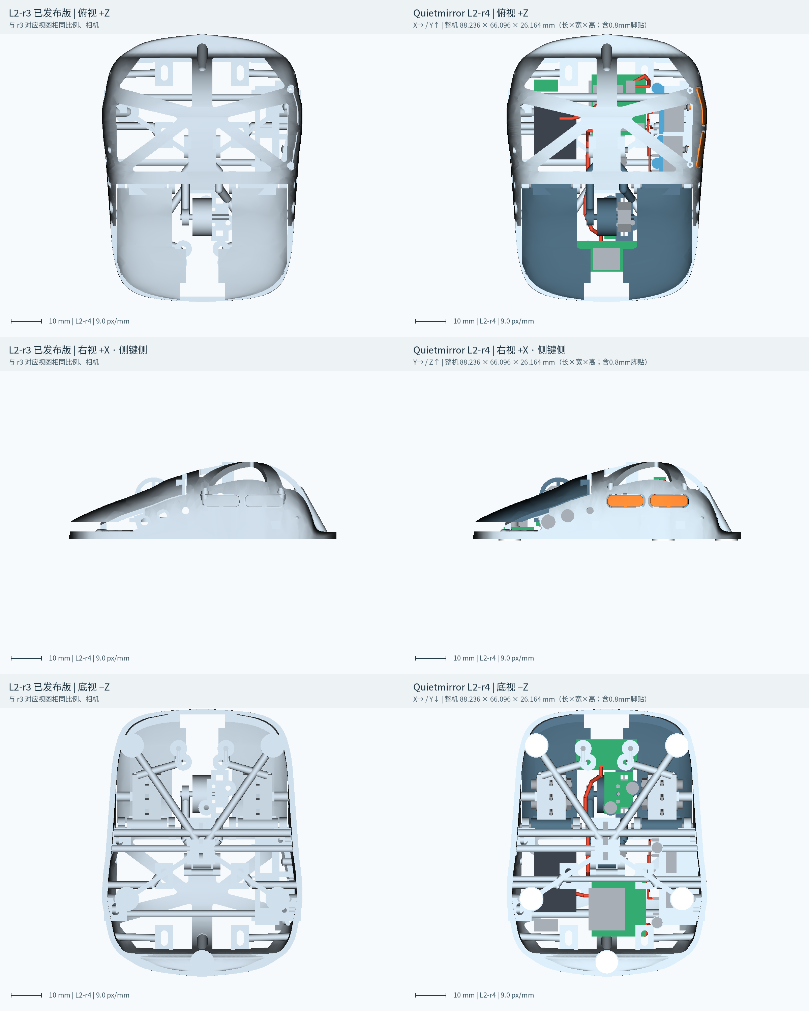
views/l2_r4/R3_VS_L2_r4_TOP_RIGHT_BOTTOM.png
