Quietmirror/Quietmirror-L2/views/l2_r4/SIDE_EXACT_MOTION_CURVES.png

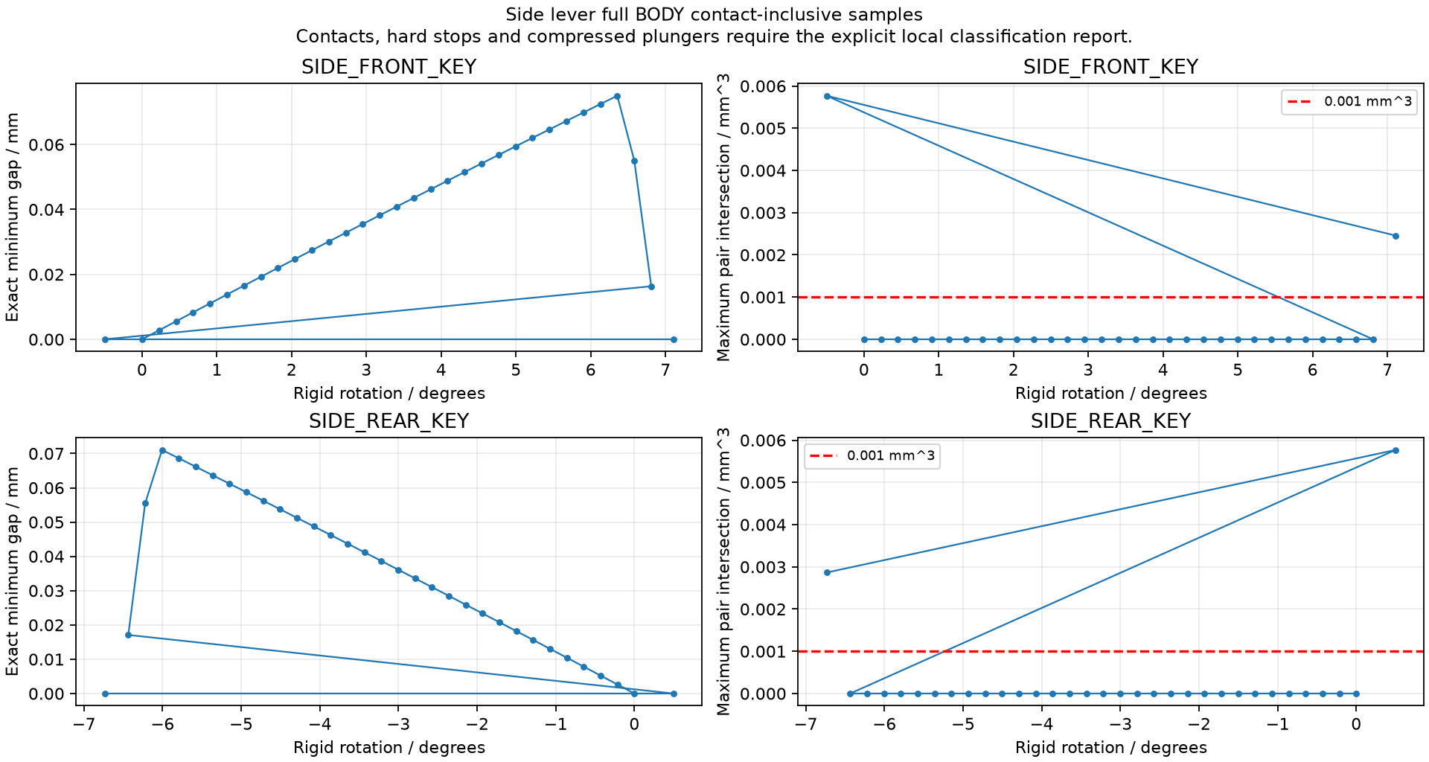
views/l2_r4/SIDE_EXACT_MOTION_CURVES.png
