Quietmirror/Quietmirror-L2/models/L2_r4_3D45_PLA/L2_r4_WHOLE_ASSEMBLED_PRINTABLES.stl

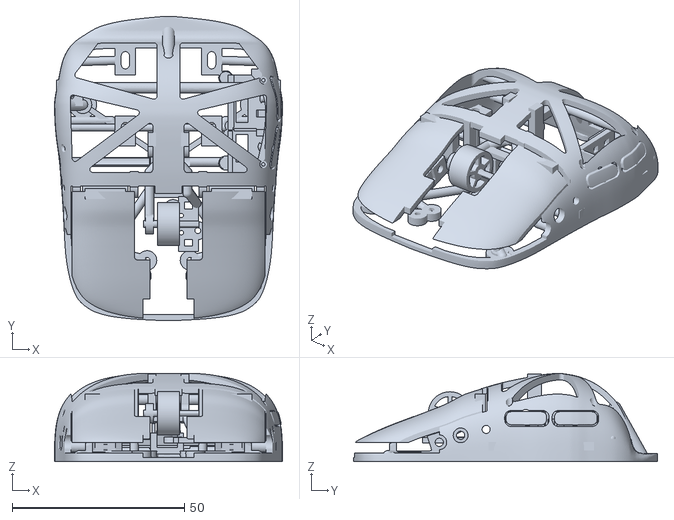
[picture p29: CAD file, 2026-10-20]
models/L2_r4_3D45_PLA/L2_r4_WHOLE_ASSEMBLED_PRINTABLES.stl
66.1 x 88.2 x 25.6
