Quietmirror/Quietmirror-L2/exports/l2_r2_diagnostic/MAIN_OUTER_HINGE_REFERENCE.step

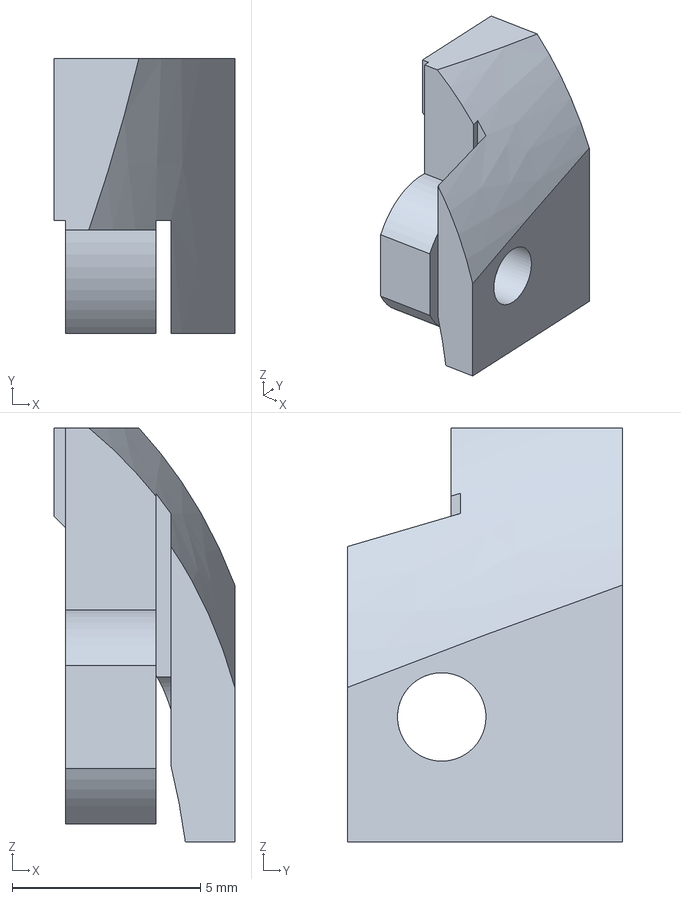
[picture p30: CAD file, 2026-10-18]
exports/l2_r2_diagnostic/MAIN_OUTER_HINGE_REFERENCE.step
4.80 x 7.30 x 11.0 mm
