Quietmirror/Quietmirror-L2/cad/l2_r3_check/R3_SIDE_MODULE_LAYOUT.step

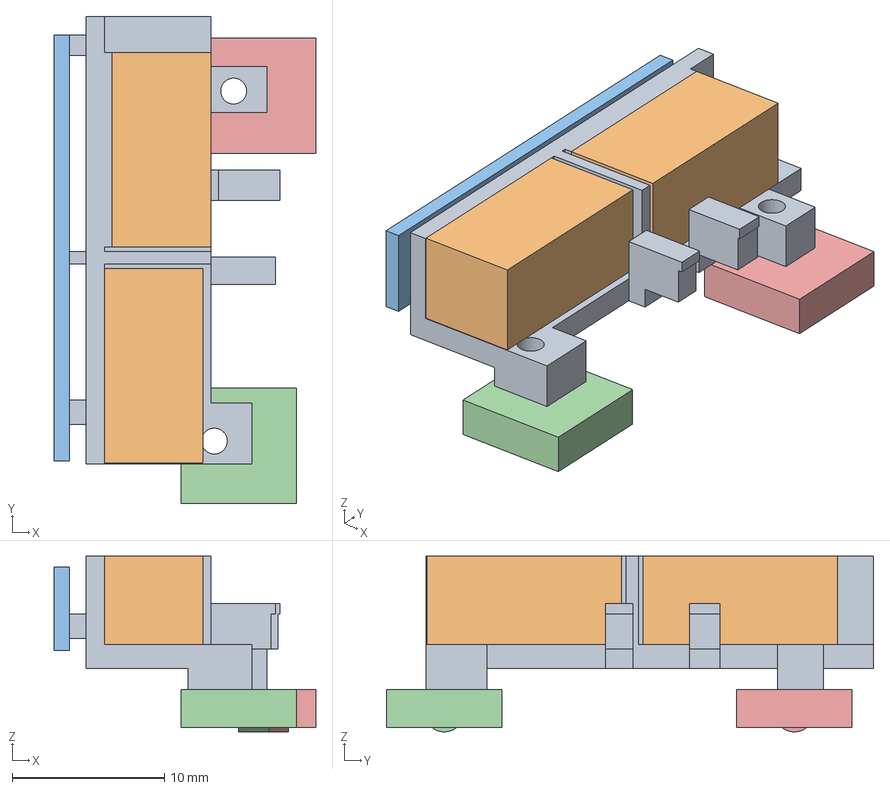
[picture p31: CAD file, 2026-10-20]
cad/l2_r3_check/R3_SIDE_MODULE_LAYOUT.step
17.2 x 32.0 x 11.6 mm
