Quietmirror/Quietmirror-L2/exports/l2_r2_diagnostic/FRONT_EAR_SOURCE_REFERENCE.step

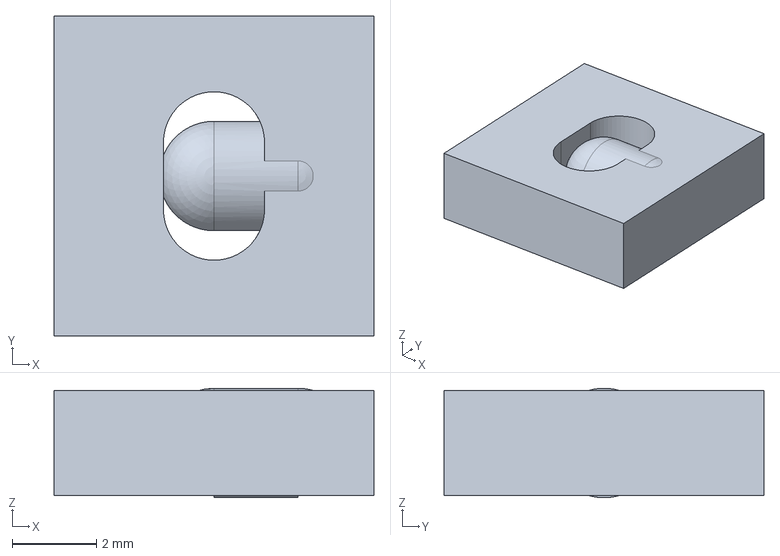
[picture p32: CAD file, 2026-10-18]
exports/l2_r2_diagnostic/FRONT_EAR_SOURCE_REFERENCE.step
7.60 x 7.60 x 2.60 mm
