Quietmirror/Quietmirror-L2/exports/l2_r2_diagnostic/support_reference/MOTHER_INNER_FROM_R32_SURFACE.step

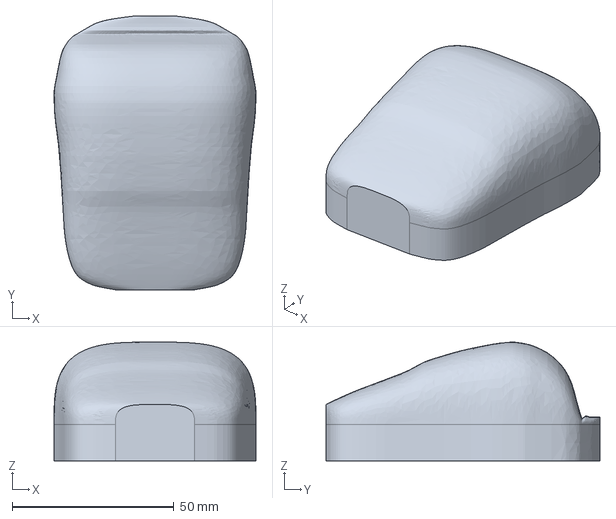
[picture p33: CAD file, 2026-10-18]
exports/l2_r2_diagnostic/support_reference/MOTHER_INNER_FROM_R32_SURFACE.step
62.5 x 84.6 x 36.8 mm
