Quietmirror/Quietmirror-L2/handoff/document_side_layout_UNCORRECTED.step

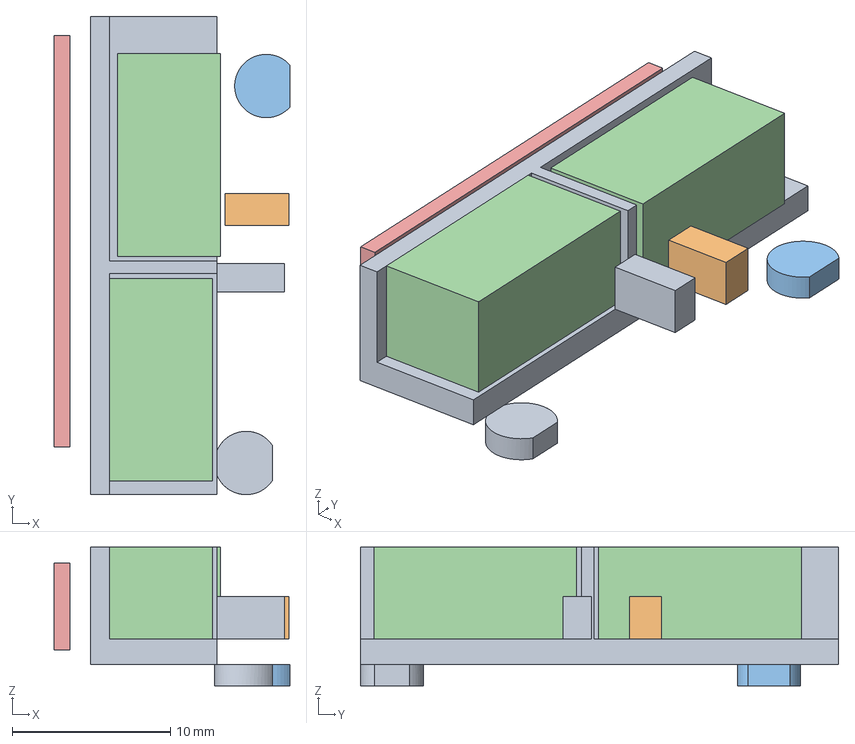
[picture p34: CAD file, 2026-10-18]
handoff/document_side_layout_UNCORRECTED.step
14.9 x 30.2 x 8.75 mm
