Quietmirror/Quietmirror-L2/models/L2_r3/L2_r3_H_ALL_PARTS_SINGLE_PLATE.3mf

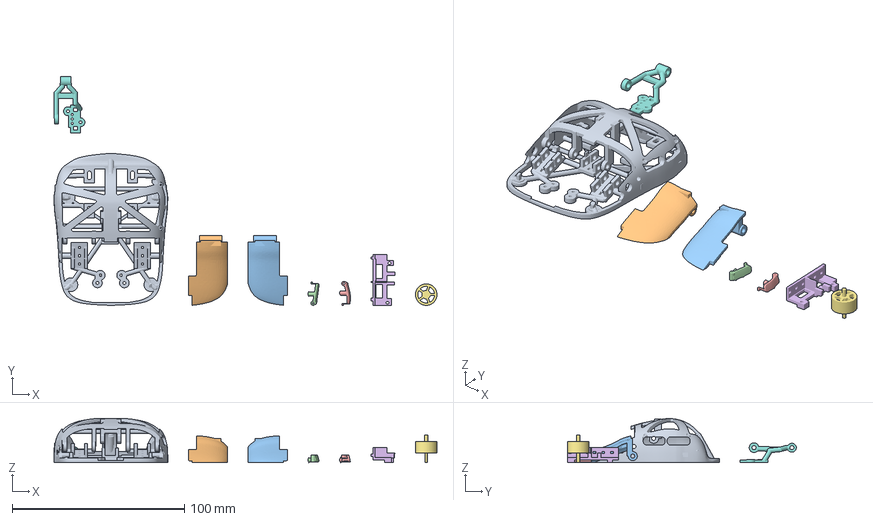
[picture p35: CAD file, 2026-10-19]
models/L2_r3/L2_r3_H_ALL_PARTS_SINGLE_PLATE.3mf
222.4 x 132.8 x 25.6 mm
LEFT_KEY
RIGHT_KEY
SIDE_FRONT_KEY
SIDE_REAR_KEY
SIDE_SWITCH_CARRIER
WHEEL
WHEEL_CARRIER
