Quietmirror/Quietmirror-L2/models/L2_r4/parts/WHEEL.stl

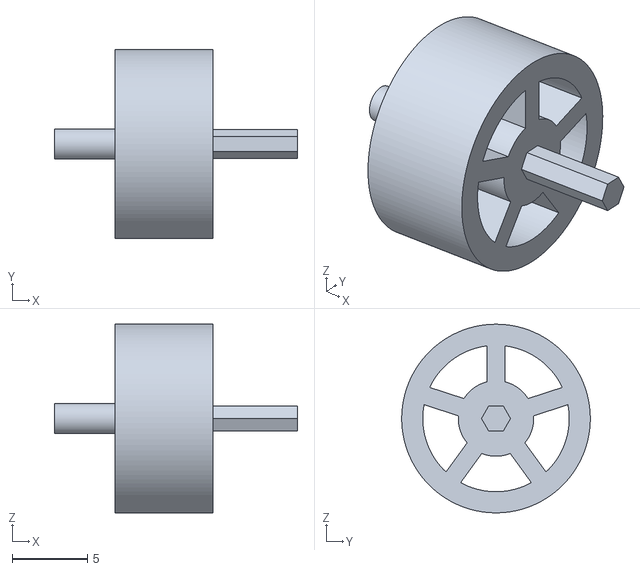
[picture p36: CAD file, 2026-10-20]
models/L2_r4/parts/WHEEL.stl
16.1 x 12.5 x 12.5
