Quietmirror/Quietmirror-L2/models/L2_r4/reference/ANTENNA_FEED_HEADER_EST.step

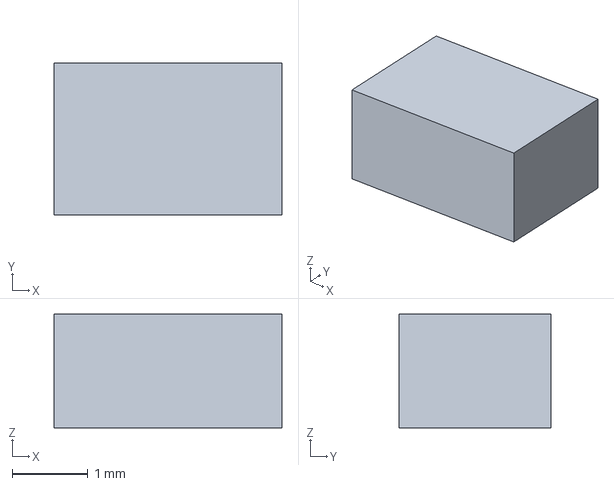
[picture p37: CAD file, 2026-10-20]
models/L2_r4/reference/ANTENNA_FEED_HEADER_EST.step
3.00 x 2.00 x 1.50 mm
