Quietmirror/Quietmirror-L2/models/L2_r4/validation_features/SWITCH_MIDDLE_MOUNT.step

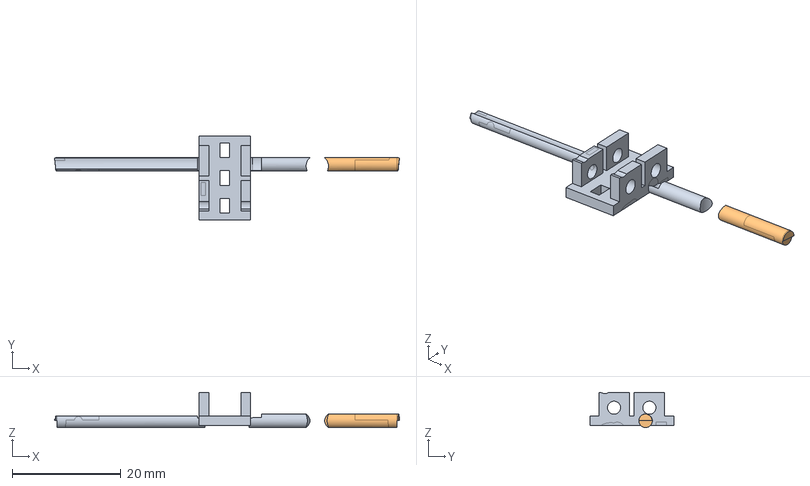
[picture p38: CAD file, 2026-10-20]
models/L2_r4/validation_features/SWITCH_MIDDLE_MOUNT.step
63.4 x 15.5 x 6.45 mm
