Quietmirror/Quietmirror-L2/models/L2_r4_3D45_PLA/L2_r4_3D45_PLA_PLATE.3mf

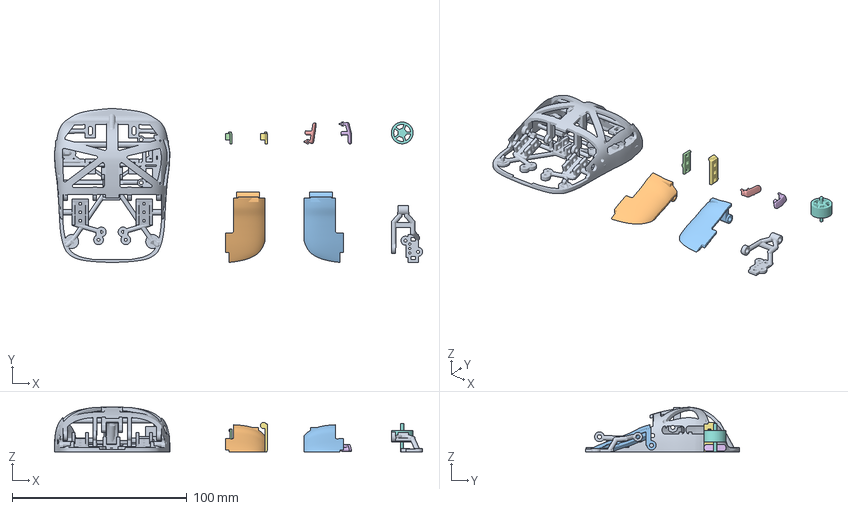
[picture p39: CAD file, 2026-10-20]
models/L2_r4_3D45_PLA/L2_r4_3D45_PLA_PLATE.3mf
210.9 x 88.2 x 25.6 mm
LEFT_KEY
RIGHT_KEY
SF_RETAINER
SIDE_FRONT_KEY
SIDE_REAR_KEY
SR_RETAINER
WHEEL
WHEEL_CARRIER
