Quietmirror/Quietmirror-L2/cad/l2_r3_check/R3_SIDE_SWITCH_CARRIER.step

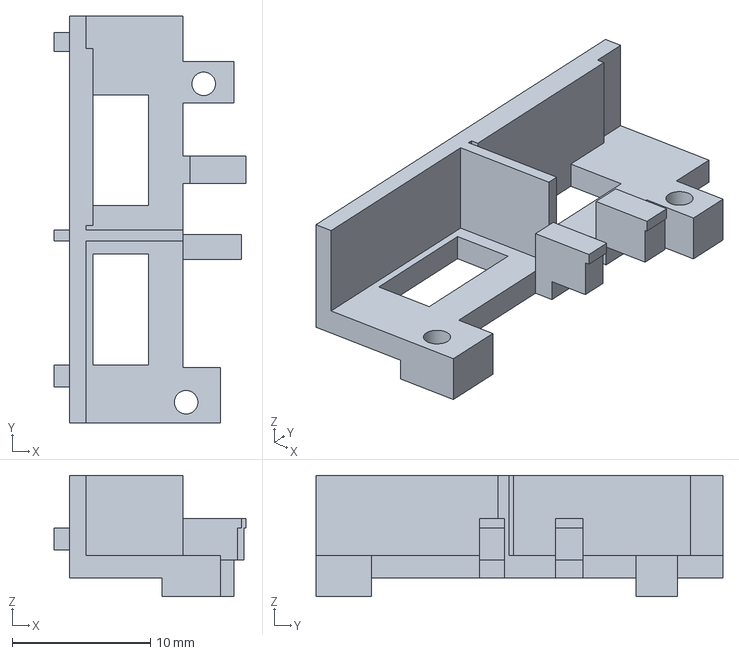
[picture p41: CAD file, 2026-10-20]
cad/l2_r3_check/R3_SIDE_SWITCH_CARRIER.step
13.8 x 29.4 x 8.75 mm
