Quietmirror/Quietmirror-L2/exports/l2_r2_diagnostic/SR_SWITCH_ENVELOPE.step

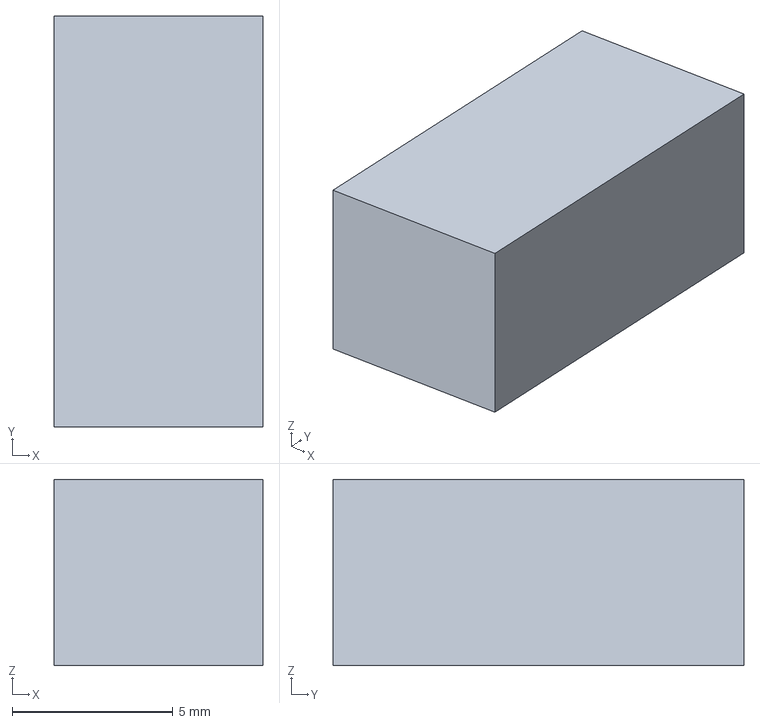
[picture p42: CAD file, 2026-10-18]
exports/l2_r2_diagnostic/SR_SWITCH_ENVELOPE.step
6.50 x 12.8 x 5.80 mm
