Quietmirror/Quietmirror-L2/exports/l2_r2_diagnostic/support_reference/MOTHER_OUTER_FROM_R32_SURFACE.step

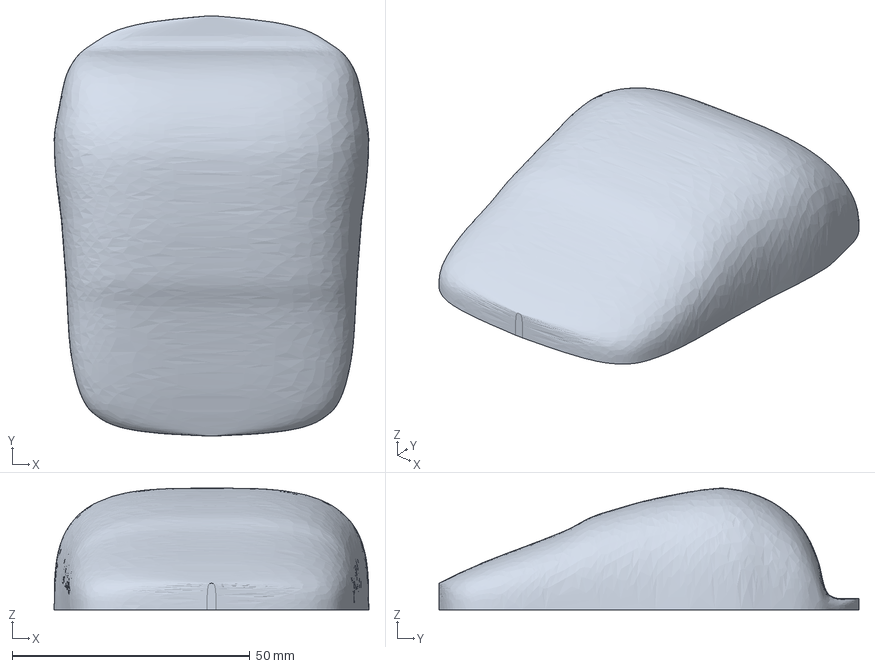
[picture p43: CAD file, 2026-10-18]
exports/l2_r2_diagnostic/support_reference/MOTHER_OUTER_FROM_R32_SURFACE.step
66.1 x 88.2 x 25.6 mm
