Quietmirror/Quietmirror-L2/models/L2_r3/parts/SIDE_FRONT_KEY.step

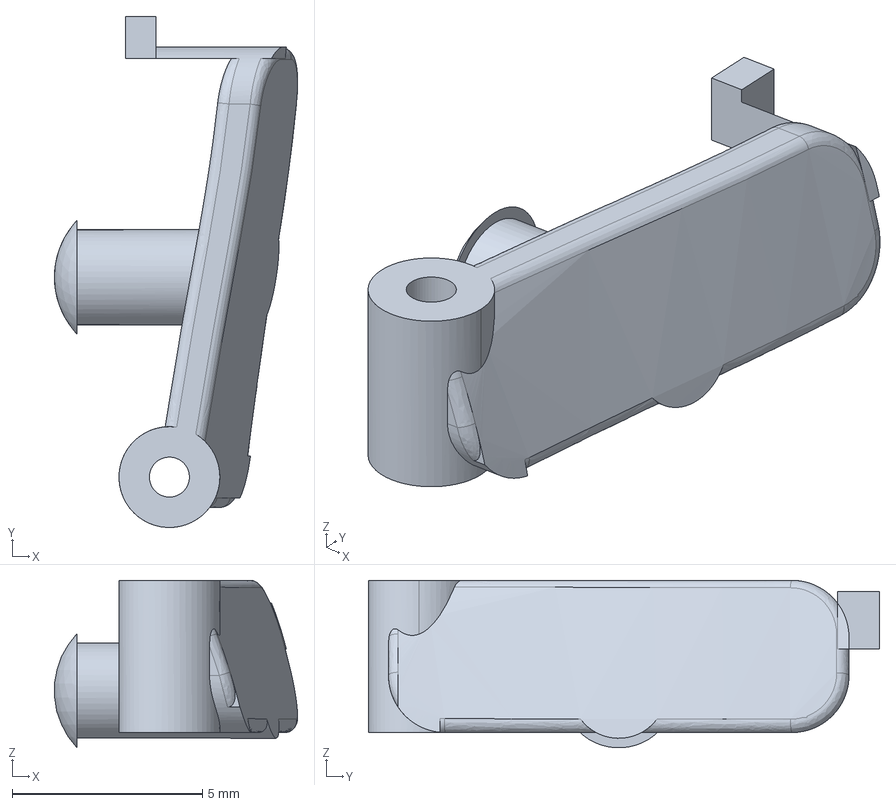
[picture p44: CAD file, 2026-10-19]
models/L2_r3/parts/SIDE_FRONT_KEY.step
6.39 x 13.4 x 4.40 mm
