Quietmirror/Quietmirror-L2/models/L2_r4/parts/LEFT_KEY.stl

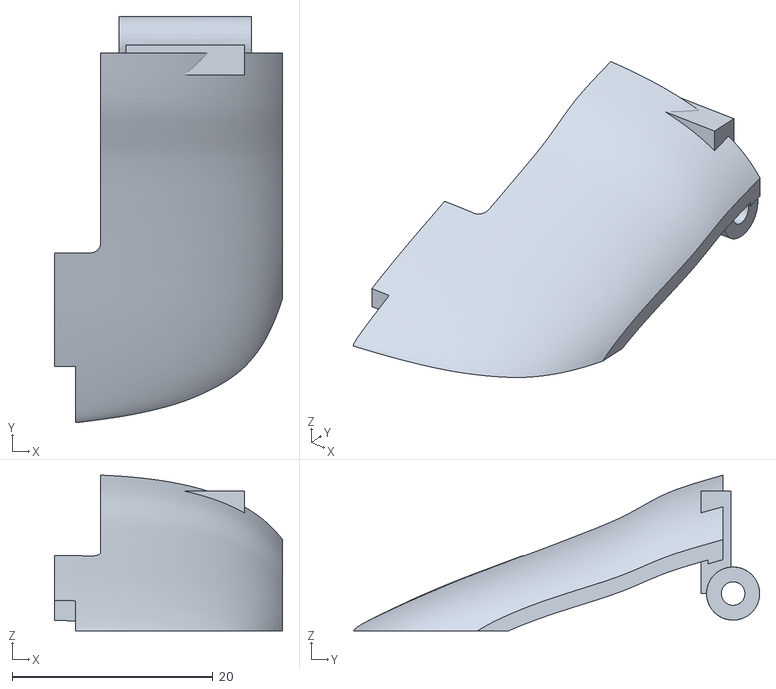
[picture p45: CAD file, 2026-10-20]
models/L2_r4/parts/LEFT_KEY.stl
22.7 x 40.5 x 15.5
