Quietmirror/Quietmirror-L2/models/L2_r4/SIDE_MODULE_F2_TRIAL.3mf

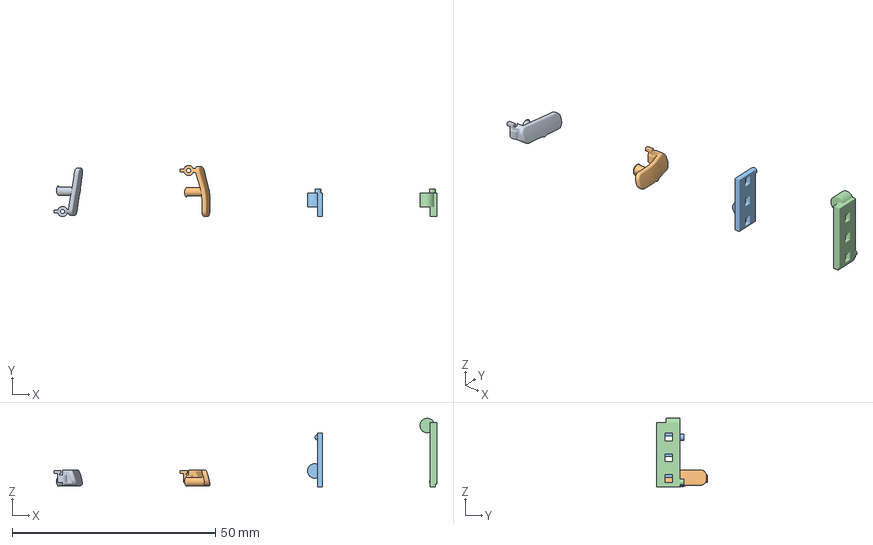
[picture p46: CAD file, 2026-10-20]
models/L2_r4/SIDE_MODULE_F2_TRIAL.3mf
94.3 x 12.6 x 16.9 mm
SIDE_FRONT_KEY_F2_TRIAL
SIDE_REAR_KEY_F2_TRIAL
SF_RETAINER
SR_RETAINER
