Quietmirror/Quietmirror-L2/exports/l2_r2_diagnostic/R2_CARRIER_DIAGNOSTIC.step

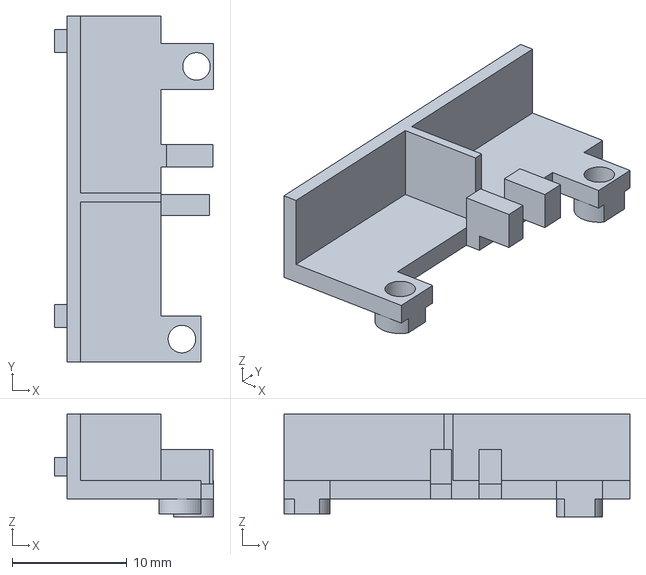
[picture p47: CAD file, 2026-10-18]
exports/l2_r2_diagnostic/R2_CARRIER_DIAGNOSTIC.step
13.9 x 30.2 x 8.97 mm
