Quietmirror/Quietmirror-L2/models/L2_r3/reference/SENSOR_PCB_EST.step

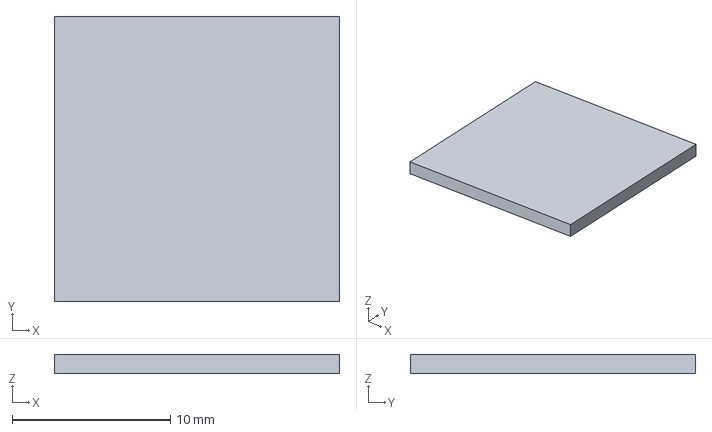
[picture p48: CAD file, 2026-10-19]
models/L2_r3/reference/SENSOR_PCB_EST.step
18.0 x 18.0 x 1.20 mm
