Quietmirror/Quietmirror-L2/models/L2_r4/parts/WHEEL_CARRIER.step

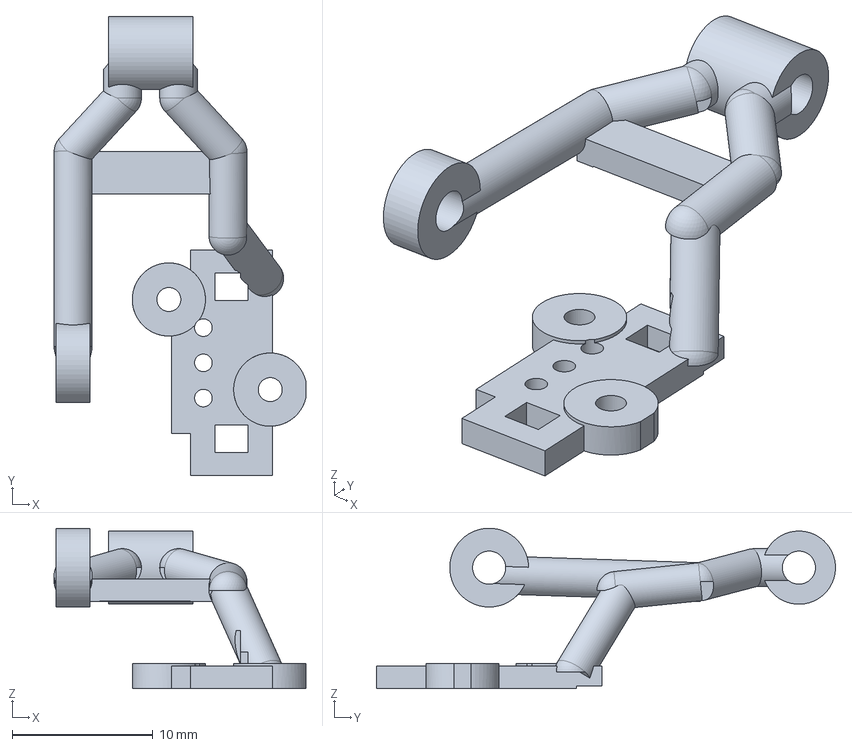
[picture p49: CAD file, 2026-10-20]
models/L2_r4/parts/WHEEL_CARRIER.step
17.9 x 32.6 x 11.4 mm
