Quietmirror/Quietmirror-L2/exports/l2_r2_diagnostic/REAR_FOOT_STRUT_REFERENCE.step

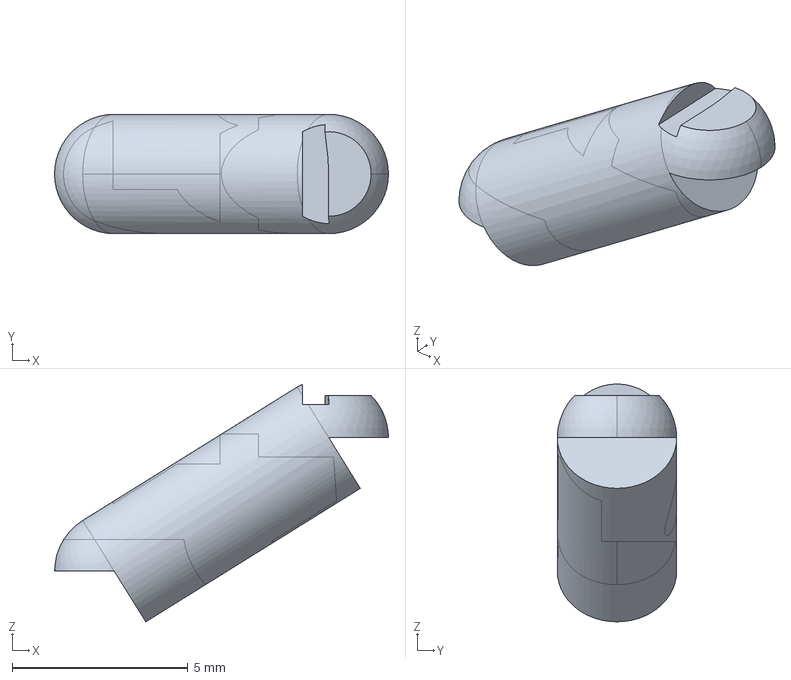
[picture p50: CAD file, 2026-10-18]
exports/l2_r2_diagnostic/REAR_FOOT_STRUT_REFERENCE.step
9.51 x 3.40 x 6.77 mm
