Quietmirror/Quietmirror-L2/models/L2_r3/reference/ATK_A1_PLUS_UNMEASURED_DIAGNOSTIC.step

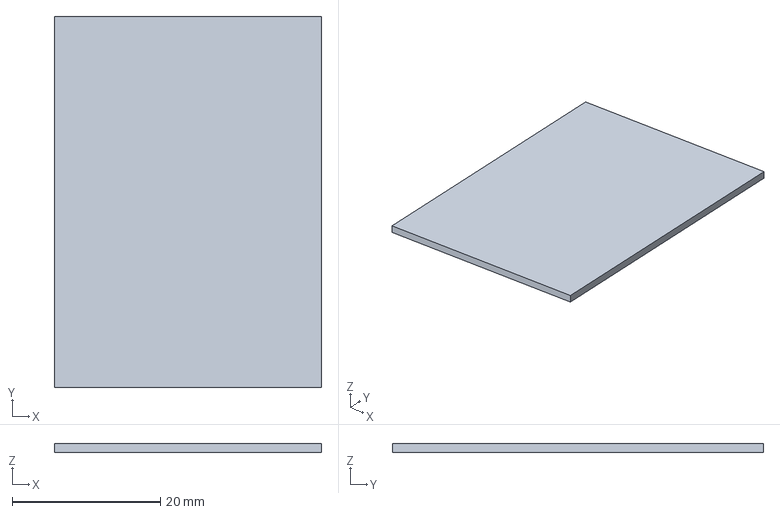
[picture p51: CAD file, 2026-10-19]
models/L2_r3/reference/ATK_A1_PLUS_UNMEASURED_DIAGNOSTIC.step
36.0 x 50.0 x 1.20 mm
