Quietmirror/Quietmirror-L2/models/L2_r4/parts/SF_RETAINER.step

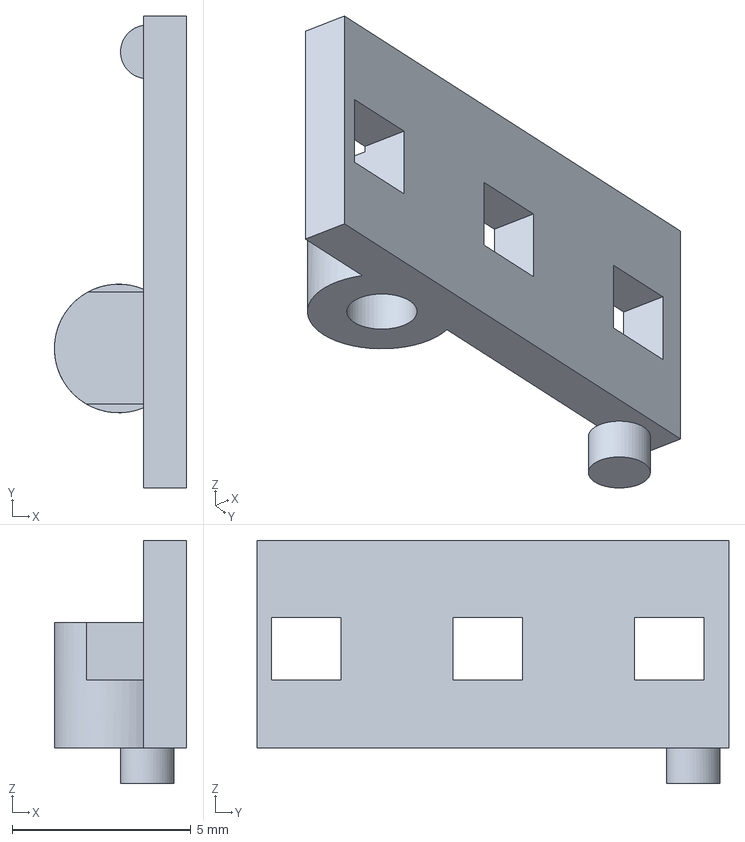
[picture p52: CAD file, 2026-10-20]
models/L2_r4/parts/SF_RETAINER.step
3.70 x 13.2 x 6.80 mm
