Quietmirror/Quietmirror-L2/models/L2_r4/reference/SENSOR_ROUTE_EST.step

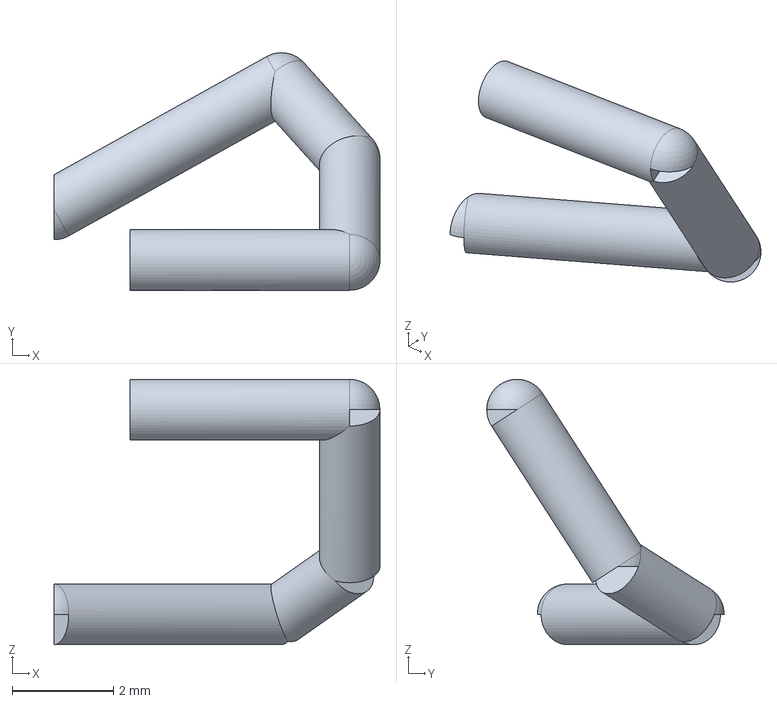
[picture p53: CAD file, 2026-10-20]
models/L2_r4/reference/SENSOR_ROUTE_EST.step
6.45 x 4.70 x 5.25 mm
