Quietmirror/Quietmirror-L2/exports/l2_r2_diagnostic/LOW_MOTHER_SKIN_REFERENCE.step

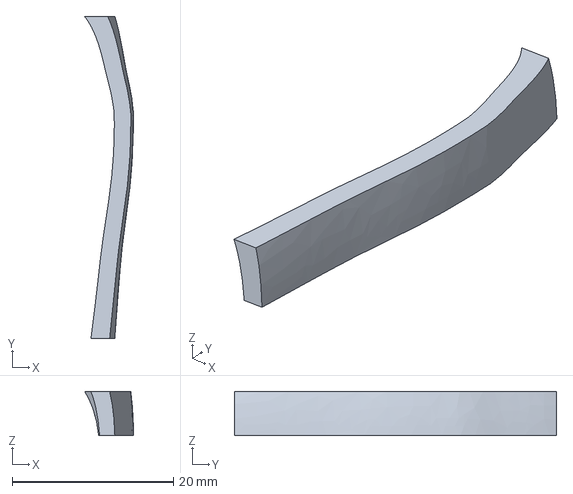
[picture p54: CAD file, 2026-10-18]
exports/l2_r2_diagnostic/LOW_MOTHER_SKIN_REFERENCE.step
6.08 x 40.0 x 5.50 mm
