Quietmirror/Quietmirror-L2/models/L2_r4/parts/SIDE_FRONT_KEY.stl

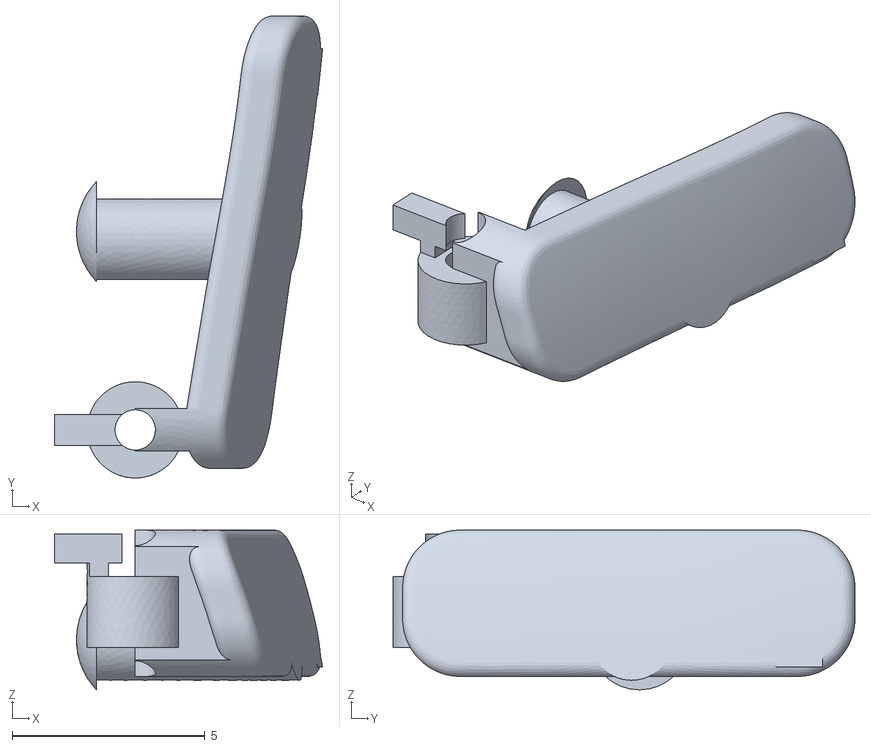
[picture p55: CAD file, 2026-10-20]
models/L2_r4/parts/SIDE_FRONT_KEY.stl
6.97 x 12.0 x 4.15
