Quietmirror/Quietmirror-L2/models/L2_r4/reference/LEFT_KEY_STEEL_PIN.step

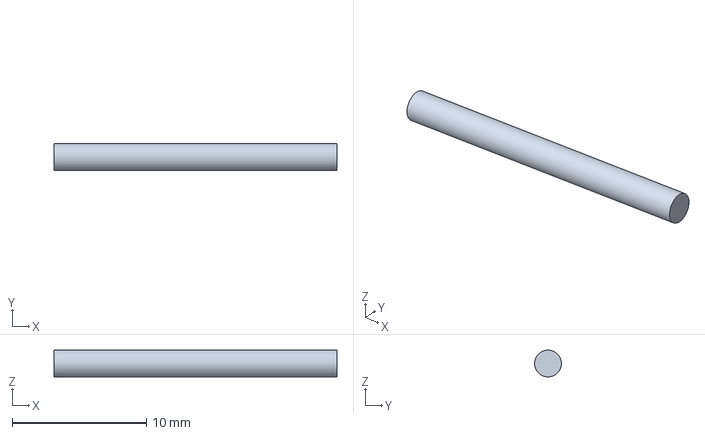
[picture p56: CAD file, 2026-10-20]
models/L2_r4/reference/LEFT_KEY_STEEL_PIN.step
21.1 x 2.00 x 2.00 mm
