Quietmirror/Quietmirror-L2/exports/l2_r2_diagnostic/R2_SIDE_LAYOUT_DIAGNOSTIC.step

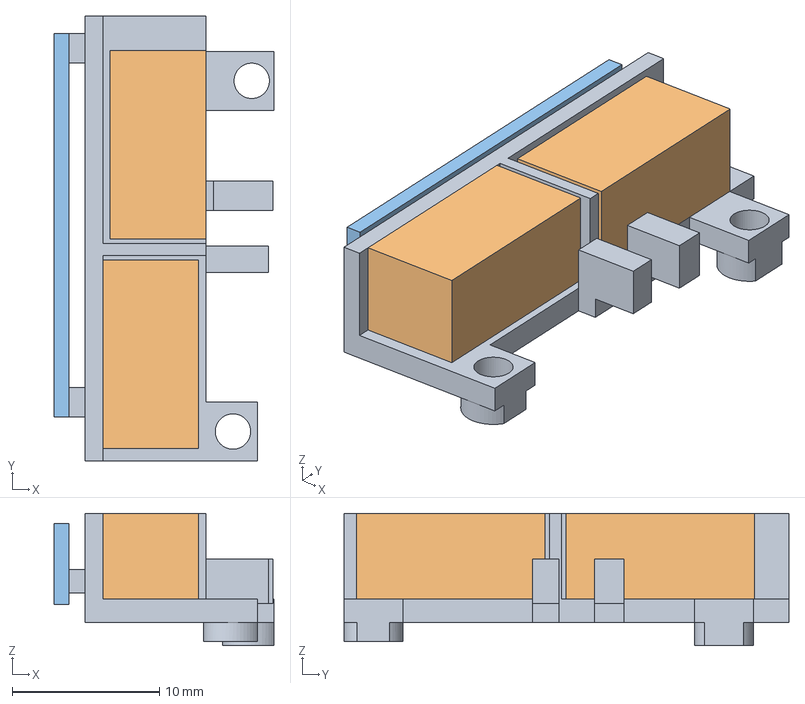
[picture p57: CAD file, 2026-10-18]
exports/l2_r2_diagnostic/R2_SIDE_LAYOUT_DIAGNOSTIC.step
14.9 x 30.2 x 8.97 mm
