Quietmirror/Quietmirror-L2/models/L2_r3/reference/SIDE_REAR_KEY_F2_TRIAL.step

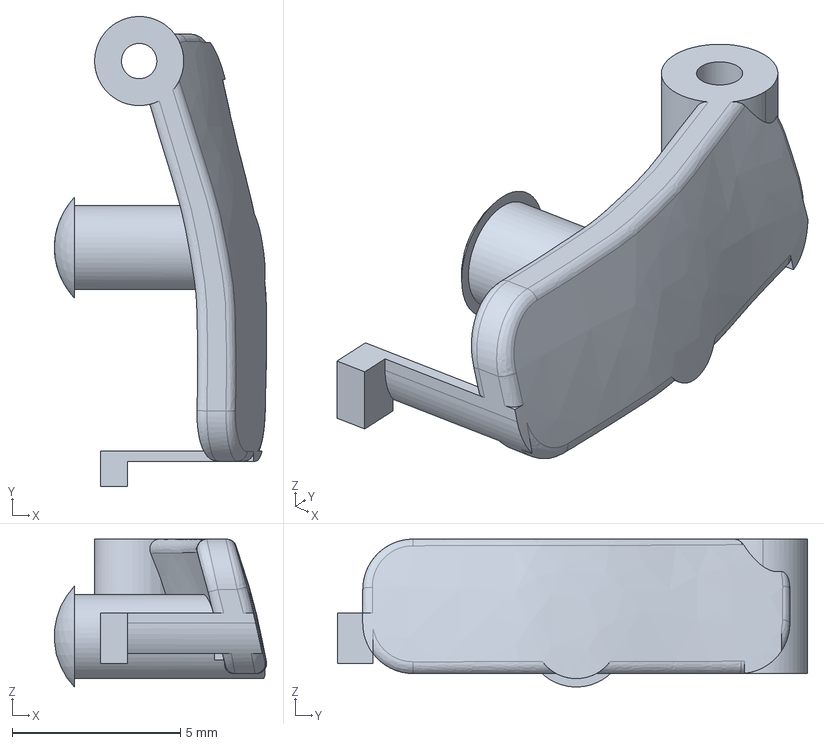
[picture p58: CAD file, 2026-10-19]
models/L2_r3/reference/SIDE_REAR_KEY_F2_TRIAL.step
6.31 x 14.0 x 4.40 mm
