Quietmirror/Quietmirror-L2/models/L2_r4/parts/BODY.stl

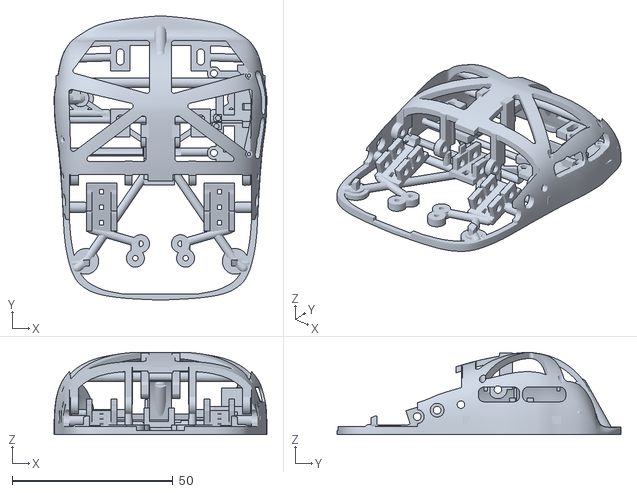
[picture p59: CAD file, 2026-10-20]
models/L2_r4/parts/BODY.stl
66.1 x 88.2 x 25.6
