Quietmirror/Quietmirror-L2/models/L2_r3/reference/SENSOR_ROUTE_EST.step

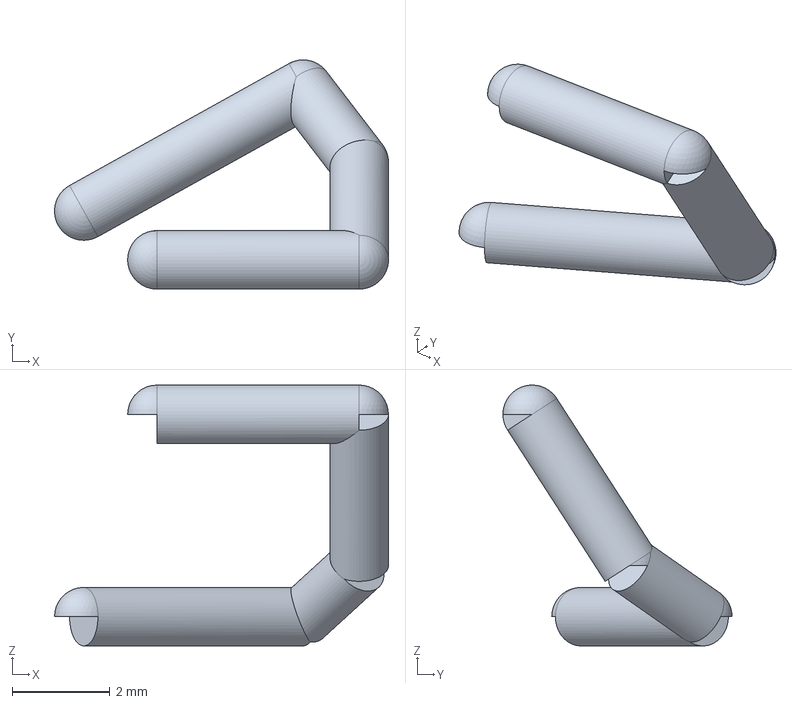
[picture p60: CAD file, 2026-10-19]
models/L2_r3/reference/SENSOR_ROUTE_EST.step
6.85 x 4.70 x 5.35 mm
