Quietmirror/Quietmirror-L2/models/L2_r4/parts/SIDE_REAR_KEY.step

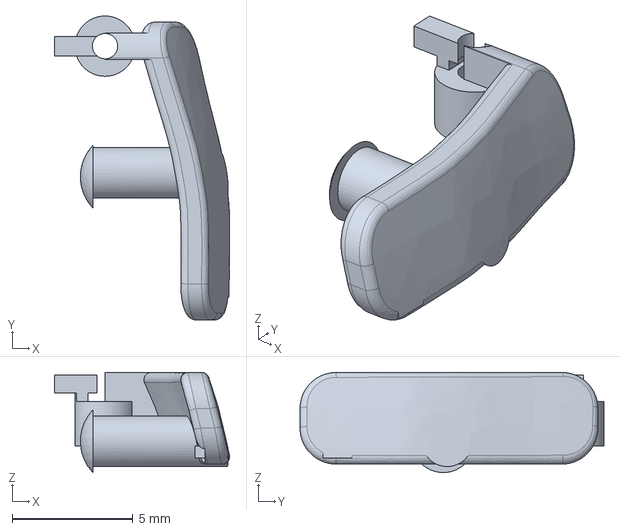
[picture p61: CAD file, 2026-10-20]
models/L2_r4/parts/SIDE_REAR_KEY.step
7.26 x 12.6 x 4.15 mm
