Quietmirror/Quietmirror-L2/models/L2_r4/reference/BATTERY_ROUTE_EST.step

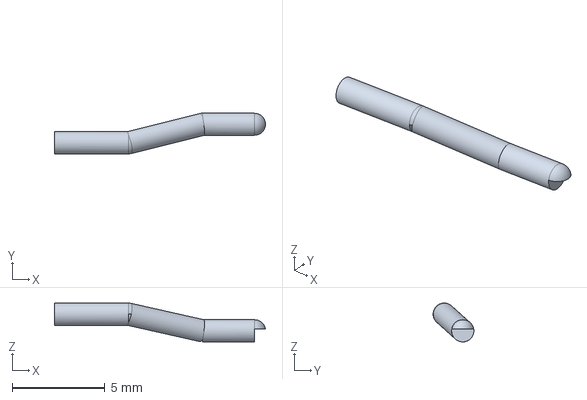
[picture p62: CAD file, 2026-10-20]
models/L2_r4/reference/BATTERY_ROUTE_EST.step
11.4 x 2.20 x 2.10 mm
