Quietmirror/Quietmirror-L2/exports/l2_r2_diagnostic/R2_COLLISION_REGIONS.step

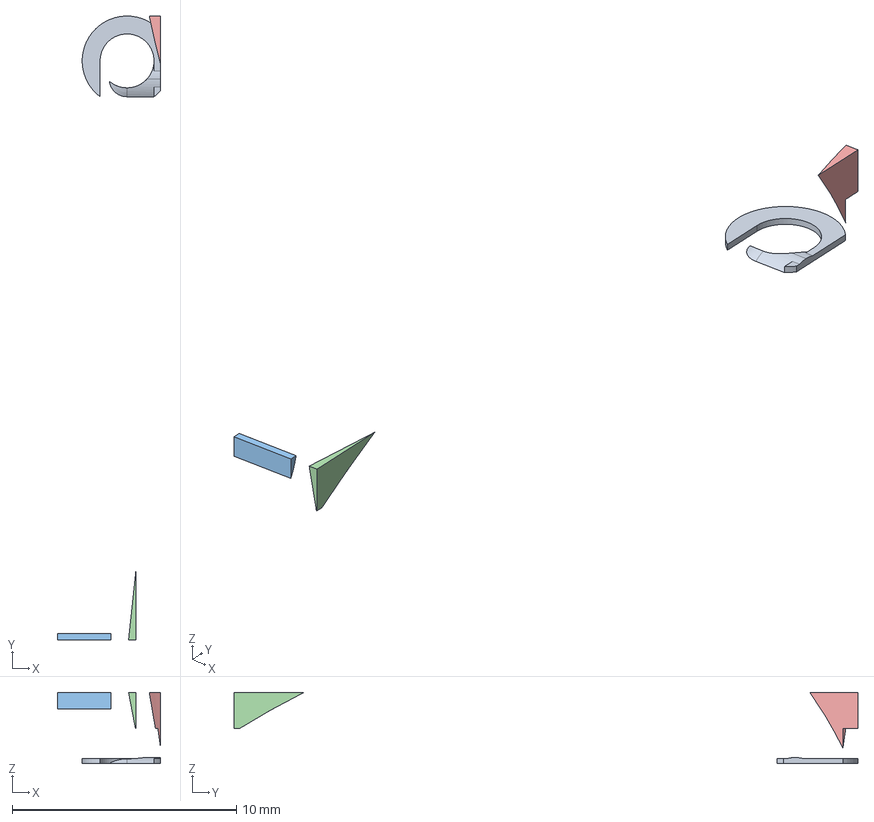
[picture p63: CAD file, 2026-10-18]
exports/l2_r2_diagnostic/R2_COLLISION_REGIONS.step
4.60 x 27.8 x 3.18 mm
