Quietmirror/Quietmirror-L2/models/L2_r4/parts/SR_RETAINER.step

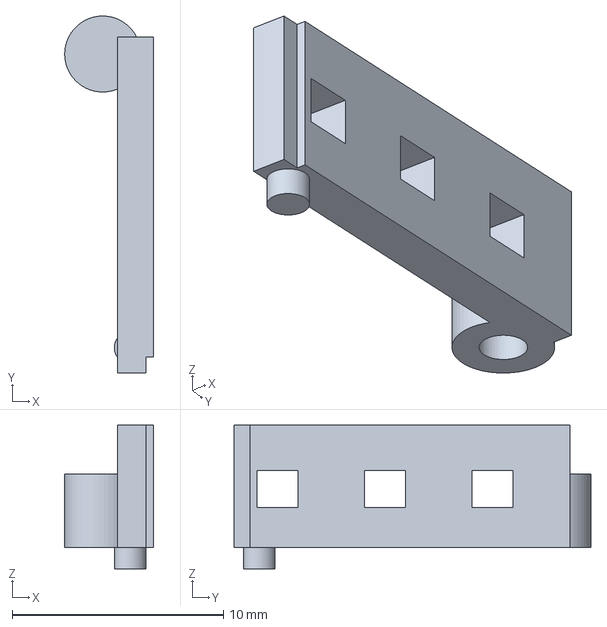
[picture p64: CAD file, 2026-10-20]
models/L2_r4/parts/SR_RETAINER.step
4.20 x 16.9 x 6.80 mm
