Quietmirror/Quietmirror-L2/models/L2_r4/reference/SF_VERTICAL_PIN.step

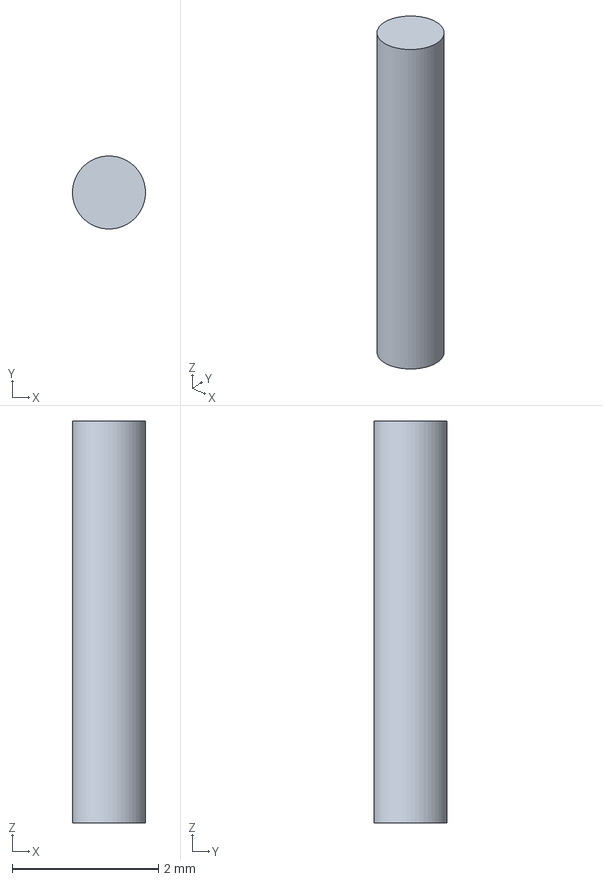
[picture p65: CAD file, 2026-10-20]
models/L2_r4/reference/SF_VERTICAL_PIN.step
0.999 x 1 x 5.50 mm
