Quietmirror/Quietmirror-L2/exports/l2_r2_diagnostic/SIDE_IO_PCB_ENVELOPE.step

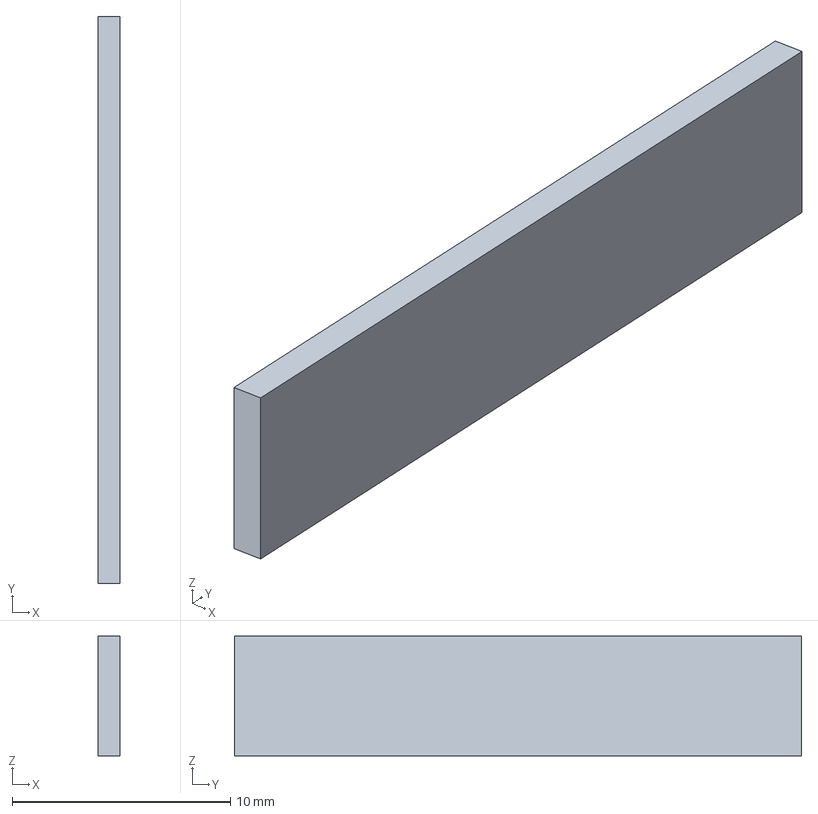
[picture p66: CAD file, 2026-10-18]
exports/l2_r2_diagnostic/SIDE_IO_PCB_ENVELOPE.step
1.00 x 26.0 x 5.50 mm
