Quietmirror/Quietmirror-L2/models/L2_r3/reference/SIDE_ROUTE_EST.step

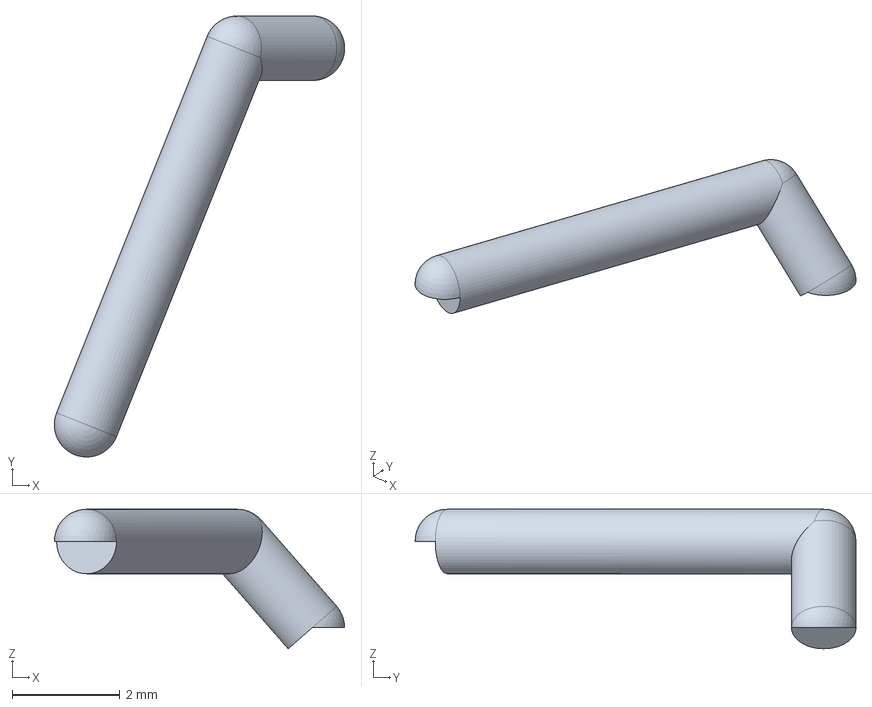
[picture p67: CAD file, 2026-10-19]
models/L2_r3/reference/SIDE_ROUTE_EST.step
5.40 x 8.20 x 2.60 mm
