Quietmirror/Quietmirror-L2/models/L2_r4/reference/RF_USB_HEADER_EST.step

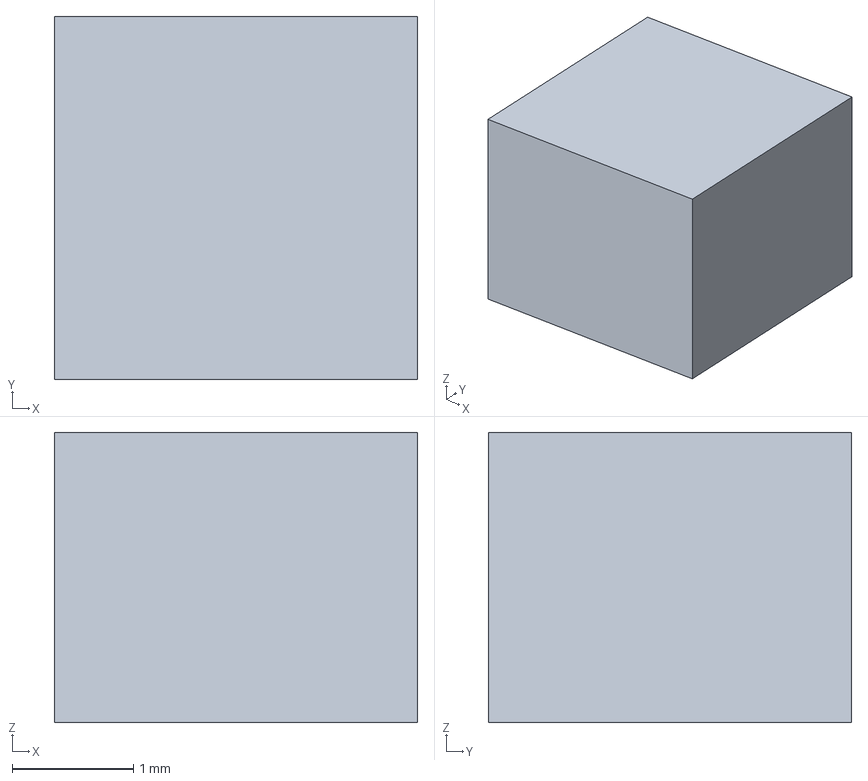
[picture p68: CAD file, 2026-10-20]
models/L2_r4/reference/RF_USB_HEADER_EST.step
3.00 x 3.00 x 2.40 mm
