Quietmirror/Quietmirror-L2/models/L2_r3/reference/SR_D2F_01F.step

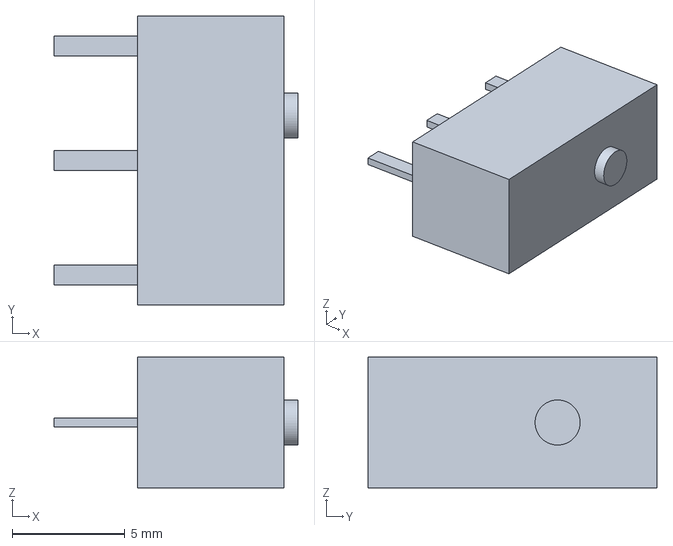
[picture p69: CAD file, 2026-10-19]
models/L2_r3/reference/SR_D2F_01F.step
10.8 x 12.8 x 5.80 mm
