Quietmirror/Quietmirror-L2/models/L2_r4/reference/SF_TUNING_SHIM_0p33.step

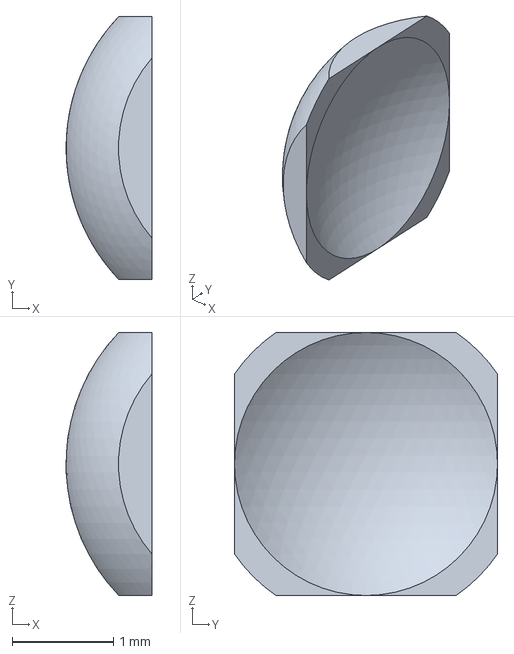
[picture p70: CAD file, 2026-10-20]
models/L2_r4/reference/SF_TUNING_SHIM_0p33.step
0.848 x 2.60 x 2.60 mm
