Quietmirror/Quietmirror-L2/models/L2_r4/reference/BATTERY_CELL_EST.step

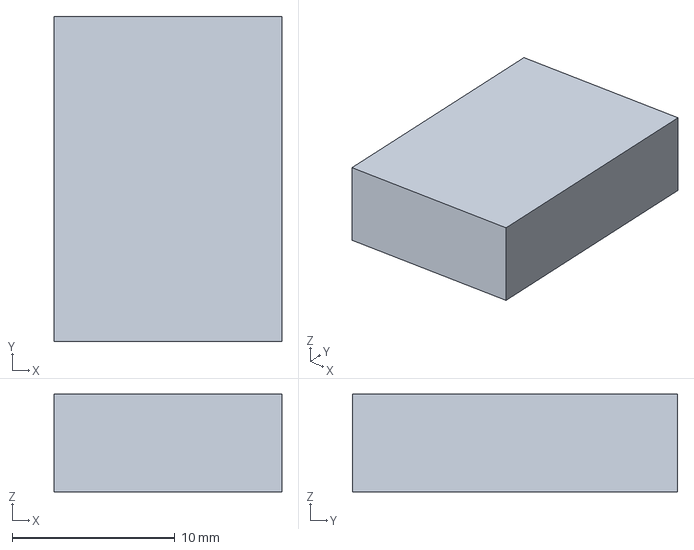
[picture p71: CAD file, 2026-10-20]
models/L2_r4/reference/BATTERY_CELL_EST.step
14.0 x 20.0 x 6.00 mm
