Quietmirror/Quietmirror-L2/models/L2_r4/reference/SF_RETAINER_M2x5.step

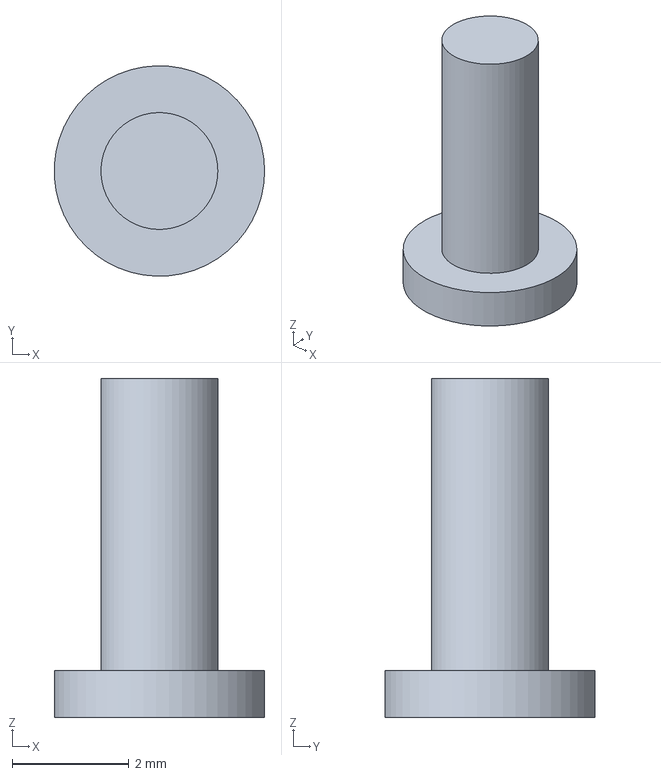
[picture p72: CAD file, 2026-10-20]
models/L2_r4/reference/SF_RETAINER_M2x5.step
3.60 x 3.60 x 5.80 mm
