Quietmirror/Quietmirror-L2/models/L2_r3/reference/CHARGE_POWERPATH_EST.step

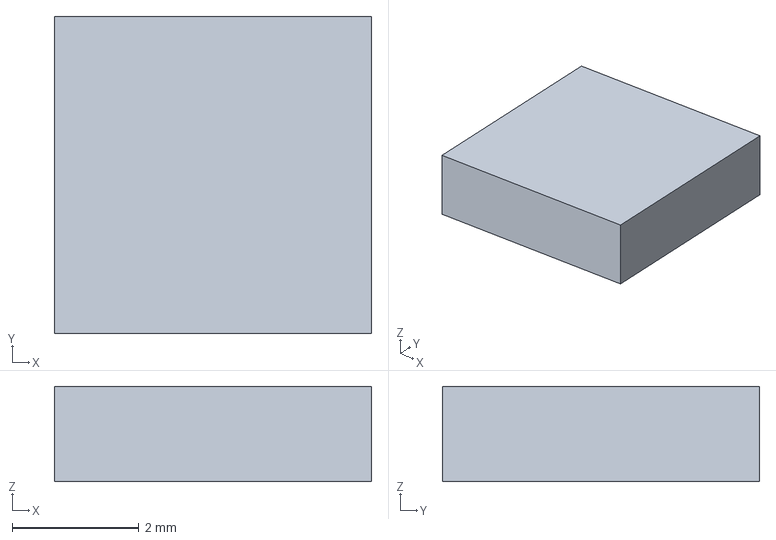
[picture p73: CAD file, 2026-10-19]
models/L2_r3/reference/CHARGE_POWERPATH_EST.step
5.00 x 5.00 x 1.50 mm
