Quietmirror/Quietmirror-L2/models/L2_r4/reference/USB_ROUTE_EST.step

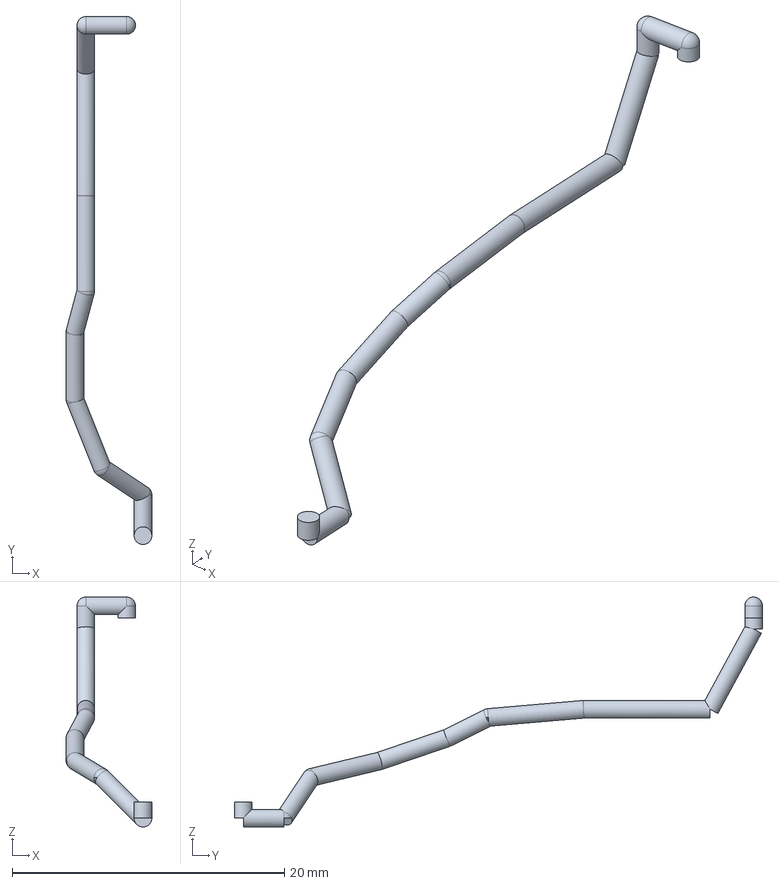
[picture p74: CAD file, 2026-10-20]
models/L2_r4/reference/USB_ROUTE_EST.step
6.30 x 38.8 x 16.9 mm
