Quietmirror/Quietmirror-L2/models/L2_r4/reference/ENCODER_M2x3_REAR.step

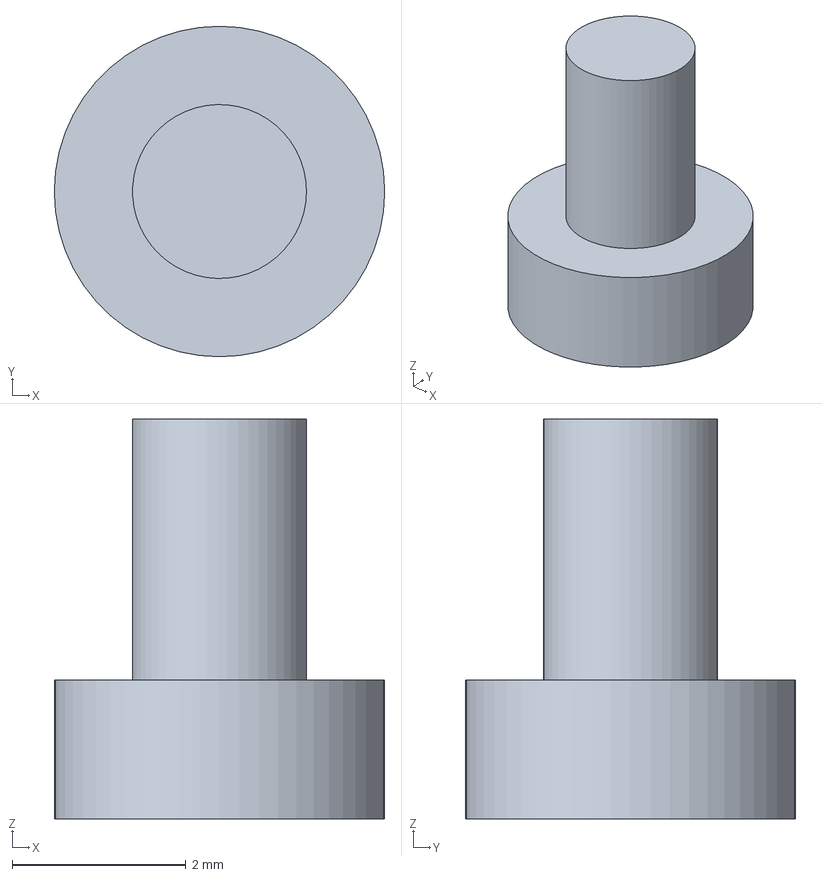
[picture p75: CAD file, 2026-10-20]
models/L2_r4/reference/ENCODER_M2x3_REAR.step
3.80 x 3.80 x 4.60 mm
