Quietmirror/Quietmirror-L2/models/L2_r3/reference/ANTENNA_FEED_ROUTE_EST.step

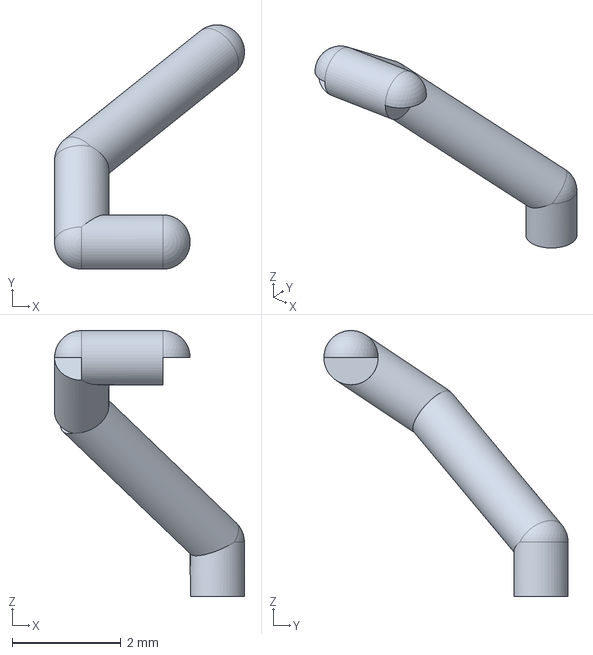
[picture p76: CAD file, 2026-10-19]
models/L2_r3/reference/ANTENNA_FEED_ROUTE_EST.step
3.50 x 4.50 x 4.90 mm
