Quietmirror/Quietmirror-L2/models/L2_r3/reference/SIDE_FRONT_KEY_F2_TRIAL.step

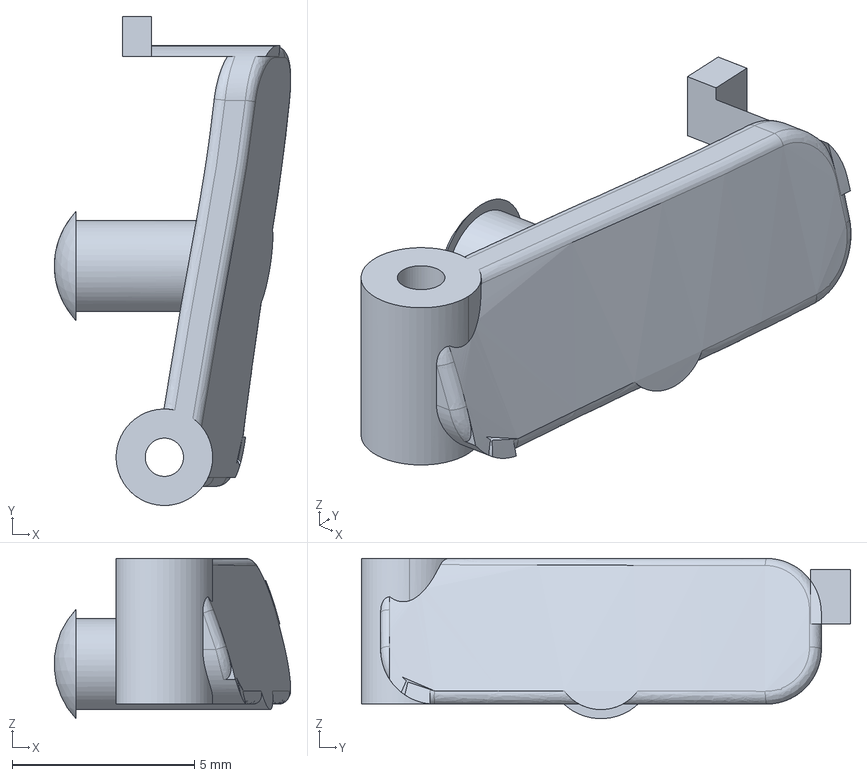
[picture p77: CAD file, 2026-10-19]
models/L2_r3/reference/SIDE_FRONT_KEY_F2_TRIAL.step
6.49 x 13.4 x 4.40 mm
