Quietmirror/Quietmirror-L2/models/L2_r4/reference/REGULATOR_EST.step

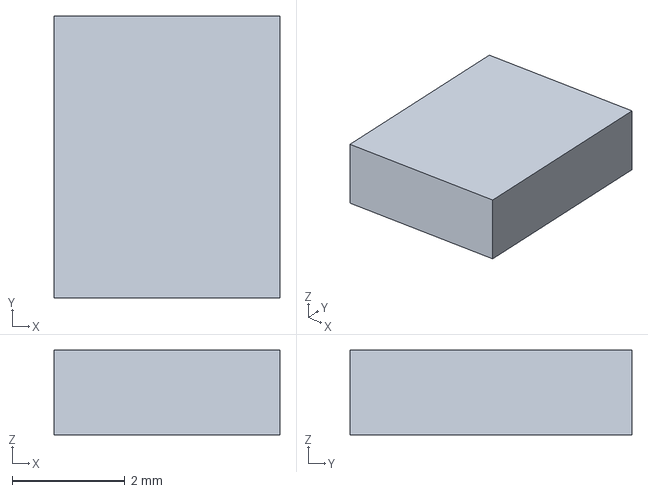
[picture p78: CAD file, 2026-10-20]
models/L2_r4/reference/REGULATOR_EST.step
4.00 x 5.00 x 1.50 mm
