Quietmirror/Quietmirror-L2/models/L2_r3/reference/ENCODER_ADAPTER_PCB_EST.step

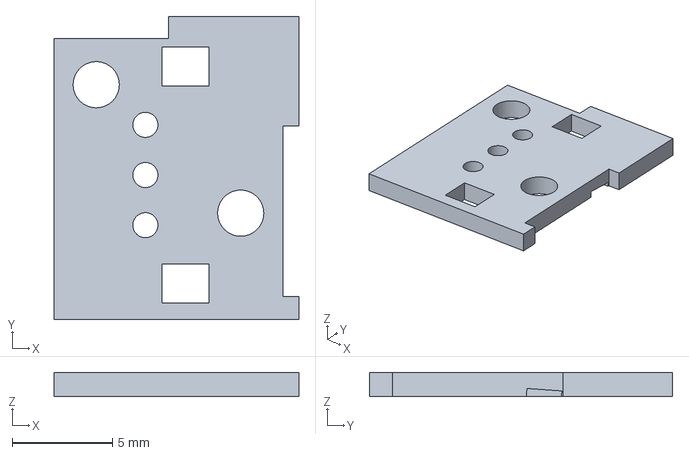
[picture p79: CAD file, 2026-10-19]
models/L2_r3/reference/ENCODER_ADAPTER_PCB_EST.step
12.2 x 15.1 x 1.20 mm
