Quietmirror/Quietmirror-L2/models/L2_r4/reference/MATCHED_LENS_EST.step

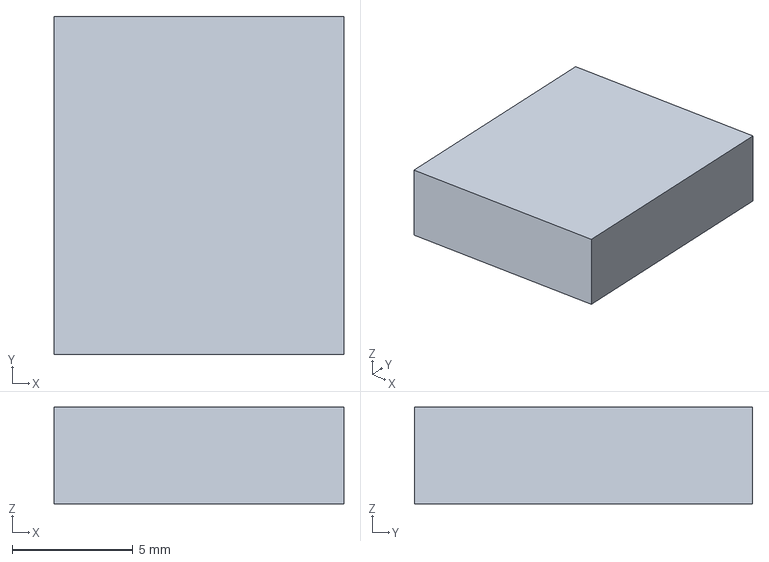
[picture p80: CAD file, 2026-10-20]
models/L2_r4/reference/MATCHED_LENS_EST.step
12.0 x 14.0 x 4.00 mm
