Quietmirror/Quietmirror-L2/models/L2_r4/reference/ENCODER_ADAPTER_PCB_EST.step

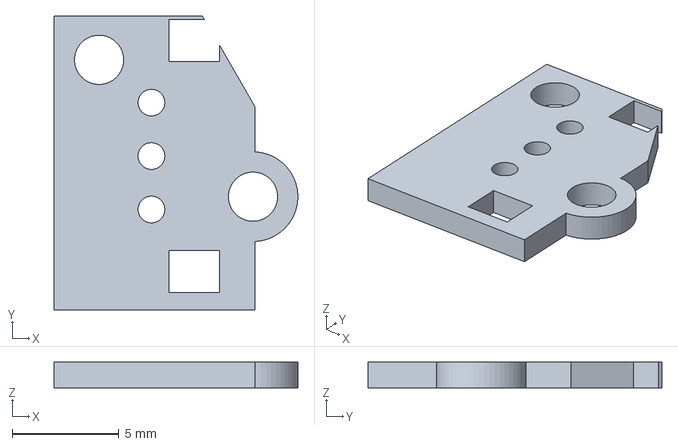
[picture p81: CAD file, 2026-10-20]
models/L2_r4/reference/ENCODER_ADAPTER_PCB_EST.step
11.4 x 13.7 x 1.20 mm
