Quietmirror/Quietmirror-L2/models/L2_r4/reference/REMOTE_ANTENNA_PCB_EST.step

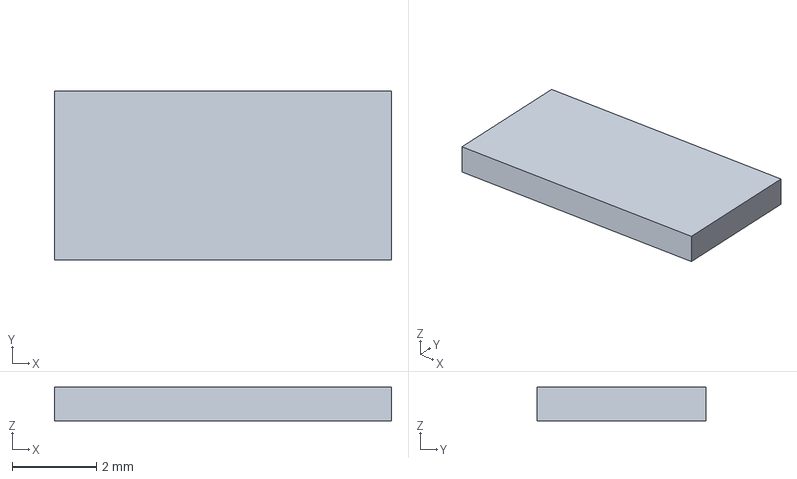
[picture p82: CAD file, 2026-10-20]
models/L2_r4/reference/REMOTE_ANTENNA_PCB_EST.step
8.00 x 4.00 x 0.8 mm
