Quietmirror/Quietmirror-L2/(list of files, cad)

Other CAD files:
models/L2_r4/FULL_ASSEMBLY_H.step
models/L2_r4_3D45_PLA/L2_r4_ALL_PARTS_PRINT_PLATE.stl
exports/l2_r2_diagnostic/SF_SWITCH_ENVELOPE.step
exports/l2_r2_diagnostic/REAR_EAR_SOURCE_REFERENCE.step
models/L2_r3/reference/SR_VERTICAL_PIN.step
models/L2_r4/reference/CONTROLLER_RF_PCB_EST.step
models/L2_r3/reference/SF_D2F_01F.step
models/L2_r4/reference/SR_RETAINER_M2x5.step
models/L2_r4/reference/RIGHT_KEY_STEEL_PIN.step
models/L2_r4/reference/SR_D2F_01F.step
models/L2_r4/reference/USB_M2x3_R.step
models/L2_r3/parts/BODY.stl
models/L2_r3/parts/WHEEL_CARRIER.step
models/L2_r3/reference/ENCODER_WASHER_REAR.step
models/L2_r3/reference/LEFT_KEY_M2_SWITCH_1_WASHER_HEAD.step
models/L2_r3/reference/LEFT_KEY_M2_SWITCH_2_NUT.step
models/L2_r3/reference/RIGHT_KEY_M2_SWITCH_1_WASHER_HEAD.step
models/L2_r3/reference/RIGHT_KEY_M2_SWITCH_2_BOLT.step
models/L2_r3/reference/RIGHT_KEY_M2_SWITCH_2_NUT.step
models/L2_r3/reference/RIGHT_KEY_M2_SWITCH_2_WASHER_HEAD.step
models/L2_r3/reference/WHEEL_M2_SWITCH_2_WASHER_HEAD.step
models/L2_r4/parts/SF_RETAINER.stl
models/L2_r4/reference/LEFT_KEY_M2_SWITCH_2_WASHER_NUT.step
models/L2_r4/reference/RIGHT_KEY_M2_SWITCH_1_NUT.step
models/L2_r4/reference/WHEEL_M2_SWITCH_1_NUT.step
models/L2_r4/reference/WHEEL_M2_SWITCH_1_WASHER_NUT.step
models/L2_r4/reference/WHEEL_M2_SWITCH_2_NUT.step
