Quietmirror/Quietmirror-L2/handoff/l2_r4/ASSEMBLY_SEQUENCE.md

# L2-r4 装配顺序与可达性

单位为 mm；+X 为拇指侧，−Y 为前端，+Z 向上。脚贴粘贴面 Z=5.2，估计脚贴厚度0.8，鼠标垫平面 Z=4.4。

1. 核对打印件与实物开关，清理支撑、孔和端子槽；先给两颗侧键开关焊接COM/NO线。
2. 依次装入SR开关、SF开关、SR挡板、SF挡板。SF开关会经过SR挡板位置，顺序不能互换。
3. 从底部拧入带参考垫圈的两颗M2×5自攻螺钉，固定挡板。
4. 按实测尺寸调整推杆PET膜，将两键帽沿−X直推到位，再从顶窗插入竖直钢销。
5. 装配主键、滚轮载架组和H电子件；电池与插头按下方已验证的可拆模块顺序操作。
6. 接通电路后才进行通断、手感、回弹、无线和充电测试；这些没有被CAD仿真代替。

## 四件从底部装入的路线

| 零件 | 体素姿态数 | 精确转折点/落座 | 结果 |
| --- | --- | --- | --- |
| SR_D2F_01F | 157 | 见JSON逐点数值 | True |
| SF_D2F_01F | 350 | 见JSON逐点数值 | True |
| SR_RETAINER | 123 | 见JSON逐点数值 | True |
| SF_RETAINER | 206 | 见JSON逐点数值 | True |

### SR_D2F_01F

相对最终位置的偏移和yaw：

```json
[[-16.25, 1.55, -14.75, 90], [-16.25, 1.55, -10.5, 90], [-16.25, 1.8, -10.5, 90], [-16.25, 1.8, -10.5, 0], [-16.25, 1.8, 0.5, 0], [-16.25, 0, 0.5, 0], [-0.5, 0, 0.5, 0]]
```

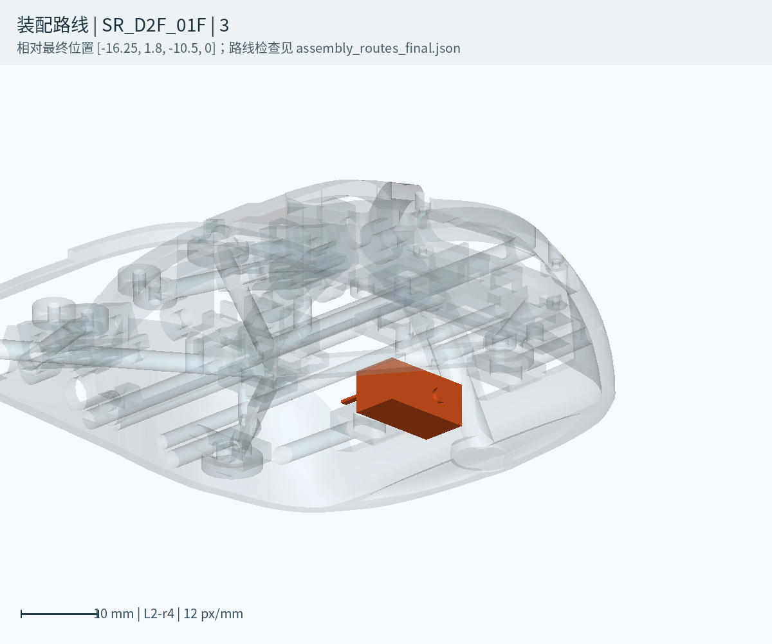
[picture p83: views/l2_r4/ASSEMBLY_SR_D2F_01F_3.png]
SR_D2F_01F 3
SR_D2F_01F 1 SR_D2F_01F 2  SR_D2F_01F 4 SR_D2F_01F 5

### SF_D2F_01F

相对最终位置的偏移和yaw：

```json
[[-15.75, 16.0, -15.5, 90.0], [-15.75, 16.0, -6.75, 90.0], [-15.75, 16.25, -6.75, 90.0], [-15.75, 16.25, -6.75, 85.0], [-15.75, 16.5, -6.75, 85.0], [-15.75, 16.5, -6.75, 80.0], [-15.75, 17.0, -6.75, 80.0], [-15.75, 17.0, -6.75, 75.0], [-16.75, 17.0, -6.75, 75.0], [-16.75, 17.0, -3.25, 75.0], [-16.75, 16.0, -3.25, 75.0], [-16.75, 16.0, -0.5, 75.0], [-16.75, 11.25, -0.5, 75.0], [-16.75, 11.25, 0.5, 75.0], [-13.0, 11.25, 0.5, 75.0], [-13.0, 11.25, 3.5, 75.0], [-13.0, 11.0, 3.5, 75.0], [-12.5, 11.0, 3.5, 75.0], [-12.5, 11.0, 3.5, 70.0], [-12.5, 10.75, 3.5, 70.0], [-12.0, 10.75, 3.5, 70.0], [-12.0, 10.75, 3.5, 65.0], [-11.5, 10.75, 3.5, 65.0], [-11.5, 10.75, 3.5, 60.0], [-11.5, 10.25, 3.5, 60.0], [-11.0, 10.25, 3.5, 60.0], [-11.0, 10.25, 3.5, 55.0], [-11.0, 9.5, 3.5, 55.0], [-10.5, 9.5, 3.5, 55.0], [-10.5, 9.5, 3.5, 50.0], [-10.25, 9.5, 3.5, 50.0], [-10.25, 9.5, 6.25, 50.0], [-10.0, 9.5, 6.25, 50.0], [-10.0, 9.5, 6.25, 45.0], [-10.0, 8.75, 6.25, 45.0], [-10.0, 8.75, 5.0, 45.0], [-10.0, 8.5, 5.0, 45.0], [-10.0, 8.5, 4.75, 45.0], [-10.0, 8.25, 4.75, 45.0], [-10.0, 8.25, 3.5, 45.0], [-9.75, 8.25, 3.5, 45.0], [-9.75, 8.25, 3.5, 40.0], [-9.75, 7.5, 3.5, 40.0], [-9.25, 7.5, 3.5, 40.0], [-9.25, 7.5, 3.5, 35.0], [-9.25, 6.75, 3.5, 35.0], [-9.0, 6.75, 3.5, 35.0], [-9.0, 6.75, 3.5, 30.0], [-9.0, 6.0, 3.5, 30.0], [-8.75, 6.0, 3.5, 30.0], [-8.75, 6.0, 3.5, 25.0], [-8.75, 5.5, 3.5, 25.0], [-7.0, 5.5, 3.5, 25.0], [-7.0, 5.25, 3.5, 25.0], [-6.75, 5.25, 3.5, 25.0], [-6.75, 4.75, 3.5, 25.0], [-6.5, 4.75, 3.5, 25.0], [-6.5, 3.5, 3.5, 25.0], [-6.25, 3.5, 3.5, 25.0], [-6.25, 3.0, 3.5, 25.0], [-6.0, 3.0, 3.5, 25.0], [-6.0, -0.25, 3.5, 25.0], [-6.0, -0.25, 3.0, 25.0], [-6.0, -0.5, 3.0, 25.0], [-6.0, -0.5, 0.5, 25.0], [-5.25, -0.5, 0.5, 25.0], [-5.25, -0.5, 0.5, 20.0], [-4.75, -0.5, 0.5, 20.0], [-4.75, -0.5, 0.5, 15.0], [-4.75, -0.75, 0.5, 15.0], [-4.25, -0.75, 0.5, 15.0], [-4.25, -0.75, 0.5, 10.0], [-4.25, -0.5, 0.5, 10.0], [-3.75, -0.5, 0.5, 10.0], [-3.75, -0.5, 0.5, 5.0], [-3.25, -0.5, 0.5, 5.0], [-3.25, -0.5, 0.5, 0.0], [-0.5, -0.5, 0.5, 0.0]]
```

SF_D2F_01F 1 SF_D2F_01F 2 SF_D2F_01F 3 SF_D2F_01F 4 SF_D2F_01F 5

### SR_RETAINER

相对最终位置的偏移和yaw：

```json
[[-12.15, 2.2, -14.75, 0], [-12.15, 2.2, 0.55, 0], [-12.15, 0, 0.55, 0], [-4.5, 0, 0.55, 0], [-0.3, 0, 0.55, 0]]
```

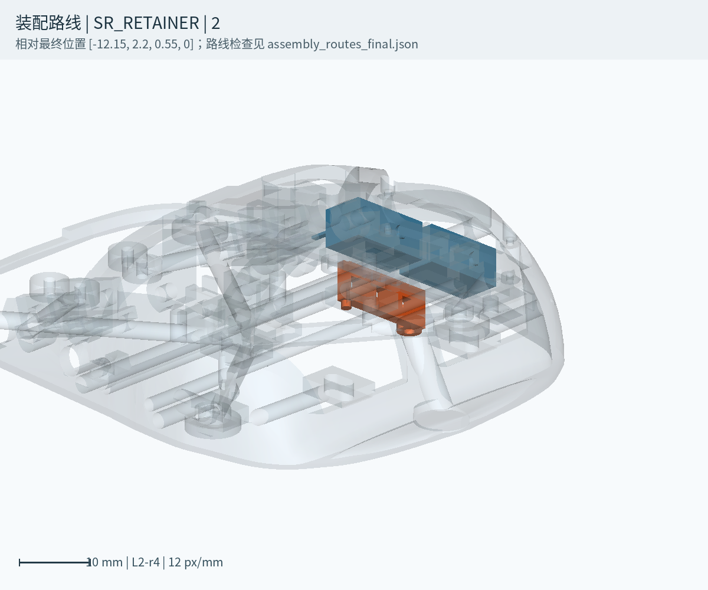
[picture p84: views/l2_r4/ASSEMBLY_SR_RETAINER_2.png]
SR_RETAINER 2
SR_RETAINER 1  SR_RETAINER 3 SR_RETAINER 4 SR_RETAINER 5

### SF_RETAINER

相对最终位置的偏移和yaw：

```json
[[-11.85, 15.8, -14.75, 90], [-11.85, 15.8, -10.5, 90], [-11.85, 16.05, -10.5, 90], [-11.85, 16.05, -10.5, 0], [-11.85, 16.05, 0.55, 0], [-11.85, 13.0, 0.55, 0], [-10.3, 13.0, 0.55, 0], [-10.3, 9.5, 0.55, 0], [-6.5, 9.5, 0.55, 0], [-6.5, 2.0, 0.55, 0], [-4.5, 2.0, 0.55, 0], [-4.5, 0, 0.55, 0], [-0.3, 0, 0.55, 0]]
```

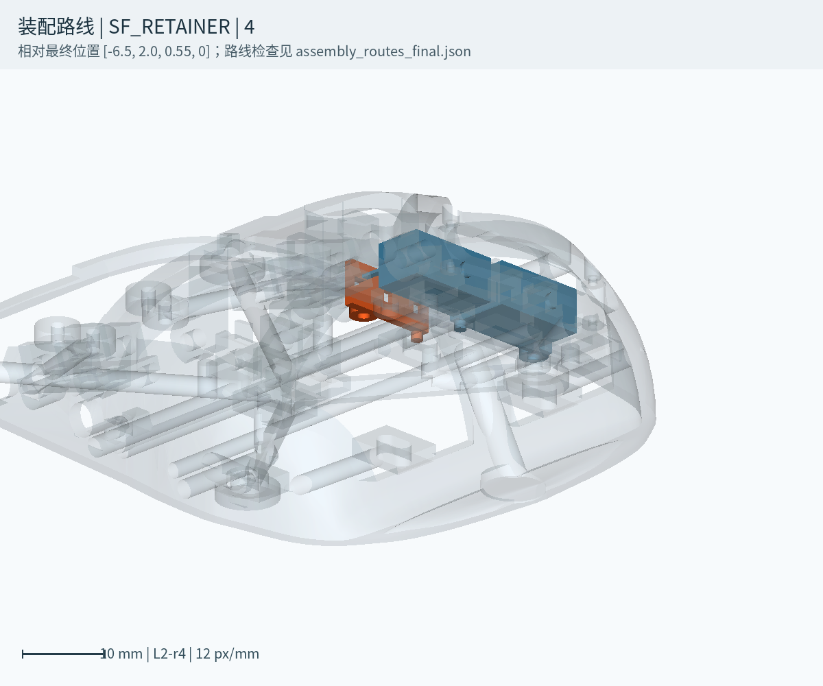
[picture p85: views/l2_r4/ASSEMBLY_SF_RETAINER_4.png]
SF_RETAINER 4
SF_RETAINER 1 SF_RETAINER 2 SF_RETAINER 3  SF_RETAINER 5

## 电池与插头

电池路线通过：True；插头工具接近通过：True。

1. Disconnect the estimated battery connector using the checked front2mm tool profile
2. Remove main keys and removable wheel carrier assembly
3. Remove screwed H electronic modules and free flexible wires and actual battery retention
4. Follow the saved rigid extraction path toward the bottom; retain the integral BODY and both side modules
5. Reverse the route to insert the battery, then restore wiring, retention and removable modules

实际姿态、最小距离和保留障碍物见 [battery_service_path.json](../../reports/l2_r4/battery_service_path.json)。不能从静态放入结论推断装拆可行，也不能在实物中弯折电池来绕过框架。
