Quietmirror/Quietmirror-L2/specs/Quietmirror_L2_r3_FINAL_Build_and_Release_2026-10-18.md

# Quietmirror L2 r3｜最终修改 + 建模 + 视图 + 上传（唯一执行文件）

**日期：** 2026-10-18
**交给：** 建模和发布智能体
**要做的事：** 按本文数据修改 R3.2 → 建一体式装配模型和单盘分件打印模型 → 检查 → 出成品六面视图 → 上传 GitHub，发布为新版本 `L2-r3`。

**本文地位：**
- 本文是**唯一需要执行的文件**，自成一体，取代 `Quietmirror_L2_r3_Execution_Brief_2026-10-18.md`。
- 背景和推导过程见 `Quietmirror_L2_FINAL_Plan_2026-10-17.md`（r3）。
- 两者冲突时，以本文为准。侧键模块的数值以 `D:\Quietmirror_L2\l2_r3_check\r3_parameters.json` 为准（本文表格由它抄出）。

---

## 0. 基准和硬规则

| 项 | 规定 |
|---|---|
| 几何基准 | Quietmirror/github @ `f1b1090931d717117287ea2b79c2e14ddc234937`（R3.2）。在 R3.2 源码上修改，沿用 `rebuild_body()` 流程；**不得从零建模，不得覆盖 R3.2 文件** |
| 坐标 | R3.2 装配坐标：+X 为拇指侧（侧键侧），Y 值小的一端为前，Z 向上；脚贴粘贴面 Z 5.2；BODY 外缘最低面 Z 5.0 |
| 工作位置 | 全部在 D 盘：`D:\Quietmirror_L2`。先执行 `. D:\Quietmirror_L2\_support\enter-env.ps1`；重型进程用 `_support\run_guarded.ps1 -LimitGB 8` |
| 体积和质量 | 一律用 `BRepGProp.VolumeProperties_s(shape, props, 1e-8, True, False)`。**禁止**用 cadquery 默认的 `Volume()`：它把 R3.2 BODY 算成 13,362.27，正确值是 12,801.73 |
| 布尔运算 | 不在已裁剪的 BSpline BODY 上做大布尔。新面、边与原有面、边至少相距 0.3，或者完全重合。旧特征在**源码层**取消，不在成品上补片 |
| 零件检查 | 每个零件导出后重新导入，必须是单一有效实体；BODY 必须能用 gmsh 生成网格 |
| 不得编造 | 缺数据时标 `UNVERIFIED`、`3D_FEM_BLOCKED` 或 `INCOMPLETE` |

---

## 1. 最终决定

| 项目 | 决定 |
|---|---|
| 顶面镂空 | **保持 R3.2 原六孔**。3D 三档网格已比较：圆角孔只有 97.8–99.5%，三角网格掌压只有 83–84% |
| 壳厚 | 全部 1.8 |
| 骨架 | 删除 Y54 横梁的外臂（保留滚轮中心枢纽）；保留 Y67.5 横梁、下横梁 Y40.8、前斜撑；两根后斜撑改为 1.6 × 2.8 竖放矩形 |
| 主键 | 1.6 蒙皮 + 2 根纵筋 + X 形斜筋 |
| 滚轮 | 轮辋 1.4、5 根辐条、轮毂 Ø5 |
| 侧键 | Fenrir 式上侧壁细长杠杆键（键带 Z 15.5–19.5，分体两键），按 Fenrir 的动作原则：D2F-01F 低力微动、零间隙调整、可调硬止挡、外向限位卡舌 |
| 侧键模块 | 键帽 + 托架 + SIDE_IO_PCB + 2 颗微动，可整体更换；默认 F1 齐平，另出 F2 人体工学试验件 |
| 传感器（H 方案） | PAW3950 |
| 供体（D 方案） | **型号待用户确认**（用户写“ATK A1 Pro”，复核仓库记为“ATK A1 Plus”）。只做占位检查，标注 `DONOR_ID_PENDING_USER_CONFIRMATION / PCB_GEOMETRY_UNVERIFIED / FIT_NOT_CERTIFIED` |
| 质量 | PA12 预算约 **17.42 g**（R3.2 为 18.69 g）；最终以 CAD 实测为准 |

---

## 2. 第一步：独立复核（不通过不得建模）

1. 拉取 [Quietmirror/Quietmirror-L2](https://github.com/Quietmirror/Quietmirror-L2) 的最新 main（当前为 `ab2240f3`）。如果有更新的复核，先读；与本文冲突就停下来报告。
2. 用**自己写的脚本**（不得只运行本文作者的脚本）核对下表，写入 `handoff/l2_r3/SECOND_CHECK.md`（格式：本文值 / 复核值 / 偏差 / 结论）。偏差超出容差的，写进 `handoff/l2_r3/PARAMETERS_CORRECTED.md` 并说明原因。

| # | 核对项 | 本文值 | 容差 |
|---|---|---|---|
| K1 | R3.2 九个打印件的体积 | 18,506.678 mm³（BODY 12,801.730） | ±0.5 |
| K2 | 悬臂梁解析基准 | 误差 < 1.5% | < 5% |
| K3 | R3.2 基线 8 个工况（附录 A 的选面和网格设置） | 2.4 mm：105.64 / 24.95 / 24.28 / 34.47 / 29.37 / 496.43 / 62.21 / 56.21 N/mm | ±3%；不过就如实记录，不调参数凑数 |
| K5 | 去掉顶面蒙皮后的 12 个内部连通组 | 主键铰座、Y67.5 横梁、中心枢纽、后脚支撑都保留 | 逐组写保留 / 删除 |
| K6 | 开口来源 | §3.2 表 | ±0.3 |
| K9 | 侧键模块 | 按 `r3_parameters.json` 建模，对照 §6 的障碍物逐项重测（参考值见 §6.2） | 偏差 ≤ 0.02 |
| K9b | 旧座重叠 | 按 `mechanics.py` 第 221–287 行重建旧侧键座；新模块与未改动 BODY 的重叠，除 0.039 mm³（耳连接臂筋顶）外，全部落在旧座内 | 结论一致 |

---

## 3. 最终修改

### 3.1 BODY

| # | 修改 | 参数 |
|---|---|---|
| B1 | 顶面六孔 | 不变 |
| B2 | 骨架 | 删除 Y54 横梁外臂（约 −227 mm³），保留 X ±6、Y 47–55 的滚轮枢纽和钢销通道；后斜撑（脚 (±24.84, 62.64) → (0, 46, 6.5)）改为 1.6 × 2.8 竖放矩形（−49.5 mm³） |
| B3 | 删除 R3.2 旧侧键座 | 源码层不再生成 `mechanics.py` 第 221–287 行的 frame、bridge、flange、shoulders、rails、fence 及其 M2 孔和捕获销槽（约 −970 mm³） |
| B4 | 取消旧开口（源码层） | 不再生成：第 239 行的旧侧键开口切除 `box(22, 10.7, 5.7, …)`；第 274–277 行的捕获销通道；`fasteners.py:m2_set` 给侧键的工具通道。母壳 1.8 蒙皮保持连续 |
| B5 | 新侧键开口 | SF：Y 43.9–56.6、Z 15.2–19.8；SR：Y 57.8–71.1、Z 15.2–19.8（键帽四周间隙 0.30，FDM 版 0.35）；向内切 3.5 |
| B6 | R5 加强圈 | 上圈 1.2（高）× 1.6（向内）；两开口之间的隔墙 Y 56.6–57.8 兼作共用端圈（1.2 × 1.6，内面约 X 28.65，是两键外向限位卡舌的贴合面）；SR 后端圈 1.0 × 1.6；SF 前端和开口下沿不设内凸圈；开关正上方的上圈内表面不得越过 X 25.7（SF）/ 26.2（SR） |
| B7 | 侧键铰座 | 竖直钢销 Ø1.0 × 5.5，轴心 (29.0, 45.0)（SF）/ (29.0, 70.0)（SR）；键帽铰节孔 Ø1.05（滑配，属功能配合）；钢销两端压入上圈和开口下沿凸耳的 Ø0.95 孔，孔周壁厚 ≥ 0.8；下沿凸耳离前安装块 ≥ 0.5。**钢销从顶面窗口沿 −Z 装入**，原定的底部路径被前耳挡住；必须做 Ø2.0 视线检查 |
| B8 | **+X 两耳改为托架安装耳** | 中心 (27.331, 43.0) 和 (28.604, 66.0)，盒体 7.6 × 7.6 × 2.5（Z 8.25–10.75）不变。① 连接臂中心从 Z 9.5 降到 9.25，筋顶 10.55，低于耳顶 0.2；② 取消原长槽（原连接臂横穿槽中段，M2 穿不过），改开 Ø2.2 通孔：前 (25.73, 43.3)、后 (27.0, 66.3)，在连接臂融合之后再切孔。−X 两耳不动 |
| B9 | +X keep 遮罩 | 构造坐标 side < 0 的 `box(14, 28, 10) @(−29s, 53.5s, 14.75s)` 改为在装配坐标中覆盖 X 24–38、Y 40–73、Z 10.9–21.0 |
| B10 | 夹持带 Z 5.2–14.5 | 1.8，连续，不开孔 |

### 3.2 开口处理

| 编号 | 来源 | 处理 |
|---|---|---|
| O1 / O2 / O4（六孔之外的附加切除 25.96 / 16.70 / 2.14 mm³） | 旧侧键微动 M2 的螺丝刀工具通道 | 源码层取消，**六孔边界保持不变** |
| O3（轴线 Y 50 / Z 19，Ø2.35） | 滚轮载架钢销的贯穿和装入通道 | **保留**，新结构不得堵住 |
| PH1 (26.99173, 50) / PH2 (27.70980, 65)，Ø1.72 | 旧侧键捕获销孔 | 源码层取消 |

结果写入 `handoff/l2_r3/OPENINGS_RESOLUTION.md`：每个开口写出源码出处、处理方式、体积变化和网格是否通过。

### 3.3 其他零件

| 零件 | 修改 |
|---|---|
| LEFT_KEY / RIGHT_KEY | 指尖区 Y ≤ 12、触发点周围 Ø8、铰链区 Y ≥ 36 保持 2.0；其余改为 1.6 蒙皮 + 2 根纵筋 0.9 × 1.6（距中线 ±5.0）+ 1 对 X 形斜筋 0.9 × 1.6，筋根 R0.4；前端薄边补到 ≥ 0.8 |
| WHEEL | 外径 12.5、宽 6.5、六角 1.67 AF 不变；轮辋径向 1.4，5 根辐条宽 1.2，轮毂 Ø5.0 |
| WHEEL_CARRIER | 不变 |
| 删除 | 两枚旧夹条、旧捕获销、旧侧键的 4 组 M2、旧滑块式侧键 |

### 3.4 质量预算（PA12，基准 18,506.678 mm³）

| 项 | mm³ |
|---|---:|
| 删除 Y54 横梁外臂 / 后斜撑改截面 | −227 / −49.5 |
| 删除旧侧键座 / 两枚夹条 | −970 / −385.8 |
| 新开关托架（含安装块、外延、背托台、PCB 安装座） | +705（CAD 实测 681.6，未开端子槽） |
| R5 圈 / 夹持带开口变化 / 回填 O1 / O2 / O4 和 PH | +77 / −48 / +45 |
| 主键 ×2 / 滚轮 / 新键帽 / 推杆 / 补强和圆角 | −136 / −261 / −109 / +45 / +60 |
| **合计** | **−1,255 → 约 17.42 g**（PA12S 约 16.90 g） |

---

## 4. 侧键模块（Fenrir 式）

### 4.1 键帽 SIDE_FRONT_KEY / SIDE_REAR_KEY

| 参数 | SF | SR |
|---|---:|---:|
| 键面 Y / Z | 44.2–56.3 / 15.5–19.5 | 58.1–70.8 / 15.5–19.5 |
| 外表面 | 母壳法向外偏 +0.20；缝端定位脊 +0.15；总突出 ≤ 0.35 | 同左 |
| 壳厚 / 圆角 | 1.2 / R1.5，外缘 R0.3 | 同左 |
| 铰轴（竖直钢销） | (29.0, 45.0) | (29.0, 70.0) |
| 推杆 | Ø2.5，位于 (Y 50.25, Z 16.6)；末端带 Ø3.0 × 0.6 压盘；名义长 4.39（键帽内表面 X 30.36 → 推杆端 X 25.97） | Ø2.5，位于 (Y 64.45, Z 16.6)；名义长 4.55（31.02 → 26.47） |
| 静止间隙（推杆端 ↔ 按钮） | 名义 0.35，装配时调到 0.00–0.03（§4.5） | 同左 |
| 偏心 | Y 0 / Z −0.9（键面中心 Z 17.5） | 同左 |
| 止挡筋 | 高 0.6，Y 54.0–55.2、Z 15.9–16.4，碰止挡面 X 29.74 | Y 59.3–60.5、Z 15.9–16.4，碰止挡面 X 30.04 |
| 外向限位卡舌 | 卡舌 X 27.85–28.65、Y 56.0–57.1、Z 17.7–19.2；连接筋 X 28.65–30.3、Y 56.0–56.3 | 卡舌 X 27.85–28.65、Y 57.35–58.4、Z 15.8–17.3；连接筋 X 28.65–30.9、Y 58.1–58.4 |
| 力臂 / 止挡转角 / 远端缝行程 | 5.25 / 6.80° / 1.34 | 5.55 / 6.37° / 1.32 |
| 最坏触发转角（PT 0.5） | 5.63° | 5.28° |
| 推杆端在止挡时的 Y 向滑移 | −0.40 | +0.32 |
| 按压力：键面中点 / 距铰点 L/4 / 远端缝 | 0.74 / 1.28 / 0.34 N | 0.74 / 1.29 / 0.35 N |

- 静止时，卡舌外侧面贴在隔墙端圈内面；按下后卡舌离开端圈。两只键的卡舌上下错开 0.4。
- **装键帽：** 先把卡舌从外侧斜插到端圈后面，再把铰链端摆入开口，最后从顶面窗口压入钢销。
- 推杆末端是平面压盘。所有角度都是绕铰轴的刚体旋转结果，铰轴的 X、Z 和推杆 X 在 CAD 里必须做成参数。
- 嫌侧键太轻，可以换 D2F-01（按压力翻倍），几何不变。

### 4.2 微动 Omron D2F-01F（×2）

| 参数 | SF | SR |
|---|---:|---:|
| 规格 | 针式按钮，OF ≤ 0.74 N，PT ≤ 0.5，OT ≥ 0.25，MD ≤ 0.12，OP 5.5 ± 0.3，金合金触点 | 同左 |
| 本体 X / Y / Z（12.8 × 5.8 × 6.5，按钮朝 +X） | 18.5–25.0 / 41.85–54.65 / 13.7–19.5 | 19.0–25.5 / 56.05–68.85 / 13.7–19.5 |
| 按钮尖 | (25.62, 50.25, 16.6) | (26.12, 64.45, 16.6) |
| 直插端子：X 范围 / Y（间距 5.08） | 14.8–18.5 / 43.17、48.25、53.33 | 15.3–19.0 / 57.37、62.45、67.53 |
| 接线 | COM + NO | 同左 |

### 4.3 开关托架 SIDE_SWITCH_CARRIER（新打印件，必须是 1 个实体）

| 特征 | X | Y | Z | 说明 |
|---|---|---|---|---|
| 底板 | 17.3–25.5 | 41.8–71.2 | 12.1–13.7 | 前端避开主键尾部（Y ≤ 41.15）和铰座圆柱 |
| 减重窗 ×2 | 19.0–23.0 | 46.0–54.0 / 57.5–65.5 | 贯穿 | |
| 后挡墙 | 17.3–18.5 | 41.8–71.2 | 12.1–19.5 | 6 个端子槽 1.6 × 1.2，对准 §4.2 的端子 Y |
| SR 背托台 | 18.5–19.0 | 56.05–68.85 | 13.7–19.5 | SR 开关 −X 面的承压面；端子槽贯通 |
| 隔板 | 18.5–25.5 | 54.95–55.75 | 13.7–19.5 | 两开关在 Y 向各留 0.30 的定位配合 |
| SF 止挡柱 | 下段 25.5–29.45 / 上段 25.5–29.74 | 53.6–55.4 | 下段 13.4–15.7 / 上段 15.7–16.4 | 只有上段（位于开口内）伸到止挡面 |
| SR 止挡柱 | 下段 26.0–29.9 / 上段 26.0–30.04 | 59.1–61.1 | 同上 | 同上 |
| 底板外延 ×2 | 25.5–26.8 | 与各自止挡柱相同 | 12.1–13.7 | 止挡柱底部嵌入 0.3 |
| 前安装块 | 24.0–28.2 | 41.8–45.8 | 10.75–13.7 | 压在前耳顶面（承压约 13.0 mm²）；自攻孔 Ø1.7 @(25.73, 43.3)，贯通 |
| 后安装块 | 24.0–29.2 | 64.9–67.9 | 10.75–13.7 | 承压约 9.4 mm²；自攻孔 Ø1.7 @(27.0, 66.3)，贯通 |
| PCB 安装座 ×3 | 16.2–17.3 | 44.4–46.0 / 54.95–55.75 / 68.65–70.0 | 14.1–15.7 | 热熔柱或 M1.4 自攻 |

- **固定：** 两颗 M2 × 5 盘头自攻螺钉从下往上穿过耳孔，拧入安装块，螺钉尖到 Z 13.25。耳孔为 Ø2.2，托架可以在 Y 向微调，对中后拧紧。
- **H 转接件：** 如果要用 +X 耳，只能夹在耳的下表面，同一颗螺钉加长到 M2 × 6 或 M2 × 7。
- **体积：** 681.6 mm³（未开端子槽）。参考模型：`l2_r3_check/R3_SIDE_SWITCH_CARRIER.step`。

### 4.4 SIDE_IO_PCB 和接线

- **板：** FR4 1.0 mm，X 15.2–16.2、Y 42.0–70.0、Z 13.3–18.8。6 个 Ø1.2 端子孔（§4.2），边距 ≥ 0.5；离传感器安装耳 0.5。
- **接线：**
  - 3 根线：COM、SF-NO、SR-NO。用 0.5 mm 间距 4P FPC，或 32 AWG 硅胶线。
  - 从板上沿（Z 18.8，Y ≈ 64）接到 H 方案 RF / MCU 板的 GPIO 焊盘，跨越距离 2.2 mm。
  - D 方案：拆下供体原有侧键微动，把这 3 根线焊到原焊盘上，不得切割供体 PCB。
  - 去抖在固件里做。

### 4.5 装配时调整（每只侧键做一次，记入 `TUNING_LOG.md`）

1. **零间隙：** 在推杆压盘上贴 PET 背胶膜（Ø3，厚 0.05 / 0.10，可以叠贴），把静止间隙调到 0.00–0.03：键帽不晃，也不触发。未调间隙按公差在 0.00–0.70 之间；个别为负时，把压盘砂磨 ≤ 0.10。
2. **止挡：** 推杆处行程 0.60 大于 PT 上限 0.5，所以按到止挡一定触发。在止挡面贴 PET 膜，把触发后的余量调到 0.05–0.10，并且 ≤ 0.25，得到“点击后立即硬止挡”的手感。
3. **通断测试：** 键面中点、近铰端、远端各按 10 次，必须全部触发、全部复位。

---

## 5. 模型文件

### 5.1 一体式装配模型（整机）

| 文件（`models/L2_r3/`） | 内容 |
|---|---|
| `FULL_ASSEMBLY_H.step` / `.FCStd` / `.glb`（glb 可选） | H 方案整机：BODY、两只主键、两只侧键、托架、滚轮、滚轮载架、2 颗 D2F-01F、主键和中键微动、编码器、全部钢销和螺钉、SIDE_IO_PCB、传感器板、PAW3950、镜头、RF / MCU 板、电池、USB 板、脚贴（0.8 mm）。**每个都是独立组件，不得融合** |
| `FULL_ASSEMBLY_D_PLACEHOLDER.step` | D 方案占位：供体板用参数化占位，标注待确认 |

**H 方案元件初始包络**（实测后替换）：

| 元件 | 尺寸 / 位置 |
|---|---|
| 传感器板 | 18 × 18 × 1.2 @(4, 66, 14.8) |
| PAW3950 | 8 × 8 × 2.4 @(0, 66, 13) |
| 镜头 | 12 × 14 × 4 @(0, 66, 9.8) |
| RF / MCU 板 | 18 × 18 × 1.2 @(4, 64, 18.5) |
| 电池 | 18 × 22 × 6 @(−17, 57, 16.4)，服务包络 19 × 23 × 7 |
| 天线 | @(0, 61.5, 25)，禁区 12 × 8 × 5 |
| 光路 | 7 × 10 × 12 @(0, 66, 1.8) |
| USB 转接板 | 20 × 10 × 1，孔 (±7.8, 13) |
| 编码器板 | ≤ 12.2 × 15.1 × 1.2 |

- 镜头到垫面的距离现在只是估计值（3.1），传感器托做成可用垫片调 ±0.5。
- 脚贴默认 0.8 mm，外缘离地 0.6。

### 5.2 单盘分件打印模型

| 文件（`models/L2_r3/`） | 内容 |
|---|---|
| `L2_r3_H_ALL_PARTS_SINGLE_PLATE.3mf` | 全部打印件排在**一个**盘上：BODY、LEFT_KEY、RIGHT_KEY、SIDE_FRONT_KEY、SIDE_REAR_KEY、SIDE_SWITCH_CARRIER、WHEEL、WHEEL_CARRIER（以及 H 转接件，如果已定义）。Dremel 3D45 床尺寸 255 × 155（配置假设），PLA，0.4 喷嘴 / 0.20 层高，PrusaSlicer 2.9.6，**真实切片，不缩放**，零件间距 ≥ 5 |
| `SIDE_MODULE_F2_TRIAL.3mf` | F2 人体工学侧键试验件（外偏 +0.30，总突出 0.45，超出 0.35 上限，只用于试握对比） |
| `parts/*.step`、`parts/*.stl` | 逐件文件 |
| `SLICE_REPORT.md` | 每个零件的打印方向和支撑区域；零件、支撑、裙边的质量和打印时长；整盘排布截图 |

---

## 6. 检查与验收

### 6.1 门槛

| 门槛 | 要求 | 输出 |
|---|---|---|
| G1 实体 | 每个打印件都是单一有效实体 | `reports/l2_r3/solids.json` |
| G2 静态干涉 | 两两求交 ≤ 0.001 mm³（有意接触另列清单）。间隙要求：固定件 ↔ BODY / 电子包络 ≥ 0.5；活动件 ≥ 0.3（FDM）；钢销等功能配合单独列出 | `handoff/l2_r3/INTERFERENCE_REPORT.md` |
| G3 侧键模块 | 用**最终 BODY** 重测 §6.2 的各项 | 同上 |
| G4 旧座清零 | 新模块与最终 BODY 的重叠为 0；O3 通道贯通；六孔边界与 R3.2 一致 | 同上 |
| G5 运动 | 主键 0–2.8°；滚轮载架 0–4.1°；侧键 0 到止挡（6.80° / 6.37°），再加 0.3°；每项 ≥ 21 个位置；卡舌和连接筋一起扫掠 | 最小间隙曲线 |
| G6 装配 | 装配顺序：微动和 PCB 装到托架上并焊好 → 托架从底部装入，用 2 颗 M2 × 5 固定 → 键帽从外侧装入（先插卡舌） → 钢销从顶面窗口压入 → 其余按 R3.2 原顺序。逐步检查装入路径和钢销视线 | `handoff/l2_r3/ASSEMBLY_SEQUENCE.md` |
| G7 元件 | H 方案全部放得下；D 方案只做占位检查 | 同上 |
| G8 刚度 | 最终 L2 BODY 在附录 A 的工况下，2.4 / 2.0 / 1.6 三档网格的刚度都 ≥ R3.2 的 100% | `handoff/l2_r3/INTERNAL_COMPONENTS_SIMULATION.md` |
| G9 模拟 S1–S9 | S1 静态干涉；S2 运动；S3 触发角和止挡角；S4 按压力分布；S5 光学高度；S6 电池和线束；S7 托架在 5 N 下、耳在预紧下的应力；S8 = G8；S9 质量 | 同上 |
| G10 质量 | 逐件 CAD 体积 × 密度，加上切片质量，与 17.42 g 对比 | `handoff/l2_r3/FINAL_ACCOUNTING.md` / `.json` |
| G11 侧键功能 | CAD：G5 的侧键部分全部通过，推杆压盘始终盖住按钮。实物：按 §4.5 调整，通断测试全部通过。没有实物时标 `UNVERIFIED` | `handoff/l2_r3/SIDE_KEY_FUNCTION.md` + `TUNING_LOG.md` |

### 6.2 侧键模块参考值（本文作者已用 BRep 验证：62 项间隙检查、8 项有意接触全部通过）

| 对象对 | 参考值 | 要求 |
|---|---:|---:|
| 托架 ↔ 侧壁内表面（已切开口） | 0.539 | ≥ 0.5 |
| 托架 ↔ 主键外铰座 | 0.508 | ≥ 0.5 |
| 托架 ↔ 后脚斜撑 | 0.624 | ≥ 0.5 |
| 托架 / SF 开关 / PCB ↔ 主键全行程扫掠 | 0.650 / 0.700 / 0.850 | ≥ 0.3 |
| SF 开关 ↔ 主键外铰座 | 0.500 | ≥ 0.5 |
| 止挡柱 ↔ 开关（SF / SR） | 0.500 / 0.500 | ≥ 0.5 |
| SIDE_IO_PCB ↔ 传感器安装耳 | 0.500 | ≥ 0.5 |
| H 电子包络（最小） | 2.2 | ≥ 0.5 |
| 卡舌和连接筋扫掠 ↔ 托架 | SF 0.994 / SR 0.469 | ≥ 0.3 |
| 卡舌和连接筋扫掠 ↔ 开关 | ≥ 0.795 | ≥ 0.3 |
| 卡舌静止 ↔ 端圈；连接筋 ↔ 端圈 | 贴合；0.30 | 贴合；≥ 0.3 |
| 按下后卡舌 ↔ 端圈 | ≥ 0.156 | > 0 |
| SF 卡舌 ↔ SR 卡舌 | 0.472 | ≥ 0.3 |
| PCB 安装座 ↔ 端子孔 | ≥ 0.837 | ≥ 0.5 |
| 安装块 ↔ 耳；开关 ↔ 底板 / 背托台；PCB ↔ 安装座 | 贴合（有意接触） | 无穿模 |

参考脚本和数据在 `D:\Quietmirror_L2\l2_r3_check\`。注意：本文作者的参考障碍物是从 R3.2 BODY 和母面提取的，最终 BODY 建好后必须重测。

---

## 7. 成品视图（全部从 §5.1 的一体式模型渲染，输出到 `views/l2_r3/`）

1. **六面正交视图（必须）：** 前（从 −Y）、后（从 +Y）、左（从 −X）、右（从 +X，侧键侧）、上（从 +Z）、下（从 −Z）。六张图**比例相同**（9 px/mm），标注投影外形尺寸、坐标轴和 10 mm 比例尺。
2. **等轴测（必须）：** 前 / +X / 上一张，后 / −X / 上一张。
3. **拼图（必须）：** 按第三角投影排布成 `L2_r3_H_SIX_VIEWS_SHEET.png`，附图例。
4. **另外：**
   - 去掉 BODY 的内部件六视图；
   - 侧键剖面：Z 16.6 水平剖面，Y 50.25 / 64.45 竖直剖面；
   - **侧键动作图**：静止 / 触发 / 止挡三个位置叠画；
   - 打印盘排布图；
   - R3.2 与 L2 r3 的顶、右、底对比图。

PNG 格式，单张宽 ≥ 1,000 px，不得用诊断件代替成品。可沿用 `D:\Quietmirror_L2\l2_repo_scan\render_views.py`（三角化 → 着色 → 特征线 → 六视图 + 等轴测拼图）。

---

## 8. 上传 GitHub，发布新版本

用户已于 2026-10-18 要求统一上传为新版本。目标仓库 `Quietmirror/Quietmirror-L2`（公开）。R3.2、R3.3、r1 / r2 复核记录全部保留，不得删除或改写历史。

1. **新建分支 `l2-r3`，按下面的结构提交：**

   ```
   specs/Quietmirror_L2_r3_FINAL_Build_and_Release_2026-10-18.md   （本文）
   specs/Quietmirror_L2_FINAL_Plan_2026-10-17.md                   （r3；旧版本移入 specs/archive/）
   specs/Quietmirror_L2_Repo_Scan_Recheck_2026-10-18.md
   cad/l2_r3/            对 R3.2 源码的修改和新零件脚本
   cad/l2_r3_check/      D:\Quietmirror_L2\l2_r3_check 下的 *.py、*.json、*.step
   cad/l2_fem_author/    D:\Quietmirror_L2\fem3d\*.py（只传脚本，供复核方重放 K3 / G8）
   cad/l2_repo_scan/     D:\Quietmirror_L2\l2_repo_scan\*.py
   models/L2_r3/         §5 的全部模型文件
   views/l2_r3/          §7 的全部视图
   reports/l2_r3/        检查数据（JSON）
   handoff/l2_r3/        SECOND_CHECK、PARAMETERS_CORRECTED、OPENINGS_RESOLUTION、INTERFERENCE_REPORT、ASSEMBLY_SEQUENCE、
                         SIDE_KEY_FUNCTION、INTERNAL_COMPONENTS_SIMULATION、FINAL_ACCOUNTING、TUNING_LOG
   README.md             更新：版本状态、六视图拼图、下载链接、G1–G11 表
   ```

2. **不要上传：** 工具链、虚拟环境、缓存、网格和求解中间文件（只保留摘要 JSON）、个人信息。单个文件超过 50 MB 的放到 Release 附件。
3. **合并：** 开 PR，从 `l2-r3` 合并到 `main`。PR 描述附上 G1–G11 表（通过 / 不通过 / UNVERIFIED）和六视图拼图。
4. **发布：** 合并后打 tag `L2-r3`，创建 Release “Quietmirror L2 r3”。附件：
   - 单盘 3MF、`FULL_ASSEMBLY_H.step`、`FULL_ASSEMBLY_H.FCStd`；
   - 六视图拼图；
   - 逐件 STEP / STL 压缩包；
   - `FINAL_ACCOUNTING.json`。
5. **版本状态如实标注：**
   - G1–G11 全部通过：标 `VERIFIED`；
   - 否则勾选 **pre-release**，标题写 `INCOMPLETE`，说明首段列出未通过项。

   D 方案和供体型号始终写“待用户确认”。
6. **许可证：** 保留 CERN-OHL-P-2.0 和原 NOTICE 署名。
7. **推送前**，在终端列出将要推送的文件清单、分支名和 tag。完成后，把 PR 链接、Release 链接和 commit SHA 回报给用户。

---

## 9. 回报给用户

1. G1–G11 表（数值 + 结论）；
2. 与本文数据的偏差，以及原因；
3. 六视图拼图（直接贴图）；
4. 打印盘排布、切片质量和时长；
5. 分支、PR、tag、Release 链接和 commit SHA；
6. 待用户确认的事项：供体型号；微动实测的 FP / OP / TTP；镜头高度；脚贴厚度。

**任何一项缺失、核算不闭合或 G8 不通过，状态都标为 INCOMPLETE。**

---

## 附录 A　整壳有限元（K3 / G8）

**材料和约束：** E 1500 MPa，ν 0.35，二次四面体单元 C3D10。
- 五个脚底面节点 Uz = 0；
- 左前脚中心附近一个节点 Ux = Uy = 0；
- 右前脚中心附近一个节点 Uy = 0。

**刚度：** k = F / δ，δ = Σ(f·u) / F，夹持工况取 F = 4。

| 工况 | 选面条件（表面三角形的中心坐标和外法向） | 合力 N |
|---|---|---|
| palm_down_20N | 44 ≤ y ≤ 71，\|x\| ≤ 24，z ≥ 23，nz > 0.3，且 \|z − roof_z\| < 0.35 | (0, 0, −20) |
| left / right_main_root_down_5N | root_y − 3 ≤ y ≤ root_y + 4，6 ≤ \|x\| ≤ 24（分左右），z ≥ 11，nz > 0.2 | (0, 0, −5) |
| side_i_switch_fence_inward_5N | \|x − (tip_x − 7.5)\| < 0.04，\|y − tip_y\| ≤ 7.25，\|z − tip_z\| ≤ 2.9，nx > 0.95（R3.2 基线用） | (−5, 0, 0) |
| LC3_squeeze_2x2N | \|x\| > 20，45 ≤ y ≤ 70，8 ≤ z ≤ 14，\|nx\| > 0.5，只取外侧面，两侧各 2 N 相向 | 自平衡 |
| press_A / B_d16 | 以 (14, 60) / (−14, 72) 为圆心半径 8 的圆内，z ≥ 18，nz > 0.3，外顶面 | (0, 0, −5) |

**网格：** gmsh 4.15.2，MeshSizeMax = h，MeshSizeMin = max(0.35, 0.38h)，**MeshSizeFromCurvature = 24**，MeshSizeExtendFromBoundary = 1，Algorithm = 6，Algorithm3D = 1，ElementOrder = 2，SecondOrderLinear = 1，Optimize = 1。

**参考实现：** `D:\Quietmirror_L2\fem3d\fem_variants.py`。L2 侧键改版后，侧键挡墙工况要改成加载在新托架安装耳上的等效反力，并写明定义。

## 附录 B　证据文件（`D:\Quietmirror_L2\l2_r3_check\`）

| 文件 | 内容 |
|---|---|
| `r3_parameters.json` | 唯一数据源 |
| `r3_carrier_check.py` / `r3_check.json` | 托架、开关、PCB、卡舌的 BRep 检查 |
| `side_key_actuation.py` / `side_key_actuation.json` | 侧键动作计算 |
| `old_seat_check.py` / `old_seat_check.json` / `R32_OLD_SIDE_SEAT_RECONSTRUCTED.step` | 旧座重建和重叠核实 |
| `R3_SIDE_SWITCH_CARRIER.step` / `R3_SIDE_MODULE_LAYOUT.step` | 参考几何 |
| `views/R3_*.png` | 模块视图 |

## 附录 C　来源

- [Omron D2F 数据手册](https://omronfs.omron.com/en_US/ecb/products/pdf/en-d2f.pdf)
- [Omron D2LS 数据手册](https://omronfs.omron.com/en_US/ecb/products/pdf/en-d2ls.pdf)
- [Periview：Fenrir Max / Asym](https://periview.gg/?p=4710)
- [Periview：Fenrir 对比](https://periview.gg/?p=4631)
- [TechPowerUp：G-Wolves HTX 4K](https://techpowerup.com/review/g-wolves-htx-4k/4.html)
- [MouseLog：Fenrir Pro 8K](https://mouselog.jp/en/products/G-Wolves%20Fenrir%20Pro%208K)
- [Quietmirror-L2 复核仓库](https://github.com/Quietmirror/Quietmirror-L2)
