Quietmirror/Quietmirror-L2/views/l2_r3/PRINT_PLATE.png

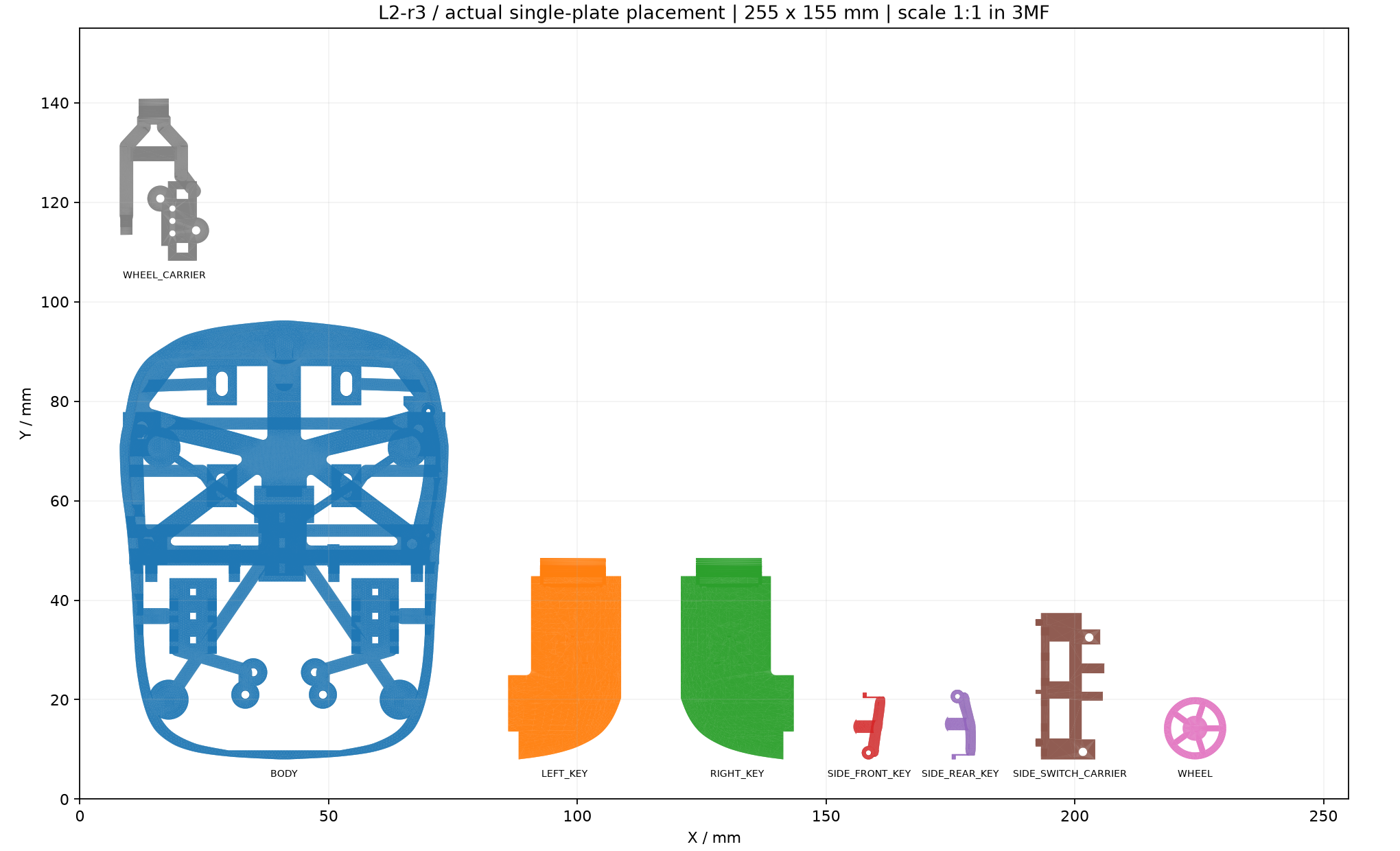
views/l2_r3/PRINT_PLATE.png
