Quietmirror/Quietmirror-L2/views/l2_r4/PRINT_PLATE.png

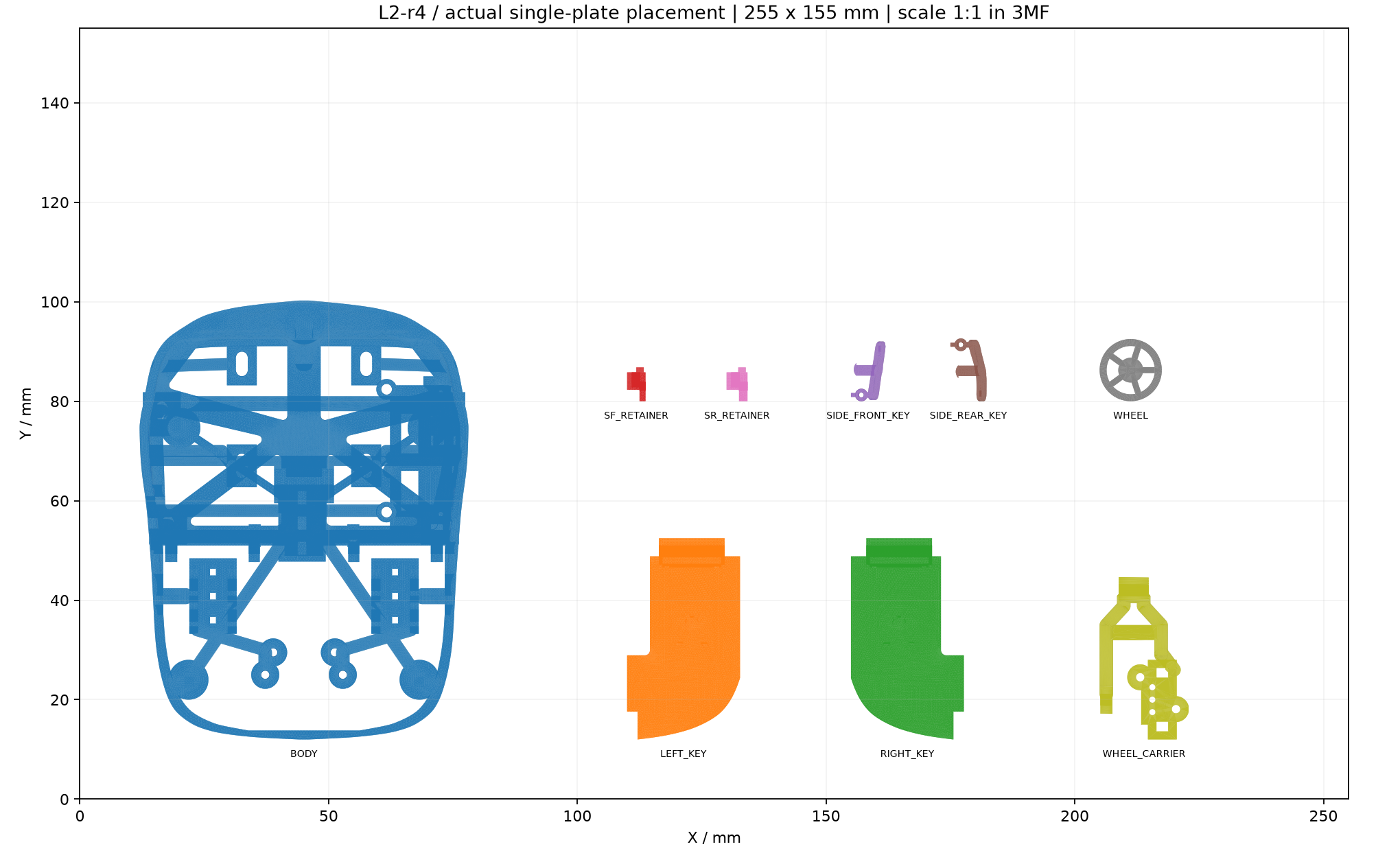
views/l2_r4/PRINT_PLATE.png
