Quietmirror/Quietmirror-L2/handoff/l2_r3/TUNING_LOG.md

# 侧键实物调试记录 · 未执行

| 项目 | SF | SR |
|---|---|---|
| 微动实际型号/批次 | 待测 | 待测 |
| FP / OP / TTP | 待测 | 待测 |
| 无垫片静止间隙 | 待测 | 待测 |
| PET厚度、调整后间隙 | 待测 | 待测 |
| 触发后余量及压盘/外壳间隙 | 待测 | 待测 |
| 中点10次触发/复位 | UNVERIFIED | UNVERIFIED |
| 近铰端10次触发/复位 | UNVERIFIED | UNVERIFIED |
| 远端10次触发/复位 | UNVERIFIED | UNVERIFIED |

记录真实结果后再更改状态，不能用CAD姿态替代通断试验。
