Quietmirror/Quietmirror-L2/(commit log)

2026-10-18 Publish L2 independent review, diagnostic CAD and R3.2 baseline
    Include K1-K10 evidence, review sources, baseline FreeCAD inputs, renders, licenses and reproduction guidance. Keep final geometry and hardware-fit acceptance explicitly incomplete.
2026-10-18 Adopt L2 r2 plan and review revised geometry and FEM baseline
    Preserve the r1 plan and review. Add independent K3/K5/K6/K8/K9/K10 evidence, three baseline mesh levels, carrier/contact diagnostic STEP files, four figures, corrected-parameter notes and a reproducible review package.
    The carrier is connected, but mounting-ear, hinge and sidewall clearance issues remain. Baseline reproduction/convergence and final L2 production acceptance remain incomplete.
2026-10-19 Build L2-r3 lever side-key prototype and measured INCOMPLETE release
    Preserve R3.2 and prior review history. Add editable CAD, measured validation,
    real single-plate slice, orthographic views and explicit unresolved gates.
    Materialize the reviewed model bundle before merging the prerelease.
2026-10-19 Materialize reviewed L2-r3 models, checks and views
2026-10-19 Add L2-r4 CAD-complete spec and author evidence (no release)
    Spec for making every non-hardware gate of L2-r3 COMPLETED: side frame printed in BODY, split retainers,
    lower cross tie, bearing struts, thicker Y67.5 tie. Includes author FEM (3 meshes, all six cases >=106.9% of R3.2),
    interference and side-key stop checks, r3 side-module data and scripts.
2026-10-19 Add L2-r4 execute-all spec and verified insertion routes
    Execute-all spec (modelling, gates G1-G11, views, release). Insertion routes for SR/SF switches and retainers
    verified on the V2 BODY voxels (759 poses, >=0.25 mm, cumulative obstacles). Exact BRep check shows the r3
    tab-first key-cap route collides (up to 2.04 mm3); spec replaces it with D7 (straight insertion, hinge stop ear).
    loose_parts.json: SF retainer ends at Y55.0 (0.3 mm gap to SR retainer).
2026-10-19 fix(r4): accept CalculiX version probe success convention
2026-10-19 fix(r4): center pad coverage over full travel and audit final insertion geometry
2026-10-19 fix(r4): clear cap insertion and rebuild supported retainer interfaces at source
2026-10-19 Fix measured assembly access clashes and independently audit full motion and real terminal routes
2026-10-19 Independently inspect D7 bearing and pin containment against the original mother profile
2026-10-19 Inspect inward D7 bearing repair against actual mother surface
2026-10-19 Verify corrected C6 components with complete CAD, native assembly and actual slicing evidence
2026-10-19 Relieve cap journal thrust interference and rear hidden ear clearance without changing BODY
2026-10-19 Validate concealed cap correction with independent CAD and actual print jobs; retain release gates
2026-10-19 Correct rod floor clearance and cap inner corners without modifying the final BODY
2026-10-19 Refine measured cap perimeter clearances and route wire segments away from adjacent hardware
2026-10-19 C10: remove the measured cap/PET rod crescent at source and verify exact interfaces
2026-10-19 C11: clear complete wheel sweep with local carrier, custom PCB and pin-length changes
2026-10-19 Construct pad backing join directly and restore frozen baseline inputs before wheel corrections
2026-10-19 Set hinge web behind rounded side-key skin to remove diagnosed edge-face self-interference
2026-10-19 Correct retainer lead-slot and divider clearances plus encoder-lug rail spacing at source
2026-10-19 R4 final candidate: C17 planar encoder board and verified14x20x6 estimated cell; preserve C14 printed geometry
2026-10-19 Verify cap insertion against complete BODY and audit containment partitions
2026-10-19 Save complete-BODY cap insertion, window audit and 50 final CAD views; aggregate acceptance pending
2026-10-19 C18: relieve carrier rear underside by 0.20 mm; retain original BODY and interfaces
2026-10-19 Rebuild middle switch seat from source to remove transverse tie cap interference
2026-10-20 Pin source-generated C19A geometry and retain rejected repeated build for audit
2026-10-20 Run complete C19A CAD acceptance, native assembly and real slicing on identical geometry
2026-10-20 Render selected C19A assembly with complete side, window, contact and FEM evidence
2026-10-20 Build additive Dremel 3D45 PLA plate and assembled STL package
2026-10-20 Record actual Dremel 3D45 PLA print package and validation
2026-10-20 Publish verified 3D45 PLA print files with measured slice report
